ExcessiveOverkill/controller-hardware-dev/KiCad/Main Mezzanine Backplane/Main Mezzanine Backplane.step

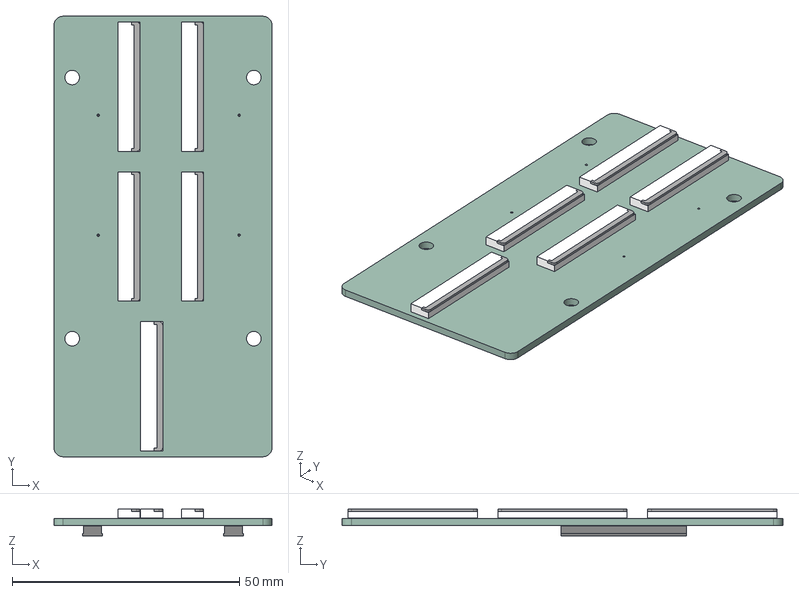
[picture p1: CAD file, 2026-01-15]
KiCad/Main Mezzanine Backplane/Main Mezzanine Backplane.step
48.0 x 97.0 x 5.90 mm
FPC-05FB-50PH20 x 5
BB0500220F-1002C-001 x 2
Main Mezzanine Backplane_PCB
