ExcessiveOverkill/controller-hardware-dev/KiCad/16x Card Module/16x Card Module.step

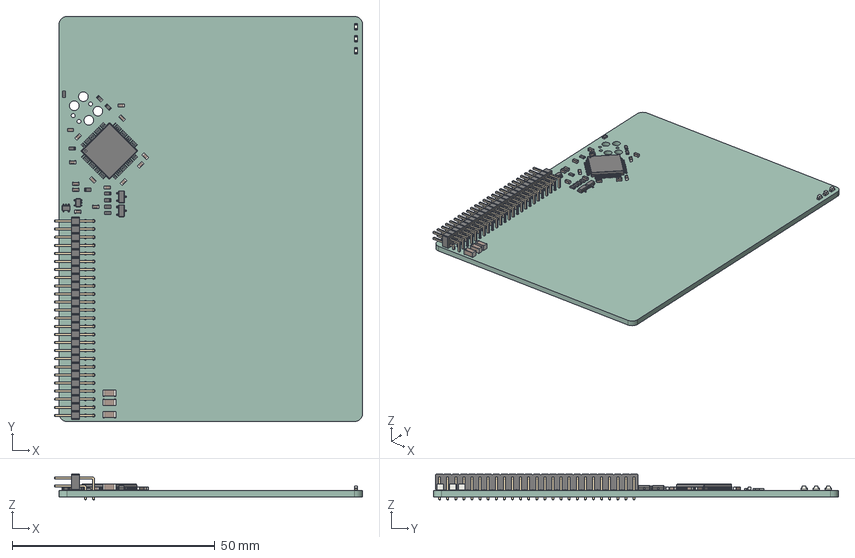
[picture p2: CAD file, 2026-01-15]
KiCad/16x Card Module/16x Card Module.step
76.2 x 100.0 x 6.40 mm
C_0603_1608Metric x 14
C_1206_3216Metric x 3
LED_0603_1608Metric x 3
R_0603_1608Metric x 9
SOT_353_SC_70_5 x 2
SOT_23 x 2
PinHeader_2x25_P200mm_Horizontal
LQFP_64_10x10mm_P05mm
16x Card Module_PCB
