ExcessiveOverkill/controller-hardware-dev/KiCad/Mezzanine Backplane/Mezzanine Backplane.step

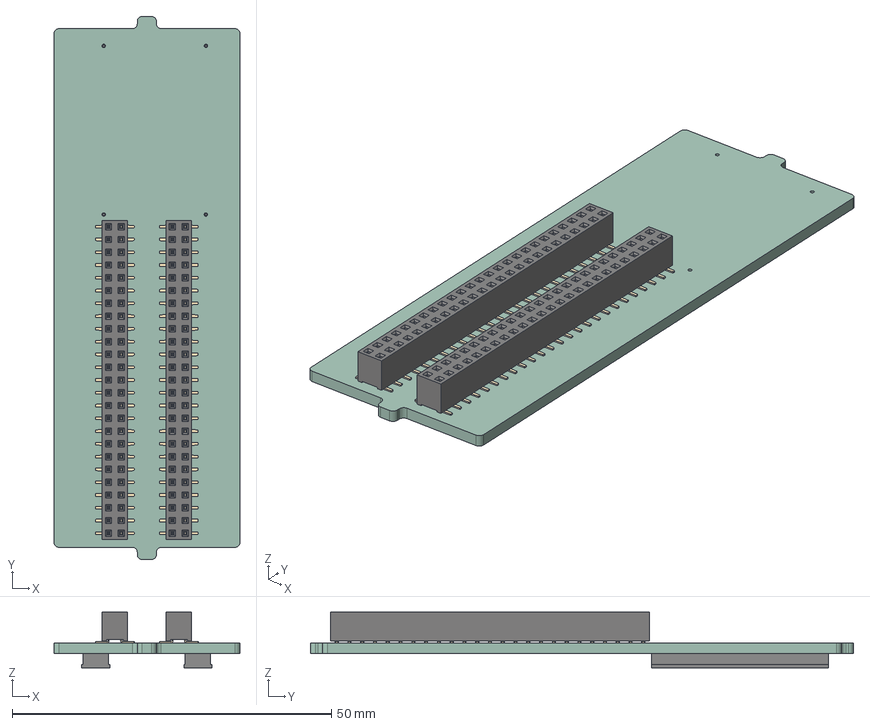
[picture p3: CAD file, 2026-01-15]
KiCad/Mezzanine Backplane/Mezzanine Backplane.step
29.1 x 85.0 x 8.70 mm
PinSocket_2x25_P200mm_Vertical_SMD x 2
BB0500220F-1002C-001 x 2
Mezzanine Backplane_PCB
