ExcessiveOverkill/controller-hardware-dev/KiCad/Mezzanine Jumper up16/Mezzanine Jumper up16.step

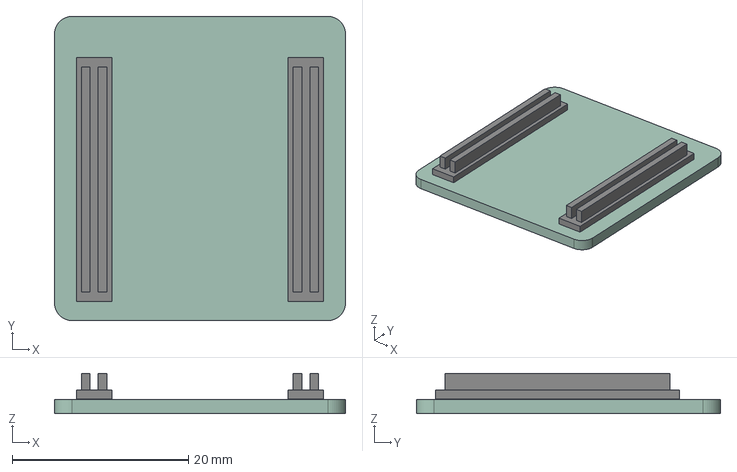
[picture p4: CAD file, 2026-01-15]
KiCad/Mezzanine Jumper up16/Mezzanine Jumper up16.step
33.0 x 34.5 x 4.55 mm
BB0500100M-1002C-001 x 2
Mezzanine jumper_PCB
