ExcessiveOverkill/controller-hardware-dev/KiCad/Modular MiYR interface/Modular MiYR interface.step

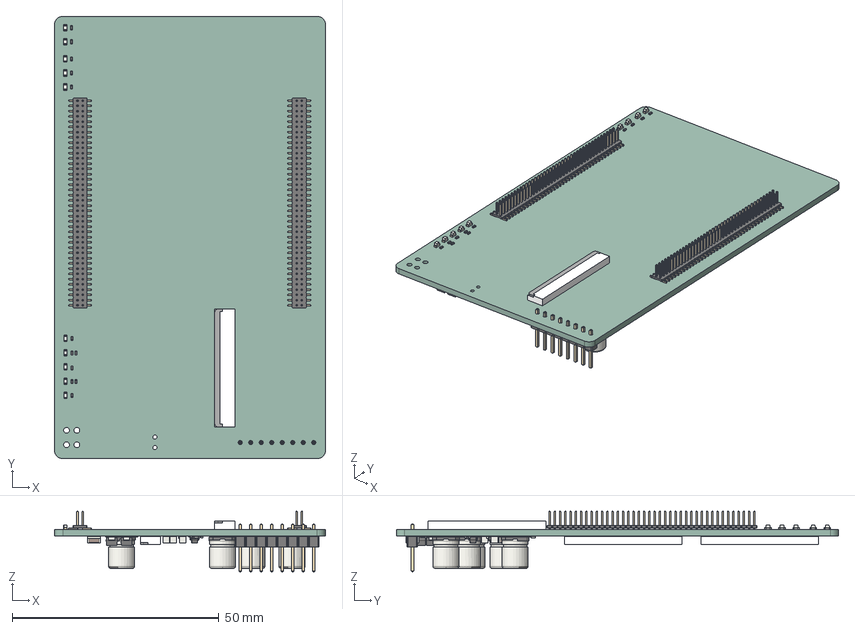
[picture p5: CAD file, 2026-01-15]
KiCad/Modular MiYR interface/Modular MiYR interface.step
65.5 x 107.0 x 14.6 mm
R_0402_1005Metric x 24
LED_0603_1608Metric x 10
PinHeader_2x40_P127mm_Vertical_SMD x 2
FPC-05FB-50PH20 x 5
CP_Elec_63x77 x 7
D_SMA x 3
C_1206_3216Metric x 11
Fuse_1206_3216Metric
PinHeader_1x08_P254mm_Vertical
C_0402_1005Metric x 9
SOT_23_6 x 3
Modular MiYR interface_PCB
