ExcessiveOverkill/controller-hardware-dev/KiCad/Serial Module/Serial Module.kicad_pcb

## KiCad design KiCad/Serial Module/Serial Module.kicad_pcb (2026-10-19)

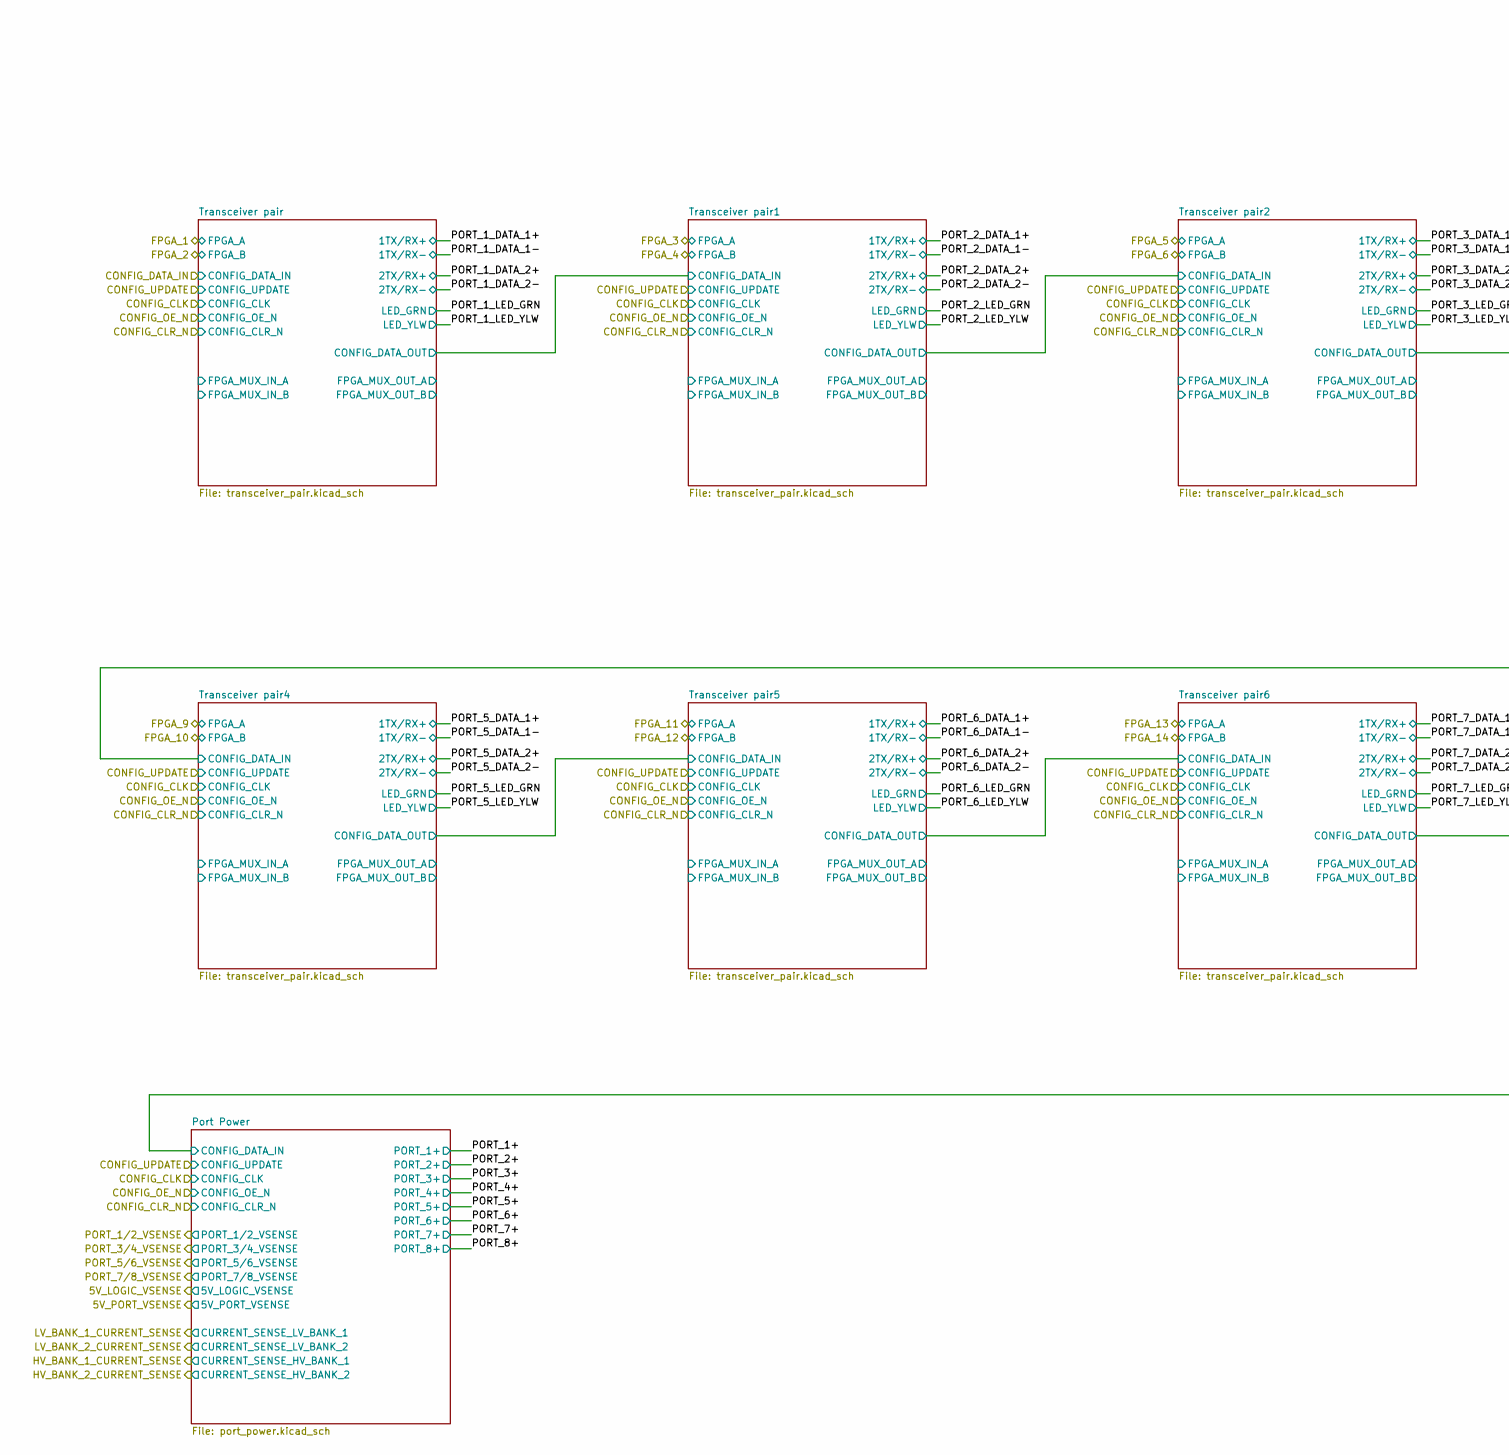
[picture p6: schematic transceivers.kicad_sch, part in row 1, column 1]

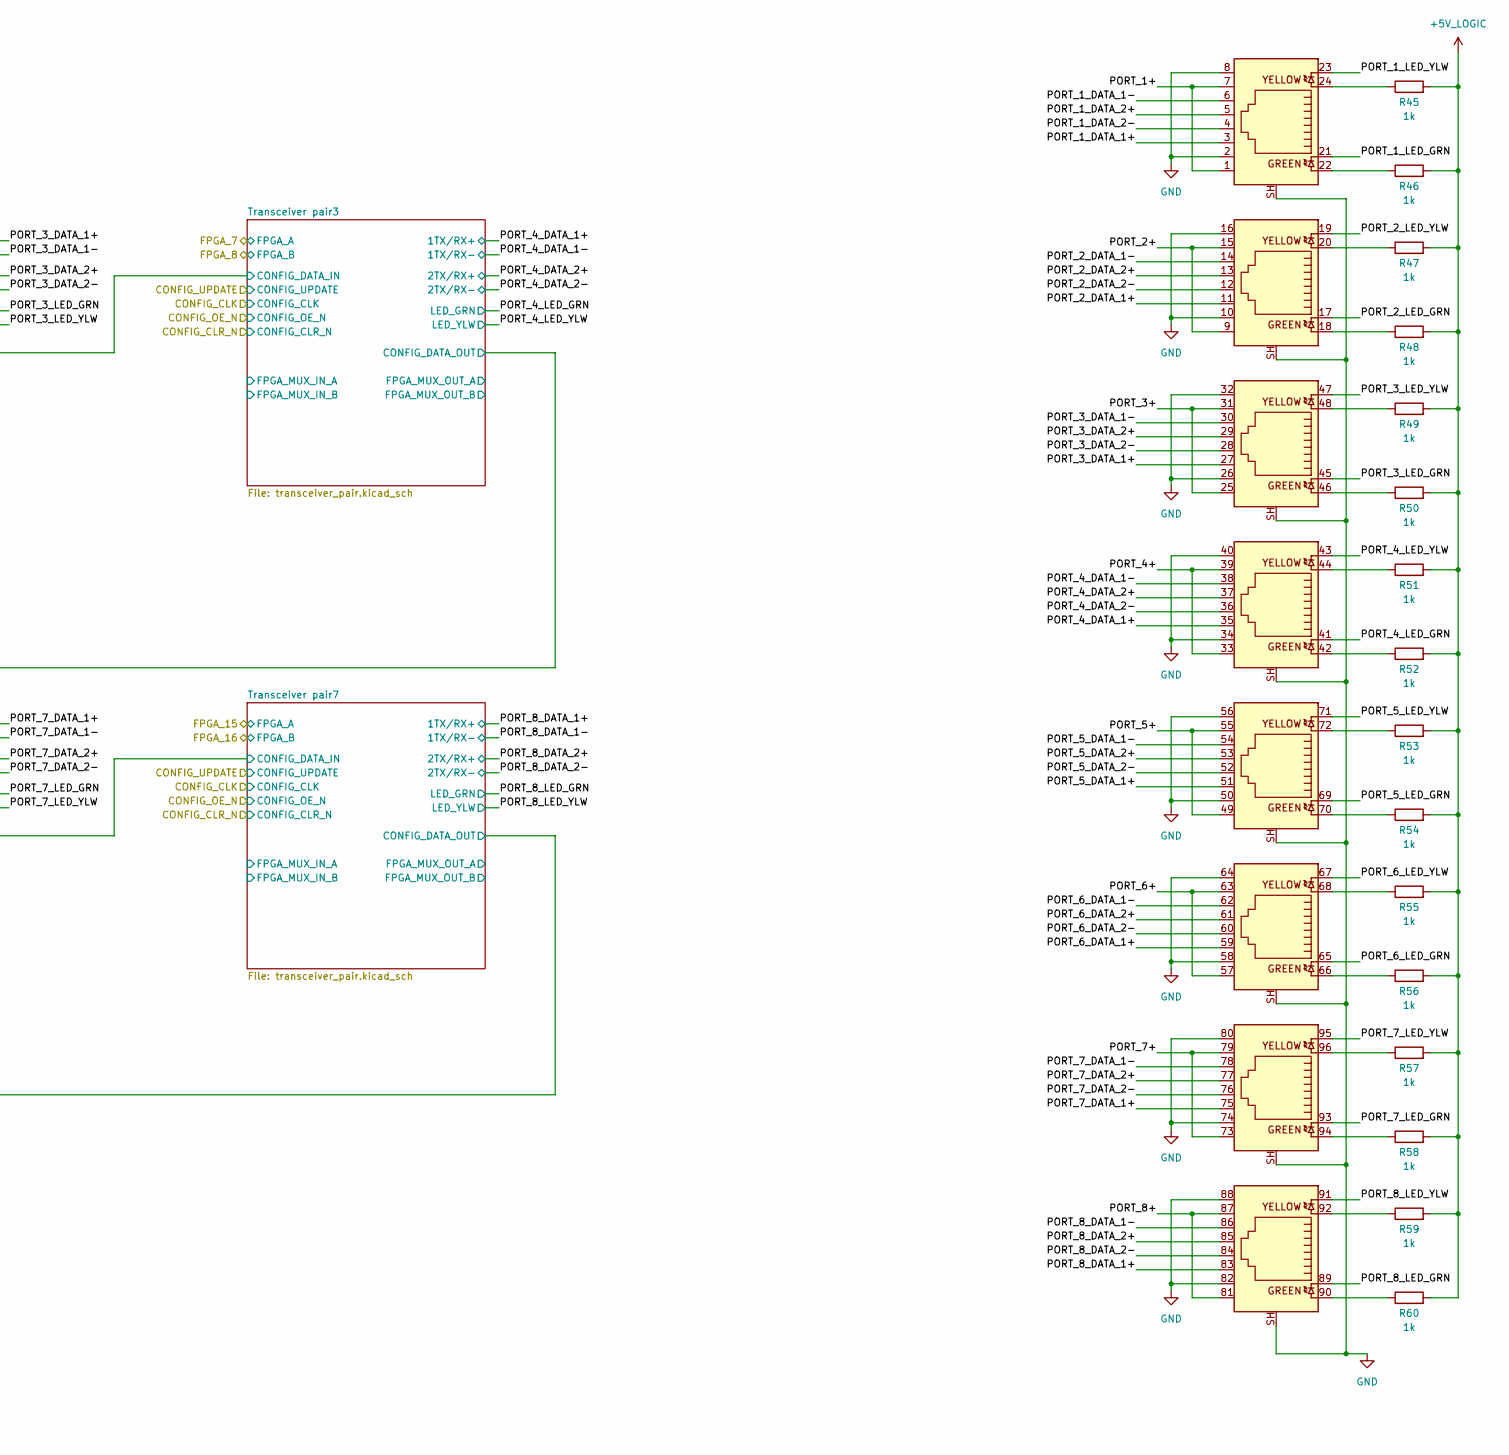
[picture p7: schematic transceivers.kicad_sch, part in row 1, column 2]

Parts:
J3: RJ45-TH_HC-RJ45-059D-2X4-2-04; LCSC# C46261621
R45, R46, R47, R48, R49, R50, R51, R52, R53, R54, R55, R56, R57, R58, R59, R60: 1k; R_0603_1608Metric

Connections:
+5V_LOGIC: R45.2, R46.2, R47.2, R48.2, R49.2, R50.2, R51.2, R52.2, R53.2, R54.2, R55.2, R56.2, R57.2, R58.2, R59.2, R60.2; also elsewhere on the board
/Transceivers/PORT_1+: J3.1, J3.7; also elsewhere on the board
/Transceivers/PORT_1_DATA_1+: J3.3; also elsewhere on the board
/Transceivers/PORT_1_DATA_1-: J3.6; also elsewhere on the board
/Transceivers/PORT_1_DATA_2+: J3.5; also elsewhere on the board
/Transceivers/PORT_1_DATA_2-: J3.4; also elsewhere on the board
/Transceivers/PORT_1_LED_GRN: J3.21; also elsewhere on the board
/Transceivers/PORT_1_LED_YLW: J3.23; also elsewhere on the board
/Transceivers/PORT_2+: J3.9, J3.15; also elsewhere on the board
/Transceivers/PORT_2_DATA_1+: J3.11; also elsewhere on the board
/Transceivers/PORT_2_DATA_1-: J3.14; also elsewhere on the board
/Transceivers/PORT_2_DATA_2+: J3.13; also elsewhere on the board
/Transceivers/PORT_2_DATA_2-: J3.12; also elsewhere on the board
/Transceivers/PORT_2_LED_GRN: J3.17; also elsewhere on the board
/Transceivers/PORT_2_LED_YLW: J3.19; also elsewhere on the board
/Transceivers/PORT_3+: J3.25, J3.31; also elsewhere on the board
/Transceivers/PORT_3_DATA_1+: J3.27; also elsewhere on the board
/Transceivers/PORT_3_DATA_1-: J3.30; also elsewhere on the board
/Transceivers/PORT_3_DATA_2+: J3.29; also elsewhere on the board
/Transceivers/PORT_3_DATA_2-: J3.28; also elsewhere on the board
/Transceivers/PORT_3_LED_GRN: J3.45; also elsewhere on the board
/Transceivers/PORT_3_LED_YLW: J3.47; also elsewhere on the board
/Transceivers/PORT_4+: J3.33, J3.39; also elsewhere on the board
/Transceivers/PORT_4_DATA_1+: J3.35; also elsewhere on the board
/Transceivers/PORT_4_DATA_1-: J3.38; also elsewhere on the board
/Transceivers/PORT_4_DATA_2+: J3.37; also elsewhere on the board
/Transceivers/PORT_4_DATA_2-: J3.36; also elsewhere on the board
/Transceivers/PORT_4_LED_GRN: J3.41; also elsewhere on the board
/Transceivers/PORT_4_LED_YLW: J3.43; also elsewhere on the board
/Transceivers/PORT_5+: J3.49, J3.55; also elsewhere on the board
/Transceivers/PORT_5_DATA_1+: J3.51; also elsewhere on the board
/Transceivers/PORT_5_DATA_1-: J3.54; also elsewhere on the board
/Transceivers/PORT_5_DATA_2+: J3.53; also elsewhere on the board
/Transceivers/PORT_5_DATA_2-: J3.52; also elsewhere on the board
/Transceivers/PORT_5_LED_GRN: J3.69; also elsewhere on the board
/Transceivers/PORT_5_LED_YLW: J3.71; also elsewhere on the board
/Transceivers/PORT_6+: J3.57, J3.63; also elsewhere on the board
/Transceivers/PORT_6_DATA_1+: J3.59; also elsewhere on the board
/Transceivers/PORT_6_DATA_1-: J3.62; also elsewhere on the board
/Transceivers/PORT_6_DATA_2+: J3.61; also elsewhere on the board
/Transceivers/PORT_6_DATA_2-: J3.60; also elsewhere on the board
/Transceivers/PORT_6_LED_GRN: J3.65; also elsewhere on the board
/Transceivers/PORT_6_LED_YLW: J3.67; also elsewhere on the board
/Transceivers/PORT_7+: J3.73, J3.79; also elsewhere on the board
/Transceivers/PORT_7_DATA_1+: J3.75; also elsewhere on the board
/Transceivers/PORT_7_DATA_1-: J3.78; also elsewhere on the board
/Transceivers/PORT_7_DATA_2+: J3.77; also elsewhere on the board
/Transceivers/PORT_7_DATA_2-: J3.76; also elsewhere on the board
/Transceivers/PORT_7_LED_GRN: J3.93; also elsewhere on the board
/Transceivers/PORT_7_LED_YLW: J3.95; also elsewhere on the board
/Transceivers/PORT_8+: J3.81, J3.87; also elsewhere on the board
/Transceivers/PORT_8_DATA_1+: J3.83; also elsewhere on the board
/Transceivers/PORT_8_DATA_1-: J3.86; also elsewhere on the board
/Transceivers/PORT_8_DATA_2+: J3.85; also elsewhere on the board
/Transceivers/PORT_8_DATA_2-: J3.84; also elsewhere on the board
/Transceivers/PORT_8_LED_GRN: J3.89; also elsewhere on the board
/Transceivers/PORT_8_LED_YLW: J3.91; also elsewhere on the board
GND: J3.2, J3.8, J3.10, J3.16, J3.26, J3.32, J3.34, J3.40, J3.50, J3.56, J3.58, J3.64, J3.74, J3.80, J3.82, J3.88, J3.SH; also elsewhere on the board
unnamed: J3.18, R48.1
unnamed: J3.20, R47.1
unnamed: J3.22, R46.1
unnamed: J3.24, R45.1
unnamed: J3.42, R52.1
unnamed: J3.44, R51.1
unnamed: J3.46, R50.1
unnamed: J3.48, R49.1
unnamed: J3.66, R56.1
unnamed: J3.68, R55.1
unnamed: J3.70, R54.1
unnamed: J3.72, R53.1
unnamed: J3.90, R60.1
unnamed: J3.92, R59.1
unnamed: J3.94, R58.1
unnamed: J3.96, R57.1

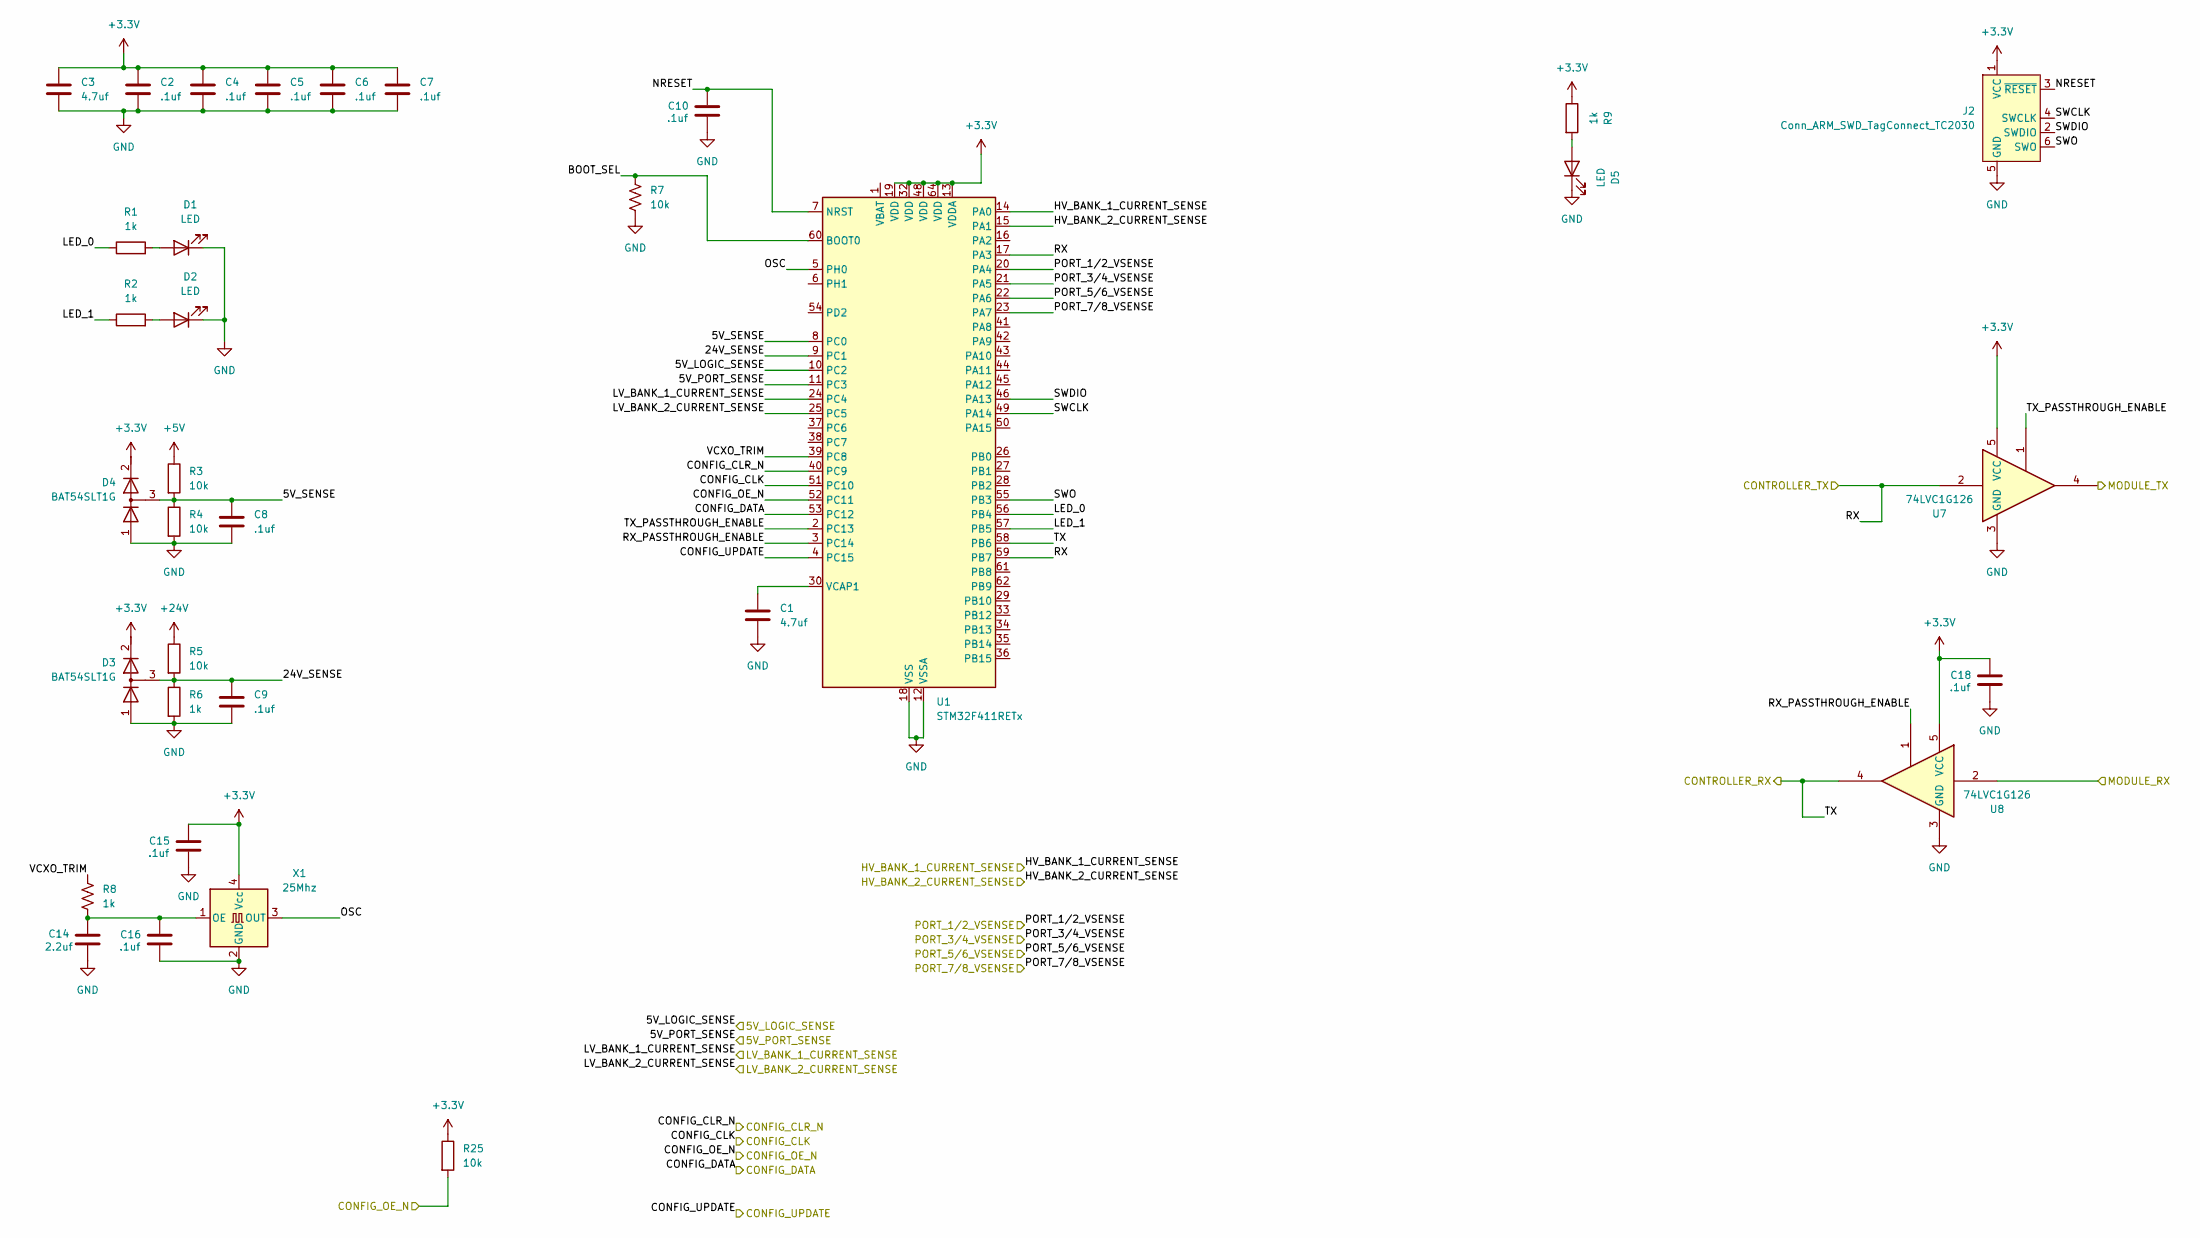
[picture p8: schematic MCU.kicad_sch]

Parts:
C1, C3: 4.7uf; C_0603_1608Metric
C2, C4, C5, C6, C7, C8, C9: .1uf; C_0603_1608Metric
C10, C15, C16, C18: .1uf; C_0603_1608Metric; Part number CC0402KRX5R9BB104; LCSC# C105882
C14: 2.2uf; C_0603_1608Metric; Part number CL31B225KBHNNNE; LCSC# C50254
D1, D2, D5: LED; LED_0603_1608Metric
D3, D4: BAT54SLT1G; SOT-23; Part number LBAT54SLT1G; LCSC# C12765
J2: Conn_ARM_SWD_TagConnect_TC2030; Tag-Connect_TC2030-IDC-FP_2x03_P1.27mm_Vertical
R1, R2, R6, R9: 1k; R_0603_1608Metric
R3, R4, R5, R25: 10k; R_0603_1608Metric
R7: 10k; R_0603_1608Metric; Part number RC0402FR-0710KL; LCSC# C60490
R8: 1k; R_0603_1608Metric; Part number RC0402FR-071KL; LCSC# C106235
U1: STM32F411RETx; LQFP-64_10x10mm_P0.5mm_smaller_pads
U7, U8: 74LVC1G126; SOT-353_SC-70-5; Part number 74LVC1G126CT05ARCQ; LCSC# C48391411
X1: 25Mhz; Oscillator_SMD_SeikoEpson_SG8002CE-4Pin_3.2x2.5mm; Part number SX3V25.000B20100F30TNN; LCSC# C5179998

Connections:
+3.3V: C2.1, C3.1, C4.1, C5.1, C6.1, C7.1, C15.2, C18.2, D3.2 (K), D4.2 (K), J2.1 (VCC), R9.1, R25.1, U1.13 (VDDA), U1.19 (VDD), U1.32 (VDD), U1.48 (VDD), U1.64 (VDD), U7.5 (VCC), U8.5 (VCC), X1.4 (Vcc); also elsewhere on the board
+5V: R3.1; also elsewhere on the board
+24V: R5.1; also elsewhere on the board
/FPGA Connector/MODULE_RX: U8.2; also elsewhere on the board
/FPGA Connector/MODULE_TX: U7.4; also elsewhere on the board
/MCU/5V_LOGIC_SENSE: U1.10 (PC2); also elsewhere on the board
/MCU/5V_PORT_SENSE: U1.11 (PC3); also elsewhere on the board
/MCU/5V_SENSE: C8.1, D4.3 (common), R3.2, R4.1, U1.8 (PC0)
/MCU/24V_SENSE: C9.1, D3.3 (common), R5.2, R6.1, U1.9 (PC1)
/MCU/BOOT_SEL: R7.2, U1.60 (BOOT0)
/MCU/CONFIG_CLK: U1.51 (PC10); also elsewhere on the board
/MCU/CONFIG_CLR_N: U1.40 (PC9); also elsewhere on the board
/MCU/CONFIG_DATA: U1.53 (PC12); also elsewhere on the board
/MCU/CONFIG_OE_N: R25.2, U1.52 (PC11); also elsewhere on the board
/MCU/CONFIG_UPDATE: U1.4 (PC15); also elsewhere on the board
/MCU/HV_BANK_1_CURRENT_SENSE: U1.14 (PA0); also elsewhere on the board
/MCU/HV_BANK_2_CURRENT_SENSE: U1.15 (PA1); also elsewhere on the board
/MCU/LED_0: R1.1, U1.56 (PB4)
/MCU/LED_1: R2.1, U1.57 (PB5)
/MCU/LV_BANK_1_CURRENT_SENSE: U1.24 (PC4); also elsewhere on the board
/MCU/LV_BANK_2_CURRENT_SENSE: U1.25 (PC5); also elsewhere on the board
/MCU/NRESET: C10.2, J2.3 (~RESET), U1.7 (NRST)
/MCU/OSC: U1.5 (PH0), X1.3 (OUT)
/MCU/PORT_1/2_VSENSE: U1.20 (PA4); also elsewhere on the board
/MCU/PORT_3/4_VSENSE: U1.21 (PA5); also elsewhere on the board
/MCU/PORT_5/6_VSENSE: U1.22 (PA6); also elsewhere on the board
/MCU/PORT_7/8_VSENSE: U1.23 (PA7); also elsewhere on the board
/MCU/RX: U1.17 (PA3), U1.59 (PB7), U7.2; also elsewhere on the board
/MCU/RX_PASSTHROUGH_ENABLE: U1.3 (PC14), U8.1
/MCU/SWCLK: J2.4 (SWCLK), U1.49 (PA14)
/MCU/SWDIO: J2.2 (SWDIO), U1.46 (PA13)
/MCU/SWO: J2.6 (SWO), U1.55 (PB3)
/MCU/TX: U1.58 (PB6), U8.4; also elsewhere on the board
/MCU/TX_PASSTHROUGH_ENABLE: U1.2 (PC13), U7.1
/MCU/VCXO_TRIM: R8.1, U1.39 (PC8)
GND: C1.2, C2.2, C3.2, C4.2, C5.2, C6.2, C7.2, C8.2, C9.2, C10.1, C14.1, C15.1, C16.1, C18.1, D1.1 (K), D2.1 (K), D3.1 (A), D4.1 (A), D5.1 (K), J2.5 (GND), R4.2, R6.2, R7.1, U1.12 (VSSA), U1.18 (VSS), U1.31 (VSS), U1.47 (VSS), U1.63 (VSS), U7.3 (GND), U8.3 (GND), X1.2 (GND); also elsewhere on the board
unnamed: D1.2 (A), R1.2
unnamed: D2.2 (A), R2.2
unnamed: D5.2 (A), R9.2
unnamed: C1.1, U1.30 (VCAP1)
unnamed: C14.2, C16.2, R8.2, X1.1 (OE)

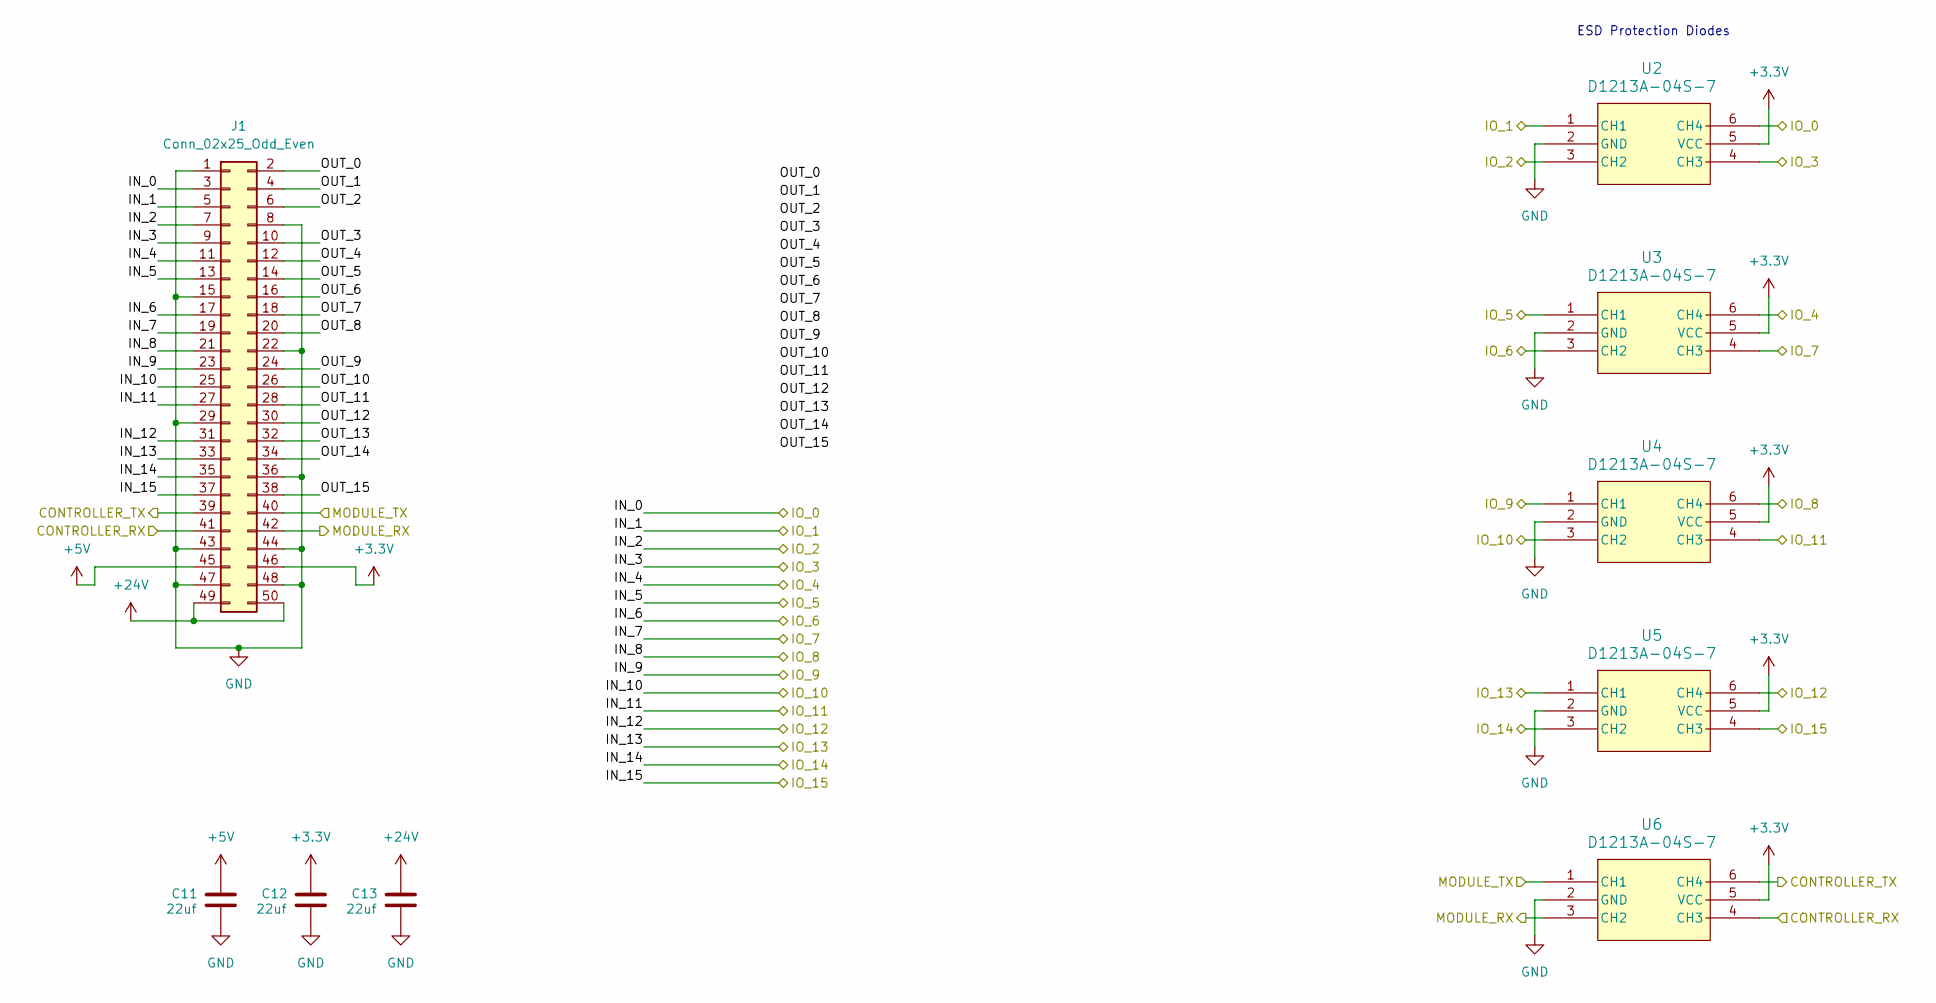
[picture p9: schematic FPGA_Connector.kicad_sch]

Parts:
C11, C12, C13: 22uf; C_1206_3216Metric; Part number CL31A226KAHNNNE; LCSC# C12891
J1: Conn_02x25_Odd_Even; 16x_modular_card; Part Number X4621WR-2x25I-C40D28; LCSC# C2883281
U2, U3, U4, U5, U6: D1213A-04S-7; SOT-363_DIO; Part Number D1213A-04S-7-ES; LCSC# C41409235

Connections:
+3.3V: C12.2, J1.46, U2.5 (VCC), U3.5 (VCC), U4.5 (VCC), U5.5 (VCC), U6.5 (VCC); also elsewhere on the board
+5V: C11.2, J1.45; also elsewhere on the board
+24V: C13.2, J1.49, J1.50; also elsewhere on the board
/FPGA Connector/IN_0: J1.3, U2.6 (CH4); also elsewhere on the board
/FPGA Connector/IN_1: J1.5, U2.1 (CH1); also elsewhere on the board
/FPGA Connector/IN_2: J1.7, U2.3 (CH2); also elsewhere on the board
/FPGA Connector/IN_3: J1.9, U2.4 (CH3); also elsewhere on the board
/FPGA Connector/IN_4: J1.11, U3.6 (CH4); also elsewhere on the board
/FPGA Connector/IN_5: J1.13, U3.1 (CH1); also elsewhere on the board
/FPGA Connector/IN_6: J1.17, U3.3 (CH2); also elsewhere on the board
/FPGA Connector/IN_7: J1.19, U3.4 (CH3); also elsewhere on the board
/FPGA Connector/IN_8: J1.21, U4.6 (CH4); also elsewhere on the board
/FPGA Connector/IN_9: J1.23, U4.1 (CH1); also elsewhere on the board
/FPGA Connector/IN_10: J1.25, U4.3 (CH2); also elsewhere on the board
/FPGA Connector/IN_11: J1.27, U4.4 (CH3); also elsewhere on the board
/FPGA Connector/IN_12: J1.31, U5.6 (CH4); also elsewhere on the board
/FPGA Connector/IN_13: J1.33, U5.1 (CH1); also elsewhere on the board
/FPGA Connector/IN_14: J1.35, U5.3 (CH2); also elsewhere on the board
/FPGA Connector/IN_15: J1.37, U5.4 (CH3); also elsewhere on the board
/FPGA Connector/MODULE_RX: J1.42, U6.3 (CH2); also elsewhere on the board
/FPGA Connector/MODULE_TX: J1.40, U6.1 (CH1); also elsewhere on the board
/FPGA Connector/OUT_0: J1.2
/FPGA Connector/OUT_1: J1.4
/FPGA Connector/OUT_2: J1.6
/FPGA Connector/OUT_3: J1.10
/FPGA Connector/OUT_4: J1.12
/FPGA Connector/OUT_5: J1.14
/FPGA Connector/OUT_6: J1.16
/FPGA Connector/OUT_7: J1.18
/FPGA Connector/OUT_8: J1.20
/FPGA Connector/OUT_9: J1.24
/FPGA Connector/OUT_10: J1.26
/FPGA Connector/OUT_11: J1.28
/FPGA Connector/OUT_12: J1.30
/FPGA Connector/OUT_13: J1.32
/FPGA Connector/OUT_14: J1.34
/FPGA Connector/OUT_15: J1.38
/MCU/RX: J1.39, U6.6 (CH4); also elsewhere on the board
/MCU/TX: J1.41, U6.4 (CH3); also elsewhere on the board
GND: C11.1, C12.1, C13.1, J1.1, J1.8, J1.15, J1.22, J1.29, J1.36, J1.43, J1.44, J1.47, J1.48, U2.2 (GND), U3.2 (GND), U4.2 (GND), U5.2 (GND), U6.2 (GND); also elsewhere on the board

Notes on the sheet:
ESD Protection Diodes
