ExcessiveOverkill/controller-hardware-dev/KiCad/Serial Module/Serial Module.kicad_pcb

## KiCad design KiCad/Serial Module/Serial Module.kicad_pcb (continued)

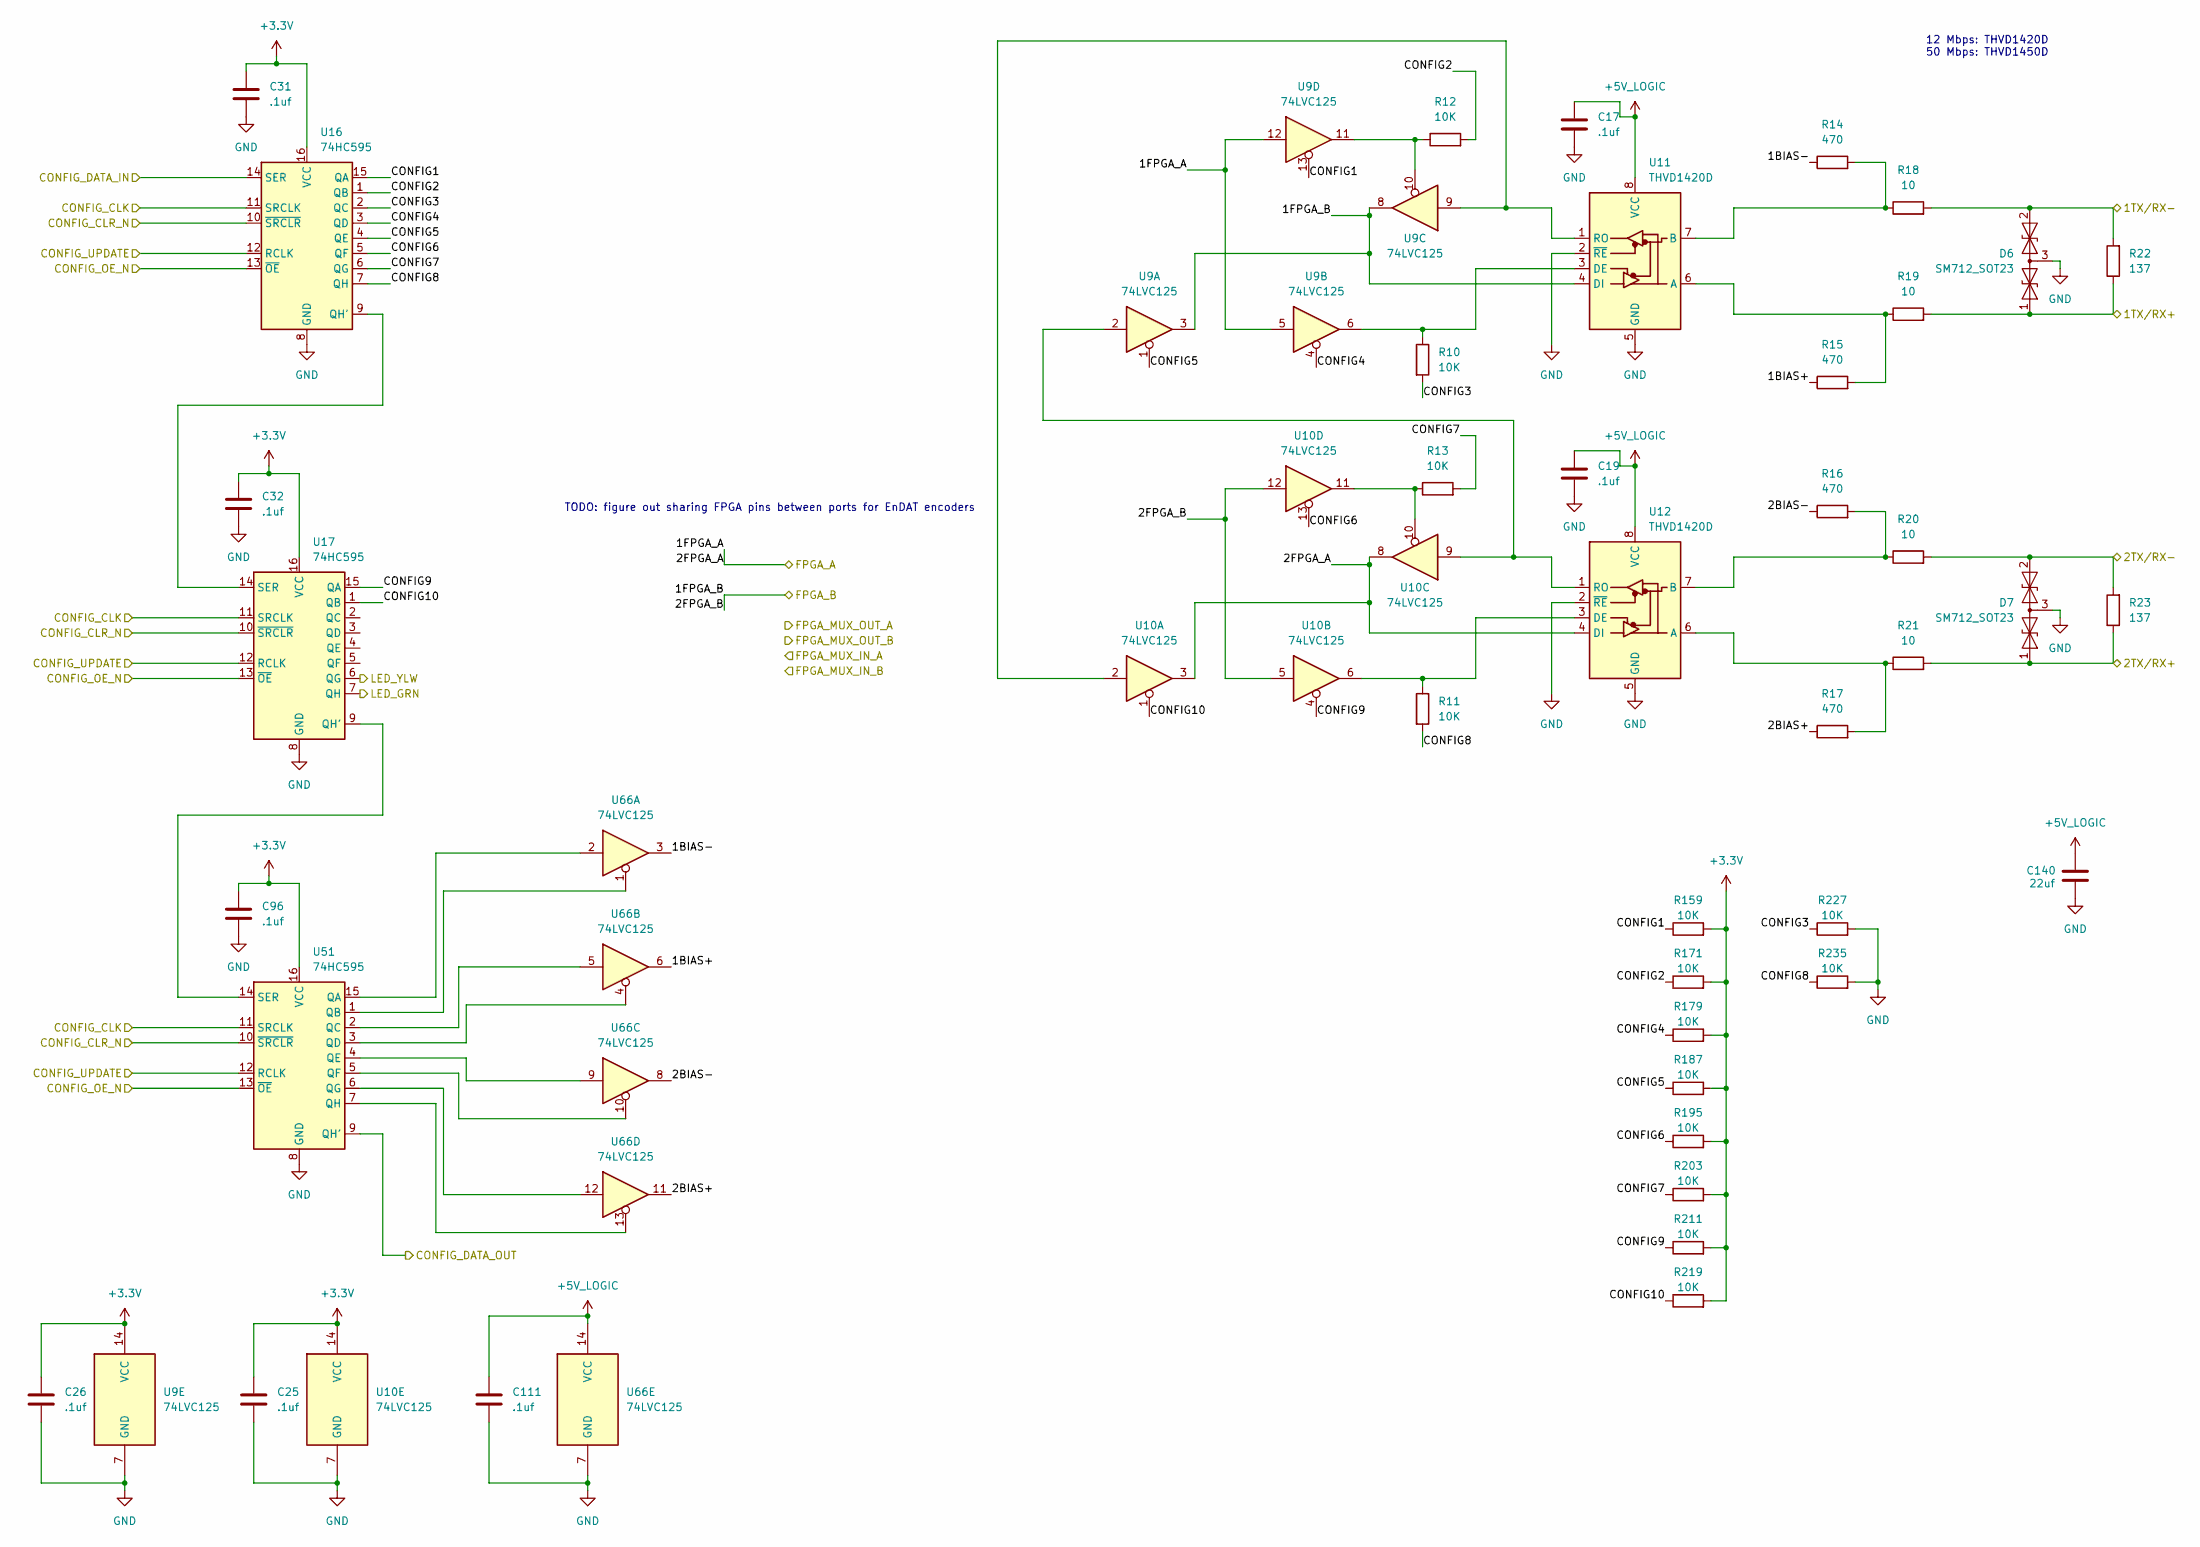
[picture p10: schematic transceiver_pair.kicad_sch]

Parts:
C17, C19, C25, C26, C31, C32, C96, C111: .1uf; C_0603_1608Metric
C140: 22uf; C_1206_3216Metric; Part number CL31A226KAHNNNE; LCSC# C12891
D6, D7: SM712_SOT23; SOT-23
R10, R11, R12, R13, R159, R171, R179, R187, R195, R203, R211, R219, R227, R235: 10K; R_0603_1608Metric
R14, R15, R16, R17: 470; R_0603_1608Metric
R18, R19: 10; R_0603_1608Metric
R20, R21: 10; R_0402_1005Metric
R22, R23: 137; R_0603_1608Metric
U9, U10: 74LVC125; DHVQFN-14-1EP_2.5x3mm_P0.5mm_EP1x1.5mm; LCSC# C54411083
U11, U12: THVD1420D; SOIC-8_4.9x3.91mm_P1.27mm; Part Number THVD1420DR; LCSC# C3235215
U16, U17, U51: 74HC595; TSSOP-16_4.4x5mm_P0.65mm; LCSC# C5948
U66: 74LVC125; DHVQFN-14-1EP_2.5x3mm_P0.5mm_EP1x1.5mm

Connections:
+3.3V: C25.1, C26.1, C31.1, C32.1, C96.1, R159.2, R171.2, R179.2, R187.2, R195.2, R203.2, R211.2, R219.2, U9.14 (VCC), U10.14 (VCC), U16.16 (VCC), U17.16 (VCC), U51.16 (VCC); also elsewhere on the board
+5V_LOGIC: C17.1, C19.1, C111.1, C140.2, U11.8 (VCC), U12.8 (VCC), U66.14 (VCC); also elsewhere on the board
/FPGA Connector/IN_0: U9.5, U9.12, U10.3, U10.8, U12.4 (DI); also elsewhere on the board
/FPGA Connector/IN_1: U9.3, U9.8, U10.5, U10.12, U11.4 (DI); also elsewhere on the board
/MCU/CONFIG_CLK: U16.11 (SRCLK), U17.11 (SRCLK), U51.11 (SRCLK); also elsewhere on the board
/MCU/CONFIG_CLR_N: U16.10 (~SRCLR), U17.10 (~SRCLR), U51.10 (~SRCLR); also elsewhere on the board
/MCU/CONFIG_DATA: U16.14 (SER); also elsewhere on the board
/MCU/CONFIG_OE_N: U16.13 (~OE), U17.13 (~OE), U51.13 (~OE); also elsewhere on the board
/MCU/CONFIG_UPDATE: U16.12 (RCLK), U17.12 (RCLK), U51.12 (RCLK); also elsewhere on the board
/Transceivers/PORT_1_DATA_1+: D6.1 (A1), R19.2, R22.1; also elsewhere on the board
/Transceivers/PORT_1_DATA_1-: D6.2 (A2), R18.2, R22.2; also elsewhere on the board
/Transceivers/PORT_1_DATA_2+: D7.1 (A1), R21.2, R23.1; also elsewhere on the board
/Transceivers/PORT_1_DATA_2-: D7.2 (A2), R20.2, R23.2; also elsewhere on the board
/Transceivers/PORT_1_LED_GRN: U17.7 (QH); also elsewhere on the board
/Transceivers/PORT_1_LED_YLW: U17.6 (QG); also elsewhere on the board
/Transceivers/Transceiver pair/1BIAS+: R15.1, U66.6
/Transceivers/Transceiver pair/1BIAS-: R14.1, U66.3
/Transceivers/Transceiver pair/2BIAS+: R17.1, U66.11
/Transceivers/Transceiver pair/2BIAS-: R16.1, U66.8
/Transceivers/Transceiver pair/CONFIG1: R159.1, U9.13, U16.15 (QA)
/Transceivers/Transceiver pair/CONFIG2: R12.2, R171.1, U16.1 (QB)
/Transceivers/Transceiver pair/CONFIG3: R10.2, R227.1, U16.2 (QC)
/Transceivers/Transceiver pair/CONFIG4: R179.1, U9.4, U16.3 (QD)
/Transceivers/Transceiver pair/CONFIG5: R187.1, U9.1, U16.4 (QE)
/Transceivers/Transceiver pair/CONFIG6: R195.1, U10.13, U16.5 (QF)
/Transceivers/Transceiver pair/CONFIG7: R13.2, R203.1, U16.6 (QG)
/Transceivers/Transceiver pair/CONFIG8: R11.2, R235.1, U16.7 (QH)
/Transceivers/Transceiver pair/CONFIG9: R211.1, U10.4, U17.15 (QA)
/Transceivers/Transceiver pair/CONFIG10: R219.1, U10.1, U17.1 (QB)
/Transceivers/Transceiver pair/CONFIG_DATA_OUT: U51.9 (QH'); also elsewhere on the board
GND: C17.2, C19.2, C25.2, C26.2, C31.2, C32.2, C96.2, C111.2, C140.1, D6.3 (common), D7.3 (common), R227.2, R235.2, U9.7 (GND), U10.7 (GND), U11.2 (~RE), U11.5 (GND), U12.2 (~RE), U12.5 (GND), U16.8 (GND), U17.8 (GND), U51.8 (GND), U66.7 (GND); also elsewhere on the board
unnamed: R12.1, U9.10, U9.11
unnamed: R13.1, U10.10, U10.11
unnamed: R15.2, R19.1, U11.6 (A)
unnamed: R14.2, R18.1, U11.7 (B)
unnamed: R10.1, U9.6, U11.3 (DE)
unnamed: U9.9, U10.2, U11.1 (RO)
unnamed: R17.2, R21.1, U12.6 (A)
unnamed: R16.2, R20.1, U12.7 (B)
unnamed: R11.1, U10.6, U12.3 (DE)
unnamed: U9.2, U10.9, U12.1 (RO)
unnamed: U16.9 (QH'), U17.14 (SER)
unnamed: U17.9 (QH'), U51.14 (SER)
unnamed: U51.15 (QA), U66.2
unnamed: U51.1 (QB), U66.1
unnamed: U51.2 (QC), U66.5
unnamed: U51.3 (QD), U66.4
unnamed: U51.4 (QE), U66.9
unnamed: U51.5 (QF), U66.10
unnamed: U51.6 (QG), U66.12
unnamed: U51.7 (QH), U66.13

Parts of its further copies:
C68, C69, C70, C71, C72, C73, C74, C75, C77, C78, C79, C80, C81, C82, C83, C84, C86, C87, C88, C89, C90, C91, C92, C93, C95, C97, C98, C99, C100, C101, C102, C103, C105, C106, C107, C108, C109, C117, C118, C119, C121, C122, C123, C124, C125, C126, C127, C128, C130, C131, C141, C142, C143, C144, C145, C146: .1uf; C_0603_1608Metric
C76, C85, C94, C104, C120, C129, C147: 22uf; C_1206_3216Metric; Part number CL31A226KAHNNNE; LCSC# C12891
D36, D37, D38, D39, D40, D41, D42, D43, D44, D45, D46, D47, D48, D49: SM712_SOT23; SOT-23
R61, R62, R63, R64, R65, R66, R67, R68, R69, R70, R71, R72, R77, R78, R85, R86, R87, R88, R89, R90, R91, R92, R93, R94, R95, R96, R101, R102, R109, R110, R111, R112, R113, R114, R115, R116, R117, R118, R119, R120, R125, R126, R133, R134, R135, R136, R137, R138, R139, R140, R141, R142, R143, R144, R149, R150, R157, R158, R164, R165, R166, R167, R168, R169, R170, R172, R173, R174, R180, R181, R189, R190, R191, R192, R193, R194, R196, R197, R198, R199, R200, R201, R207, R208, R216, R217, R218, R220, R221, R222, R223, R224, R225, R226, R228, R229, R234, R236: 10K; R_0603_1608Metric
R73, R74, R75, R76, R97, R98, R99, R100, R121, R122, R123, R124, R145, R146, R147, R148, R175, R176, R177, R178, R202, R204, R205, R206, R230, R231, R232, R233: 470; R_0603_1608Metric
R79, R80, R103, R104, R127, R128, R151, R152, R182, R183, R209, R210, R237, R238: 10; R_0603_1608Metric
R81, R82, R105, R106, R129, R130, R153, R154, R184, R185, R212, R213, R239, R240: 10; R_0402_1005Metric
R83, R84, R107, R108, R131, R132, R155, R156, R186, R188, R214, R215, R241, R242: 137; R_0603_1608Metric
U13, U27, U31, U35, U39, U43, U47, U52, U56, U60, U64, U70, U74, U78: 74LVC125; DHVQFN-14-1EP_2.5x3mm_P0.5mm_EP1x1.5mm; LCSC# C54411083
U24, U25, U26, U32, U33, U34, U40, U41, U42, U48, U49, U50, U57, U58, U59, U67, U68, U69, U75, U76, U77: 74HC595; TSSOP-16_4.4x5mm_P0.65mm; LCSC# C5948
U28, U36, U44, U53, U61, U71, U79: 74LVC125; DHVQFN-14-1EP_2.5x3mm_P0.5mm_EP1x1.5mm
U29, U30, U37, U38, U45, U46, U54, U55, U62, U63, U72, U73, U80, U81: THVD1420D; SOIC-8_4.9x3.91mm_P1.27mm; Part Number THVD1420DR; LCSC# C3235215

Connections of its further copies:
+3.3V: C68.1, C69.1, C70.1, C71.1, C72.1, C77.1, C78.1, C79.1, C80.1, C81.1, C86.1, C87.1, C88.1, C89.1, C90.1, C95.1, C97.1, C98.1, C99.1, C100.1, C105.1, C106.1, C107.1, C108.1, C109.1, C121.1, C122.1, C123.1, C124.1, C125.1, C130.1, C131.1, C141.1, C142.1, C143.1, R65.2, R66.2, R67.2, R68.2, R69.2, R70.2, R71.2, R72.2, R89.2, R90.2, R91.2, R92.2, R93.2, R94.2, R95.2, R96.2, R113.2, R114.2, R115.2, R116.2, R117.2, R118.2, R119.2, R120.2, R137.2, R138.2, R139.2, R140.2, R141.2, R142.2, R143.2, R144.2, R166.2, R167.2, R168.2, R169.2, R170.2, R172.2, R173.2, R174.2, R193.2, R194.2, R196.2, R197.2, R198.2, R199.2, R200.2, R201.2, R221.2, R222.2, R223.2, R224.2, R225.2, R226.2, R228.2, R229.2, U13.14 (VCC), U24.16 (VCC), U25.16 (VCC), U26.16 (VCC), U27.14 (VCC), U31.14 (VCC), U32.16 (VCC), U33.16 (VCC), U34.16 (VCC), U35.14 (VCC), U39.14 (VCC), U40.16 (VCC), U41.16 (VCC), U42.16 (VCC), U43.14 (VCC), U47.14 (VCC), U48.16 (VCC), U49.16 (VCC), U50.16 (VCC), U52.14 (VCC), U56.14 (VCC), U57.16 (VCC), U58.16 (VCC), U59.16 (VCC), U60.14 (VCC), U64.14 (VCC), U67.16 (VCC), U68.16 (VCC), U69.16 (VCC), U70.14 (VCC), U74.14 (VCC), U75.16 (VCC), U76.16 (VCC), U77.16 (VCC), U78.14 (VCC); also elsewhere on the board
+5V_LOGIC: C73.1, C74.1, C75.1, C76.2, C82.1, C83.1, C84.1, C85.2, C91.1, C92.1, C93.1, C94.2, C101.1, C102.1, C103.1, C104.2, C117.1, C118.1, C119.1, C120.2, C126.1, C127.1, C128.1, C129.2, C144.1, C145.1, C146.1, C147.2, U28.14 (VCC), U29.8 (VCC), U30.8 (VCC), U36.14 (VCC), U37.8 (VCC), U38.8 (VCC), U44.14 (VCC), U45.8 (VCC), U46.8 (VCC), U53.14 (VCC), U54.8 (VCC), U55.8 (VCC), U61.14 (VCC), U62.8 (VCC), U63.8 (VCC), U71.14 (VCC), U72.8 (VCC), U73.8 (VCC), U79.14 (VCC), U80.8 (VCC), U81.8 (VCC); also elsewhere on the board
/FPGA Connector/IN_2: U13.5, U13.12, U27.3, U27.8, U30.4 (DI); also elsewhere on the board
/FPGA Connector/IN_3: U13.3, U13.8, U27.5, U27.12, U29.4 (DI); also elsewhere on the board
/FPGA Connector/IN_4: U31.5, U31.12, U35.3, U35.8, U38.4 (DI); also elsewhere on the board
/FPGA Connector/IN_5: U31.3, U31.8, U35.5, U35.12, U37.4 (DI); also elsewhere on the board
/FPGA Connector/IN_6: U39.5, U39.12, U43.3, U43.8, U46.4 (DI); also elsewhere on the board
/FPGA Connector/IN_7: U39.3, U39.8, U43.5, U43.12, U45.4 (DI); also elsewhere on the board
/FPGA Connector/IN_8: U47.5, U47.12, U52.3, U52.8, U55.4 (DI); also elsewhere on the board
/FPGA Connector/IN_9: U47.3, U47.8, U52.5, U52.12, U54.4 (DI); also elsewhere on the board
/FPGA Connector/IN_10: U56.5, U56.12, U60.3, U60.8, U63.4 (DI); also elsewhere on the board
/FPGA Connector/IN_11: U56.3, U56.8, U60.5, U60.12, U62.4 (DI); also elsewhere on the board
/FPGA Connector/IN_12: U64.5, U64.12, U70.3, U70.8, U73.4 (DI); also elsewhere on the board
/FPGA Connector/IN_13: U64.3, U64.8, U70.5, U70.12, U72.4 (DI); also elsewhere on the board
/FPGA Connector/IN_14: U74.5, U74.12, U78.3, U78.8, U81.4 (DI); also elsewhere on the board
/FPGA Connector/IN_15: U74.3, U74.8, U78.5, U78.12, U80.4 (DI); also elsewhere on the board
/MCU/CONFIG_CLK: U24.11 (SRCLK), U25.11 (SRCLK), U26.11 (SRCLK), U32.11 (SRCLK), U33.11 (SRCLK), U34.11 (SRCLK), U40.11 (SRCLK), U41.11 (SRCLK), U42.11 (SRCLK), U48.11 (SRCLK), U49.11 (SRCLK), U50.11 (SRCLK), U57.11 (SRCLK), U58.11 (SRCLK), U59.11 (SRCLK), U67.11 (SRCLK), U68.11 (SRCLK), U69.11 (SRCLK), U75.11 (SRCLK), U76.11 (SRCLK), U77.11 (SRCLK); also elsewhere on the board
/MCU/CONFIG_CLR_N: U24.10 (~SRCLR), U25.10 (~SRCLR), U26.10 (~SRCLR), U32.10 (~SRCLR), U33.10 (~SRCLR), U34.10 (~SRCLR), U40.10 (~SRCLR), U41.10 (~SRCLR), U42.10 (~SRCLR), U48.10 (~SRCLR), U49.10 (~SRCLR), U50.10 (~SRCLR), U57.10 (~SRCLR), U58.10 (~SRCLR), U59.10 (~SRCLR), U67.10 (~SRCLR), U68.10 (~SRCLR), U69.10 (~SRCLR), U75.10 (~SRCLR), U76.10 (~SRCLR), U77.10 (~SRCLR); also elsewhere on the board
/MCU/CONFIG_OE_N: U24.13 (~OE), U25.13 (~OE), U26.13 (~OE), U32.13 (~OE), U33.13 (~OE), U34.13 (~OE), U40.13 (~OE), U41.13 (~OE), U42.13 (~OE), U48.13 (~OE), U49.13 (~OE), U50.13 (~OE), U57.13 (~OE), U58.13 (~OE), U59.13 (~OE), U67.13 (~OE), U68.13 (~OE), U69.13 (~OE), U75.13 (~OE), U76.13 (~OE), U77.13 (~OE); also elsewhere on the board
/MCU/CONFIG_UPDATE: U24.12 (RCLK), U25.12 (RCLK), U26.12 (RCLK), U32.12 (RCLK), U33.12 (RCLK), U34.12 (RCLK), U40.12 (RCLK), U41.12 (RCLK), U42.12 (RCLK), U48.12 (RCLK), U49.12 (RCLK), U50.12 (RCLK), U57.12 (RCLK), U58.12 (RCLK), U59.12 (RCLK), U67.12 (RCLK), U68.12 (RCLK), U69.12 (RCLK), U75.12 (RCLK), U76.12 (RCLK), U77.12 (RCLK); also elsewhere on the board
/Transceivers/PORT_2_DATA_1+: D36.1 (A1), R80.2, R83.1; also elsewhere on the board
/Transceivers/PORT_2_DATA_1-: D36.2 (A2), R79.2, R83.2; also elsewhere on the board
/Transceivers/PORT_2_DATA_2+: D37.1 (A1), R82.2, R84.1; also elsewhere on the board
/Transceivers/PORT_2_DATA_2-: D37.2 (A2), R81.2, R84.2; also elsewhere on the board
/Transceivers/PORT_2_LED_GRN: U24.7 (QH); also elsewhere on the board
/Transceivers/PORT_2_LED_YLW: U24.6 (QG); also elsewhere on the board
/Transceivers/PORT_3_DATA_1+: D38.1 (A1), R104.2, R107.1; also elsewhere on the board
/Transceivers/PORT_3_DATA_1-: D38.2 (A2), R103.2, R107.2; also elsewhere on the board
/Transceivers/PORT_3_DATA_2+: D39.1 (A1), R106.2, R108.1; also elsewhere on the board
/Transceivers/PORT_3_DATA_2-: D39.2 (A2), R105.2, R108.2; also elsewhere on the board
/Transceivers/PORT_3_LED_GRN: U32.7 (QH); also elsewhere on the board
/Transceivers/PORT_3_LED_YLW: U32.6 (QG); also elsewhere on the board
/Transceivers/PORT_4_DATA_1+: D40.1 (A1), R128.2, R131.1; also elsewhere on the board
/Transceivers/PORT_4_DATA_1-: D40.2 (A2), R127.2, R131.2; also elsewhere on the board
/Transceivers/PORT_4_DATA_2+: D41.1 (A1), R130.2, R132.1; also elsewhere on the board
/Transceivers/PORT_4_DATA_2-: D41.2 (A2), R129.2, R132.2; also elsewhere on the board
/Transceivers/PORT_4_LED_GRN: U40.7 (QH); also elsewhere on the board
/Transceivers/PORT_4_LED_YLW: U40.6 (QG); also elsewhere on the board
/Transceivers/PORT_5_DATA_1+: D42.1 (A1), R152.2, R155.1; also elsewhere on the board
/Transceivers/PORT_5_DATA_1-: D42.2 (A2), R151.2, R155.2; also elsewhere on the board
/Transceivers/PORT_5_DATA_2+: D43.1 (A1), R154.2, R156.1; also elsewhere on the board
/Transceivers/PORT_5_DATA_2-: D43.2 (A2), R153.2, R156.2; also elsewhere on the board
/Transceivers/PORT_5_LED_GRN: U48.7 (QH); also elsewhere on the board
/Transceivers/PORT_5_LED_YLW: U48.6 (QG); also elsewhere on the board
/Transceivers/PORT_6_DATA_1+: D44.1 (A1), R183.2, R186.1; also elsewhere on the board
/Transceivers/PORT_6_DATA_1-: D44.2 (A2), R182.2, R186.2; also elsewhere on the board
/Transceivers/PORT_6_DATA_2+: D45.1 (A1), R185.2, R188.1; also elsewhere on the board
/Transceivers/PORT_6_DATA_2-: D45.2 (A2), R184.2, R188.2; also elsewhere on the board
/Transceivers/PORT_6_LED_GRN: U57.7 (QH); also elsewhere on the board
/Transceivers/PORT_6_LED_YLW: U57.6 (QG); also elsewhere on the board
/Transceivers/PORT_7_DATA_1+: D46.1 (A1), R210.2, R214.1; also elsewhere on the board
/Transceivers/PORT_7_DATA_1-: D46.2 (A2), R209.2, R214.2; also elsewhere on the board
/Transceivers/PORT_7_DATA_2+: D47.1 (A1), R213.2, R215.1; also elsewhere on the board
/Transceivers/PORT_7_DATA_2-: D47.2 (A2), R212.2, R215.2; also elsewhere on the board
/Transceivers/PORT_7_LED_GRN: U67.7 (QH); also elsewhere on the board
/Transceivers/PORT_7_LED_YLW: U67.6 (QG); also elsewhere on the board
/Transceivers/PORT_8_DATA_1+: D48.1 (A1), R238.2, R241.1; also elsewhere on the board
/Transceivers/PORT_8_DATA_1-: D48.2 (A2), R237.2, R241.2; also elsewhere on the board
/Transceivers/PORT_8_DATA_2+: D49.1 (A1), R240.2, R242.1; also elsewhere on the board
/Transceivers/PORT_8_DATA_2-: D49.2 (A2), R239.2, R242.2; also elsewhere on the board
/Transceivers/PORT_8_LED_GRN: U75.7 (QH); also elsewhere on the board
/Transceivers/PORT_8_LED_YLW: U75.6 (QG); also elsewhere on the board
/Transceivers/Port Power/CONFIG_DATA_IN: U76.9 (QH'); also elsewhere on the board
/Transceivers/Transceiver pair1/1BIAS+: R74.1, U28.6
/Transceivers/Transceiver pair1/1BIAS-: R73.1, U28.3
/Transceivers/Transceiver pair1/2BIAS+: R76.1, U28.11
/Transceivers/Transceiver pair1/2BIAS-: R75.1, U28.8
/Transceivers/Transceiver pair1/CONFIG1: R65.1, U13.13, U26.15 (QA)
/Transceivers/Transceiver pair1/CONFIG2: R64.2, R66.1, U26.1 (QB)
/Transceivers/Transceiver pair1/CONFIG3: R61.2, R77.1, U26.2 (QC)
/Transceivers/Transceiver pair1/CONFIG4: R67.1, U13.4, U26.3 (QD)
/Transceivers/Transceiver pair1/CONFIG5: R68.1, U13.1, U26.4 (QE)
/Transceivers/Transceiver pair1/CONFIG6: R69.1, U26.5 (QF), U27.13
/Transceivers/Transceiver pair1/CONFIG7: R63.2, R70.1, U26.6 (QG)
/Transceivers/Transceiver pair1/CONFIG8: R62.2, R78.1, U26.7 (QH)
/Transceivers/Transceiver pair1/CONFIG9: R71.1, U24.15 (QA), U27.4
/Transceivers/Transceiver pair1/CONFIG10: R72.1, U24.1 (QB), U27.1
/Transceivers/Transceiver pair1/CONFIG_DATA_OUT: U25.9 (QH'), U34.14 (SER)
/Transceivers/Transceiver pair2/1BIAS+: R98.1, U36.6
/Transceivers/Transceiver pair2/1BIAS-: R97.1, U36.3
/Transceivers/Transceiver pair2/2BIAS+: R100.1, U36.11
/Transceivers/Transceiver pair2/2BIAS-: R99.1, U36.8
/Transceivers/Transceiver pair2/CONFIG1: R89.1, U31.13, U34.15 (QA)
/Transceivers/Transceiver pair2/CONFIG2: R88.2, R90.1, U34.1 (QB)
/Transceivers/Transceiver pair2/CONFIG3: R85.2, R101.1, U34.2 (QC)
/Transceivers/Transceiver pair2/CONFIG4: R91.1, U31.4, U34.3 (QD)
/Transceivers/Transceiver pair2/CONFIG5: R92.1, U31.1, U34.4 (QE)
/Transceivers/Transceiver pair2/CONFIG6: R93.1, U34.5 (QF), U35.13
/Transceivers/Transceiver pair2/CONFIG7: R87.2, R94.1, U34.6 (QG)
/Transceivers/Transceiver pair2/CONFIG8: R86.2, R102.1, U34.7 (QH)
/Transceivers/Transceiver pair2/CONFIG9: R95.1, U32.15 (QA), U35.4
/Transceivers/Transceiver pair2/CONFIG10: R96.1, U32.1 (QB), U35.1
/Transceivers/Transceiver pair2/CONFIG_DATA_OUT: U33.9 (QH'), U42.14 (SER)
/Transceivers/Transceiver pair3/1BIAS+: R122.1, U44.6
/Transceivers/Transceiver pair3/1BIAS-: R121.1, U44.3
/Transceivers/Transceiver pair3/2BIAS+: R124.1, U44.11
/Transceivers/Transceiver pair3/2BIAS-: R123.1, U44.8
/Transceivers/Transceiver pair3/CONFIG1: R113.1, U39.13, U42.15 (QA)
/Transceivers/Transceiver pair3/CONFIG2: R112.2, R114.1, U42.1 (QB)
/Transceivers/Transceiver pair3/CONFIG3: R109.2, R125.1, U42.2 (QC)
/Transceivers/Transceiver pair3/CONFIG4: R115.1, U39.4, U42.3 (QD)
/Transceivers/Transceiver pair3/CONFIG5: R116.1, U39.1, U42.4 (QE)
/Transceivers/Transceiver pair3/CONFIG6: R117.1, U42.5 (QF), U43.13
/Transceivers/Transceiver pair3/CONFIG7: R111.2, R118.1, U42.6 (QG)
/Transceivers/Transceiver pair3/CONFIG8: R110.2, R126.1, U42.7 (QH)
/Transceivers/Transceiver pair3/CONFIG9: R119.1, U40.15 (QA), U43.4
/Transceivers/Transceiver pair3/CONFIG10: R120.1, U40.1 (QB), U43.1
/Transceivers/Transceiver pair3/CONFIG_DATA_OUT: U41.9 (QH'), U50.14 (SER)
/Transceivers/Transceiver pair4/1BIAS+: R146.1, U53.6
/Transceivers/Transceiver pair4/1BIAS-: R145.1, U53.3
/Transceivers/Transceiver pair4/2BIAS+: R148.1, U53.11
/Transceivers/Transceiver pair4/2BIAS-: R147.1, U53.8
/Transceivers/Transceiver pair4/CONFIG1: R137.1, U47.13, U50.15 (QA)
/Transceivers/Transceiver pair4/CONFIG2: R136.2, R138.1, U50.1 (QB)
/Transceivers/Transceiver pair4/CONFIG3: R133.2, R149.1, U50.2 (QC)
/Transceivers/Transceiver pair4/CONFIG4: R139.1, U47.4, U50.3 (QD)
/Transceivers/Transceiver pair4/CONFIG5: R140.1, U47.1, U50.4 (QE)
/Transceivers/Transceiver pair4/CONFIG6: R141.1, U50.5 (QF), U52.13
/Transceivers/Transceiver pair4/CONFIG7: R135.2, R142.1, U50.6 (QG)
/Transceivers/Transceiver pair4/CONFIG8: R134.2, R150.1, U50.7 (QH)
/Transceivers/Transceiver pair4/CONFIG9: R143.1, U48.15 (QA), U52.4
/Transceivers/Transceiver pair4/CONFIG10: R144.1, U48.1 (QB), U52.1
/Transceivers/Transceiver pair4/CONFIG_DATA_OUT: U49.9 (QH'), U59.14 (SER)
/Transceivers/Transceiver pair5/1BIAS+: R176.1, U61.6
/Transceivers/Transceiver pair5/1BIAS-: R175.1, U61.3
/Transceivers/Transceiver pair5/2BIAS+: R178.1, U61.11
/Transceivers/Transceiver pair5/2BIAS-: R177.1, U61.8
/Transceivers/Transceiver pair5/CONFIG1: R166.1, U56.13, U59.15 (QA)
/Transceivers/Transceiver pair5/CONFIG2: R165.2, R167.1, U59.1 (QB)
/Transceivers/Transceiver pair5/CONFIG3: R157.2, R180.1, U59.2 (QC)
/Transceivers/Transceiver pair5/CONFIG4: R168.1, U56.4, U59.3 (QD)
/Transceivers/Transceiver pair5/CONFIG5: R169.1, U56.1, U59.4 (QE)
/Transceivers/Transceiver pair5/CONFIG6: R170.1, U59.5 (QF), U60.13
/Transceivers/Transceiver pair5/CONFIG7: R164.2, R172.1, U59.6 (QG)
/Transceivers/Transceiver pair5/CONFIG8: R158.2, R181.1, U59.7 (QH)
/Transceivers/Transceiver pair5/CONFIG9: R173.1, U57.15 (QA), U60.4
/Transceivers/Transceiver pair5/CONFIG10: R174.1, U57.1 (QB), U60.1
/Transceivers/Transceiver pair5/CONFIG_DATA_OUT: U58.9 (QH'), U69.14 (SER)
/Transceivers/Transceiver pair6/1BIAS+: R204.1, U71.6
/Transceivers/Transceiver pair6/1BIAS-: R202.1, U71.3
/Transceivers/Transceiver pair6/2BIAS+: R206.1, U71.11
/Transceivers/Transceiver pair6/2BIAS-: R205.1, U71.8
/Transceivers/Transceiver pair6/CONFIG1: R193.1, U64.13, U69.15 (QA)
/Transceivers/Transceiver pair6/CONFIG2: R192.2, R194.1, U69.1 (QB)
/Transceivers/Transceiver pair6/CONFIG3: R189.2, R207.1, U69.2 (QC)
/Transceivers/Transceiver pair6/CONFIG4: R196.1, U64.4, U69.3 (QD)
/Transceivers/Transceiver pair6/CONFIG5: R197.1, U64.1, U69.4 (QE)
/Transceivers/Transceiver pair6/CONFIG6: R198.1, U69.5 (QF), U70.13
/Transceivers/Transceiver pair6/CONFIG7: R191.2, R199.1, U69.6 (QG)
/Transceivers/Transceiver pair6/CONFIG8: R190.2, R208.1, U69.7 (QH)
/Transceivers/Transceiver pair6/CONFIG9: R200.1, U67.15 (QA), U70.4
/Transceivers/Transceiver pair6/CONFIG10: R201.1, U67.1 (QB), U70.1
/Transceivers/Transceiver pair6/CONFIG_DATA_OUT: U68.9 (QH'), U77.14 (SER)
/Transceivers/Transceiver pair7/1BIAS+: R231.1, U79.6
/Transceivers/Transceiver pair7/1BIAS-: R230.1, U79.3
/Transceivers/Transceiver pair7/2BIAS+: R233.1, U79.11
/Transceivers/Transceiver pair7/2BIAS-: R232.1, U79.8
/Transceivers/Transceiver pair7/CONFIG1: R221.1, U74.13, U77.15 (QA)
/Transceivers/Transceiver pair7/CONFIG2: R220.2, R222.1, U77.1 (QB)
/Transceivers/Transceiver pair7/CONFIG3: R216.2, R234.1, U77.2 (QC)
/Transceivers/Transceiver pair7/CONFIG4: R223.1, U74.4, U77.3 (QD)
/Transceivers/Transceiver pair7/CONFIG5: R224.1, U74.1, U77.4 (QE)
/Transceivers/Transceiver pair7/CONFIG6: R225.1, U77.5 (QF), U78.13
/Transceivers/Transceiver pair7/CONFIG7: R218.2, R226.1, U77.6 (QG)
/Transceivers/Transceiver pair7/CONFIG8: R217.2, R236.1, U77.7 (QH)
/Transceivers/Transceiver pair7/CONFIG9: R228.1, U75.15 (QA), U78.4
/Transceivers/Transceiver pair7/CONFIG10: R229.1, U75.1 (QB), U78.1
/Transceivers/Transceiver pair/CONFIG_DATA_OUT: U26.14 (SER); also elsewhere on the board
GND: C68.2, C69.2, C70.2, C71.2, C72.2, C73.2, C74.2, C75.2, C76.1, C77.2, C78.2, C79.2, C80.2, C81.2, C82.2, C83.2, C84.2, C85.1, C86.2, C87.2, C88.2, C89.2, C90.2, C91.2, C92.2, C93.2, C94.1, C95.2, C97.2, C98.2, C99.2, C100.2, C101.2, C102.2, C103.2, C104.1, C105.2, C106.2, C107.2, C108.2, C109.2, C117.2, C118.2, C119.2, C120.1, C121.2, C122.2, C123.2, C124.2, C125.2, C126.2, C127.2, C128.2, C129.1, C130.2, C131.2, C141.2, C142.2, C143.2, C144.2, C145.2, C146.2, C147.1, D36.3 (common), D37.3 (common), D38.3 (common), D39.3 (common), D40.3 (common), D41.3 (common), D42.3 (common), D43.3 (common), D44.3 (common), D45.3 (common), D46.3 (common), D47.3 (common), D48.3 (common), D49.3 (common), R77.2, R78.2, R101.2, R102.2, R125.2, R126.2, R149.2, R150.2, R180.2, R181.2, R207.2, R208.2, R234.2, R236.2, U13.7 (GND), U24.8 (GND), U25.8 (GND), U26.8 (GND), U27.7 (GND), U28.7 (GND), U29.2 (~RE), U29.5 (GND), U30.2 (~RE), U30.5 (GND), U31.7 (GND), U32.8 (GND), U33.8 (GND), U34.8 (GND), U35.7 (GND), U36.7 (GND), U37.2 (~RE), U37.5 (GND), U38.2 (~RE), U38.5 (GND), U39.7 (GND), U40.8 (GND), U41.8 (GND), U42.8 (GND), U43.7 (GND), U44.7 (GND), U45.2 (~RE), U45.5 (GND), U46.2 (~RE), U46.5 (GND), U47.7 (GND), U48.8 (GND), U49.8 (GND), U50.8 (GND), U52.7 (GND), U53.7 (GND), U54.2 (~RE), U54.5 (GND), U55.2 (~RE), U55.5 (GND), U56.7 (GND), U57.8 (GND), U58.8 (GND), U59.8 (GND), U60.7 (GND), U61.7 (GND), U62.2 (~RE), U62.5 (GND), U63.2 (~RE), U63.5 (GND), U64.7 (GND), U67.8 (GND), U68.8 (GND), U69.8 (GND), U70.7 (GND), U71.7 (GND), U72.2 (~RE), U72.5 (GND), U73.2 (~RE), U73.5 (GND), U74.7 (GND), U75.8 (GND), U76.8 (GND), U77.8 (GND), U78.7 (GND), U79.7 (GND), U80.2 (~RE), U80.5 (GND), U81.2 (~RE), U81.5 (GND); also elsewhere on the board
unnamed: R63.1, U27.10, U27.11
unnamed: R64.1, U13.10, U13.11
unnamed: R87.1, U35.10, U35.11
unnamed: R88.1, U31.10, U31.11
unnamed: R111.1, U43.10, U43.11
unnamed: R112.1, U39.10, U39.11
unnamed: R135.1, U52.10, U52.11
unnamed: R136.1, U47.10, U47.11
unnamed: R164.1, U60.10, U60.11
unnamed: R165.1, U56.10, U56.11
unnamed: R191.1, U70.10, U70.11
unnamed: R192.1, U64.10, U64.11
unnamed: R218.1, U78.10, U78.11
unnamed: R220.1, U74.10, U74.11
unnamed: U24.9 (QH'), U25.14 (SER)
unnamed: U24.14 (SER), U26.9 (QH')
unnamed: U25.15 (QA), U28.2
unnamed: U25.1 (QB), U28.1
unnamed: U25.2 (QC), U28.5
unnamed: U25.3 (QD), U28.4
unnamed: U25.4 (QE), U28.9
unnamed: U25.5 (QF), U28.10
unnamed: U25.6 (QG), U28.12
unnamed: U25.7 (QH), U28.13
unnamed: R74.2, R80.1, U29.6 (A)
unnamed: R73.2, R79.1, U29.7 (B)
unnamed: R61.1, U13.6, U29.3 (DE)
unnamed: U13.9, U27.2, U29.1 (RO)
unnamed: R76.2, R82.1, U30.6 (A)
unnamed: R75.2, R81.1, U30.7 (B)
unnamed: R62.1, U27.6, U30.3 (DE)
unnamed: U13.2, U27.9, U30.1 (RO)
unnamed: U32.9 (QH'), U33.14 (SER)
unnamed: U32.14 (SER), U34.9 (QH')
unnamed: U33.15 (QA), U36.2
unnamed: U33.1 (QB), U36.1
unnamed: U33.2 (QC), U36.5
unnamed: U33.3 (QD), U36.4
unnamed: U33.4 (QE), U36.9
unnamed: U33.5 (QF), U36.10
unnamed: U33.6 (QG), U36.12
unnamed: U33.7 (QH), U36.13
unnamed: R98.2, R104.1, U37.6 (A)
unnamed: R97.2, R103.1, U37.7 (B)
unnamed: R85.1, U31.6, U37.3 (DE)
unnamed: U31.9, U35.2, U37.1 (RO)
unnamed: R100.2, R106.1, U38.6 (A)
unnamed: R99.2, R105.1, U38.7 (B)
unnamed: R86.1, U35.6, U38.3 (DE)
unnamed: U31.2, U35.9, U38.1 (RO)
unnamed: U40.9 (QH'), U41.14 (SER)
unnamed: U40.14 (SER), U42.9 (QH')
unnamed: U41.15 (QA), U44.2
unnamed: U41.1 (QB), U44.1
unnamed: U41.2 (QC), U44.5
unnamed: U41.3 (QD), U44.4
unnamed: U41.4 (QE), U44.9
unnamed: U41.5 (QF), U44.10
unnamed: U41.6 (QG), U44.12
unnamed: U41.7 (QH), U44.13
unnamed: R122.2, R128.1, U45.6 (A)
unnamed: R121.2, R127.1, U45.7 (B)
unnamed: R109.1, U39.6, U45.3 (DE)
unnamed: U39.9, U43.2, U45.1 (RO)
unnamed: R124.2, R130.1, U46.6 (A)
unnamed: R123.2, R129.1, U46.7 (B)
unnamed: R110.1, U43.6, U46.3 (DE)
unnamed: U39.2, U43.9, U46.1 (RO)
unnamed: U48.9 (QH'), U49.14 (SER)
unnamed: U48.14 (SER), U50.9 (QH')
unnamed: U49.15 (QA), U53.2
unnamed: U49.1 (QB), U53.1
unnamed: U49.2 (QC), U53.5
unnamed: U49.3 (QD), U53.4
unnamed: U49.4 (QE), U53.9
unnamed: U49.5 (QF), U53.10
unnamed: U49.6 (QG), U53.12
unnamed: U49.7 (QH), U53.13
unnamed: R146.2, R152.1, U54.6 (A)
unnamed: R145.2, R151.1, U54.7 (B)
unnamed: R133.1, U47.6, U54.3 (DE)
unnamed: U47.9, U52.2, U54.1 (RO)
unnamed: R148.2, R154.1, U55.6 (A)
unnamed: R147.2, R153.1, U55.7 (B)
unnamed: R134.1, U52.6, U55.3 (DE)
unnamed: U47.2, U52.9, U55.1 (RO)
unnamed: U57.9 (QH'), U58.14 (SER)
unnamed: U57.14 (SER), U59.9 (QH')
unnamed: U58.15 (QA), U61.2
unnamed: U58.1 (QB), U61.1
unnamed: U58.2 (QC), U61.5
unnamed: U58.3 (QD), U61.4
unnamed: U58.4 (QE), U61.9
unnamed: U58.5 (QF), U61.10
unnamed: U58.6 (QG), U61.12
unnamed: U58.7 (QH), U61.13
unnamed: R176.2, R183.1, U62.6 (A)
unnamed: R175.2, R182.1, U62.7 (B)
unnamed: R157.1, U56.6, U62.3 (DE)
unnamed: U56.9, U60.2, U62.1 (RO)
unnamed: R178.2, R185.1, U63.6 (A)
unnamed: R177.2, R184.1, U63.7 (B)
unnamed: R158.1, U60.6, U63.3 (DE)
unnamed: U56.2, U60.9, U63.1 (RO)
unnamed: U67.9 (QH'), U68.14 (SER)
unnamed: U67.14 (SER), U69.9 (QH')
unnamed: U68.15 (QA), U71.2
unnamed: U68.1 (QB), U71.1
unnamed: U68.2 (QC), U71.5
unnamed: U68.3 (QD), U71.4
unnamed: U68.4 (QE), U71.9
unnamed: U68.5 (QF), U71.10
unnamed: U68.6 (QG), U71.12
unnamed: U68.7 (QH), U71.13
unnamed: R204.2, R210.1, U72.6 (A)
unnamed: R202.2, R209.1, U72.7 (B)
unnamed: R189.1, U64.6, U72.3 (DE)
unnamed: U64.9, U70.2, U72.1 (RO)
unnamed: R206.2, R213.1, U73.6 (A)
unnamed: R205.2, R212.1, U73.7 (B)
unnamed: R190.1, U70.6, U73.3 (DE)
unnamed: U64.2, U70.9, U73.1 (RO)
unnamed: U75.9 (QH'), U76.14 (SER)
unnamed: U75.14 (SER), U77.9 (QH')
unnamed: U76.15 (QA), U79.2
unnamed: U76.1 (QB), U79.1
unnamed: U76.2 (QC), U79.5
unnamed: U76.3 (QD), U79.4
unnamed: U76.4 (QE), U79.9
unnamed: U76.5 (QF), U79.10
unnamed: U76.6 (QG), U79.12
unnamed: U76.7 (QH), U79.13
unnamed: R231.2, R238.1, U80.6 (A)
unnamed: R230.2, R237.1, U80.7 (B)
unnamed: R216.1, U74.6, U80.3 (DE)
unnamed: U74.9, U78.2, U80.1 (RO)
unnamed: R233.2, R240.1, U81.6 (A)
unnamed: R232.2, R239.1, U81.7 (B)
unnamed: R217.1, U78.6, U81.3 (DE)
unnamed: U74.2, U78.9, U81.1 (RO)

Notes on the sheet:
12 Mbps: THVD1420D 50 Mbps: THVD1450D
TODO: figure out sharing FPGA pins between ports for EnDAT encoders
