ExcessiveOverkill/controller-hardware-dev/KiCad/Serial Module/Serial Module.kicad_pcb

## KiCad design KiCad/Serial Module/Serial Module.kicad_pcb (continued)

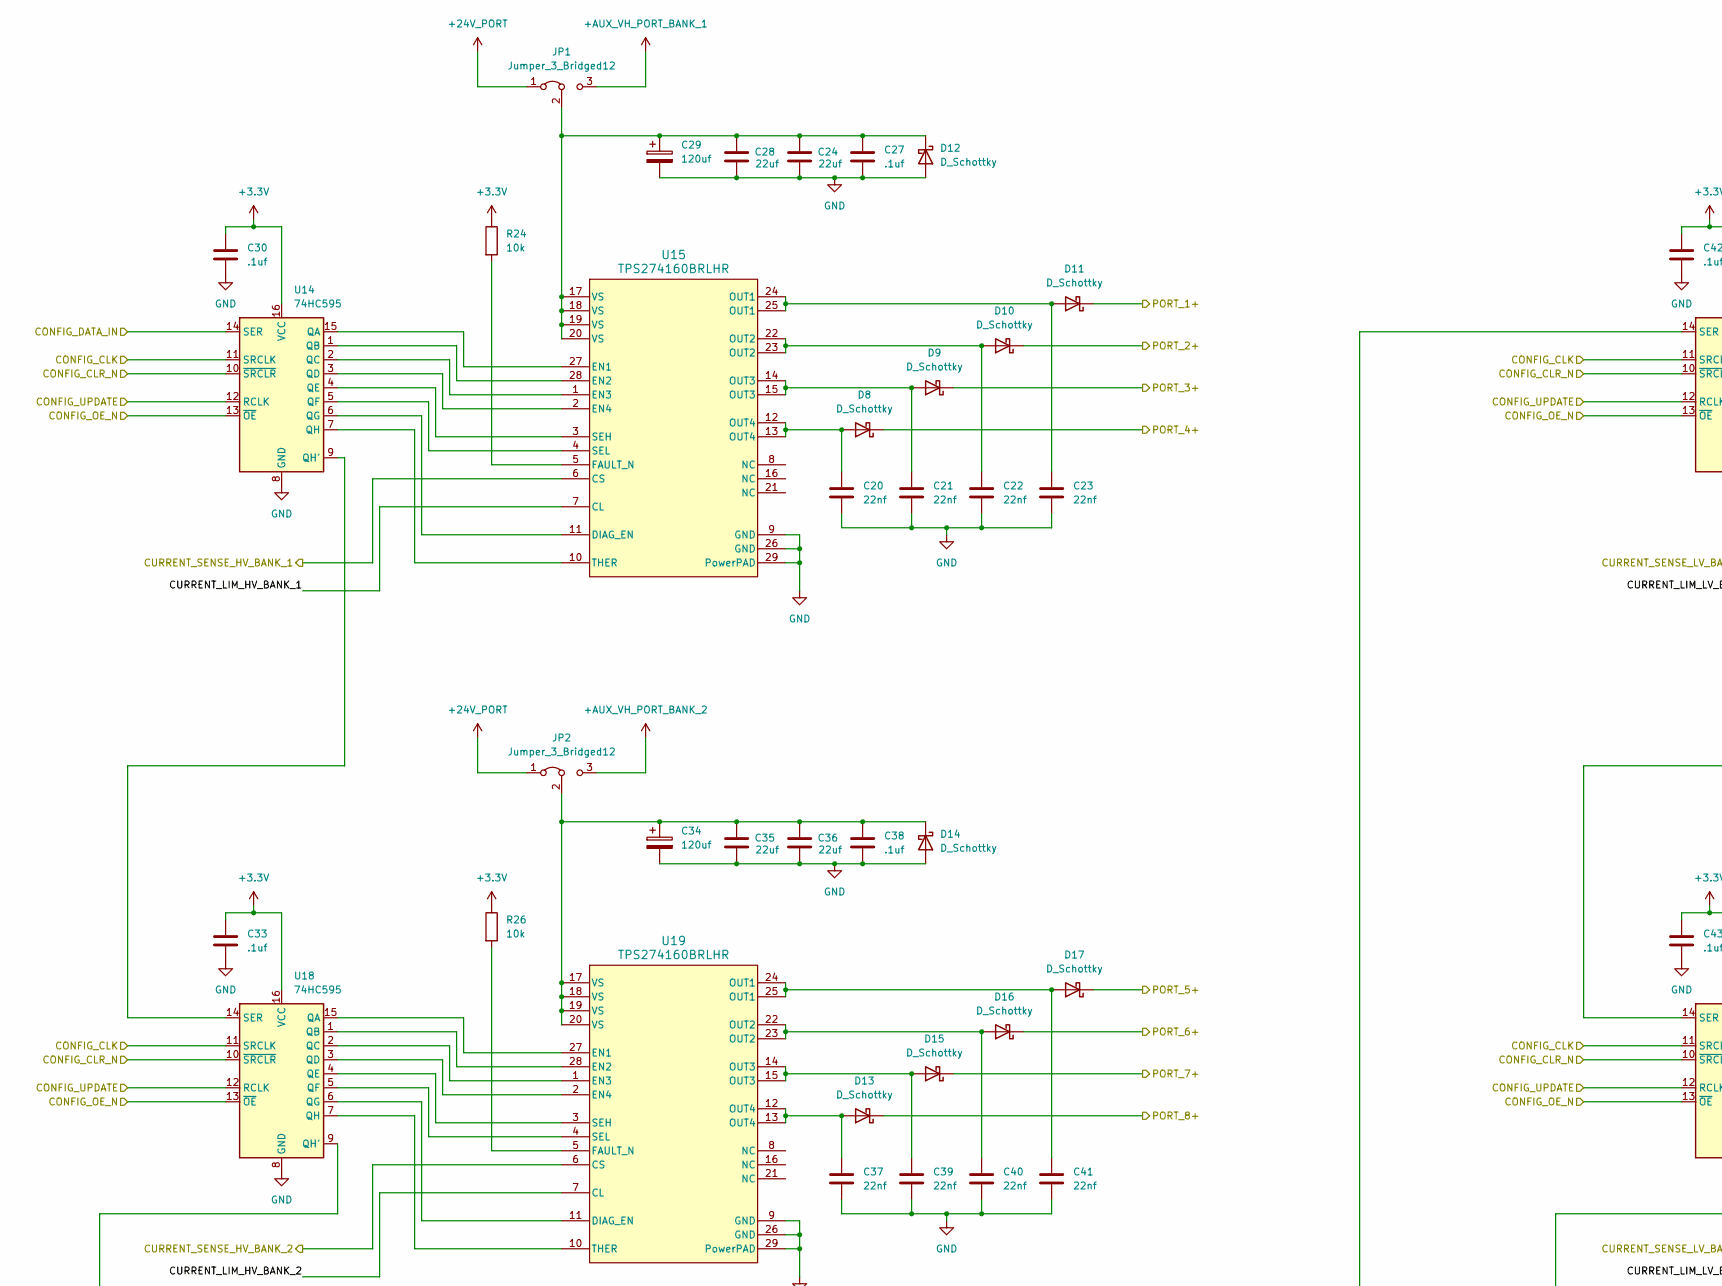
[picture p11: schematic port_power.kicad_sch, part in row 1, column 1]

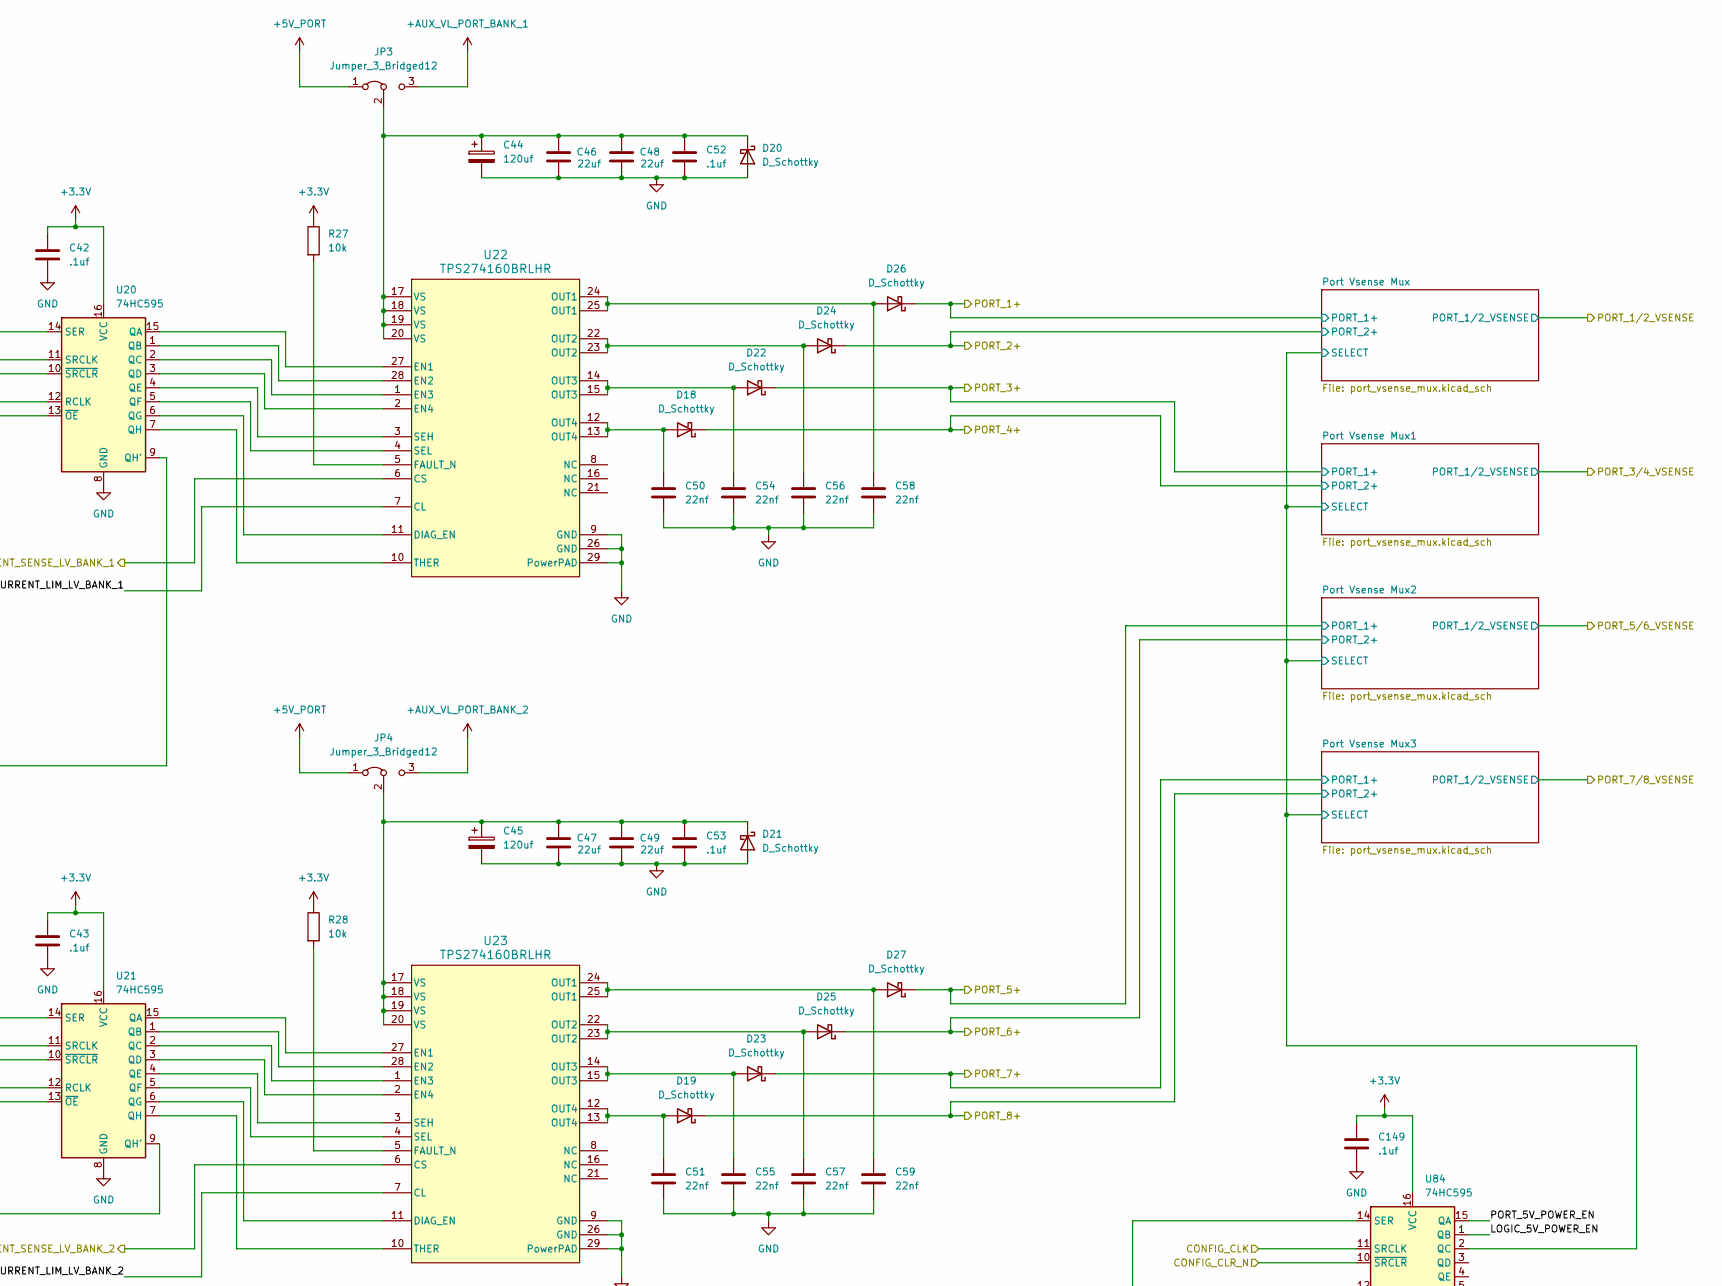
[picture p12: schematic port_power.kicad_sch, part in row 1, column 2]

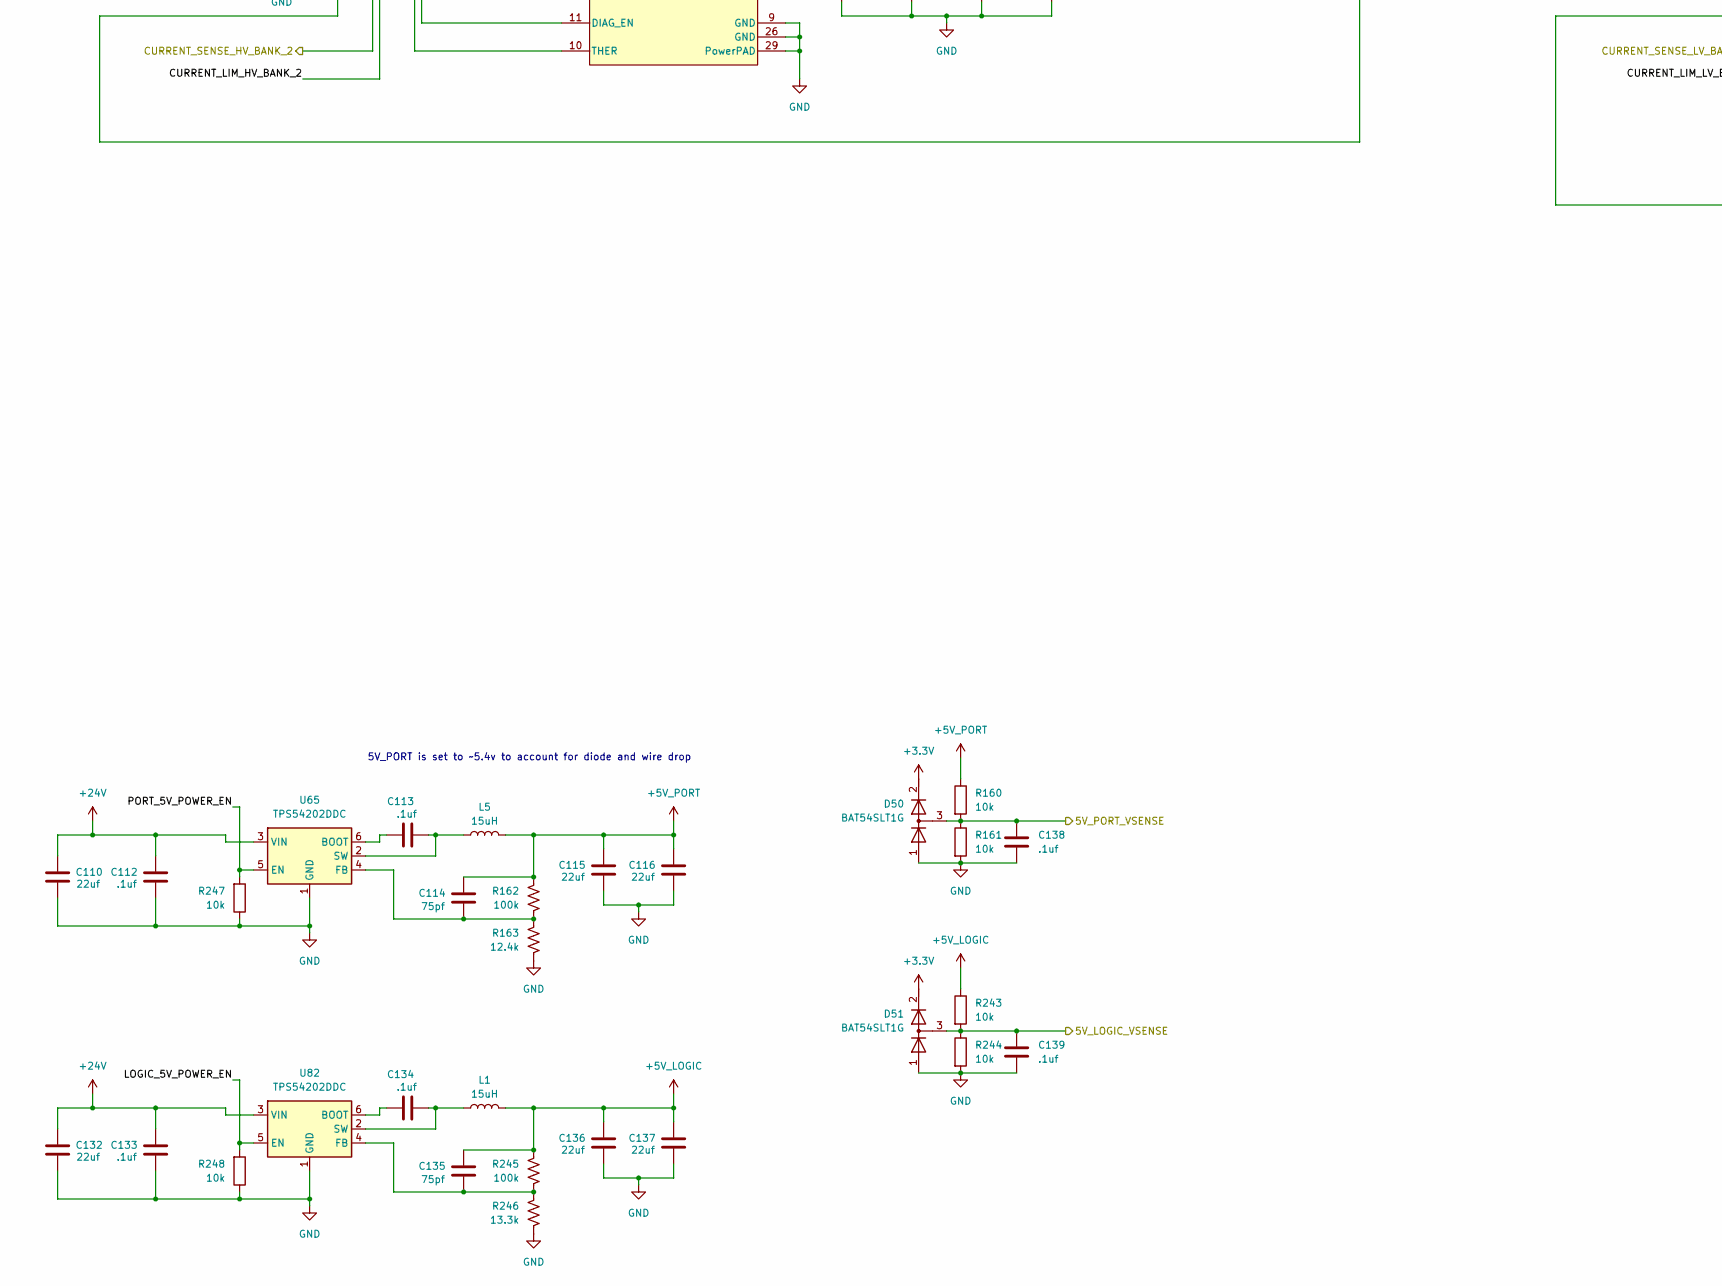
[picture p13: schematic port_power.kicad_sch, part in row 2, column 1]

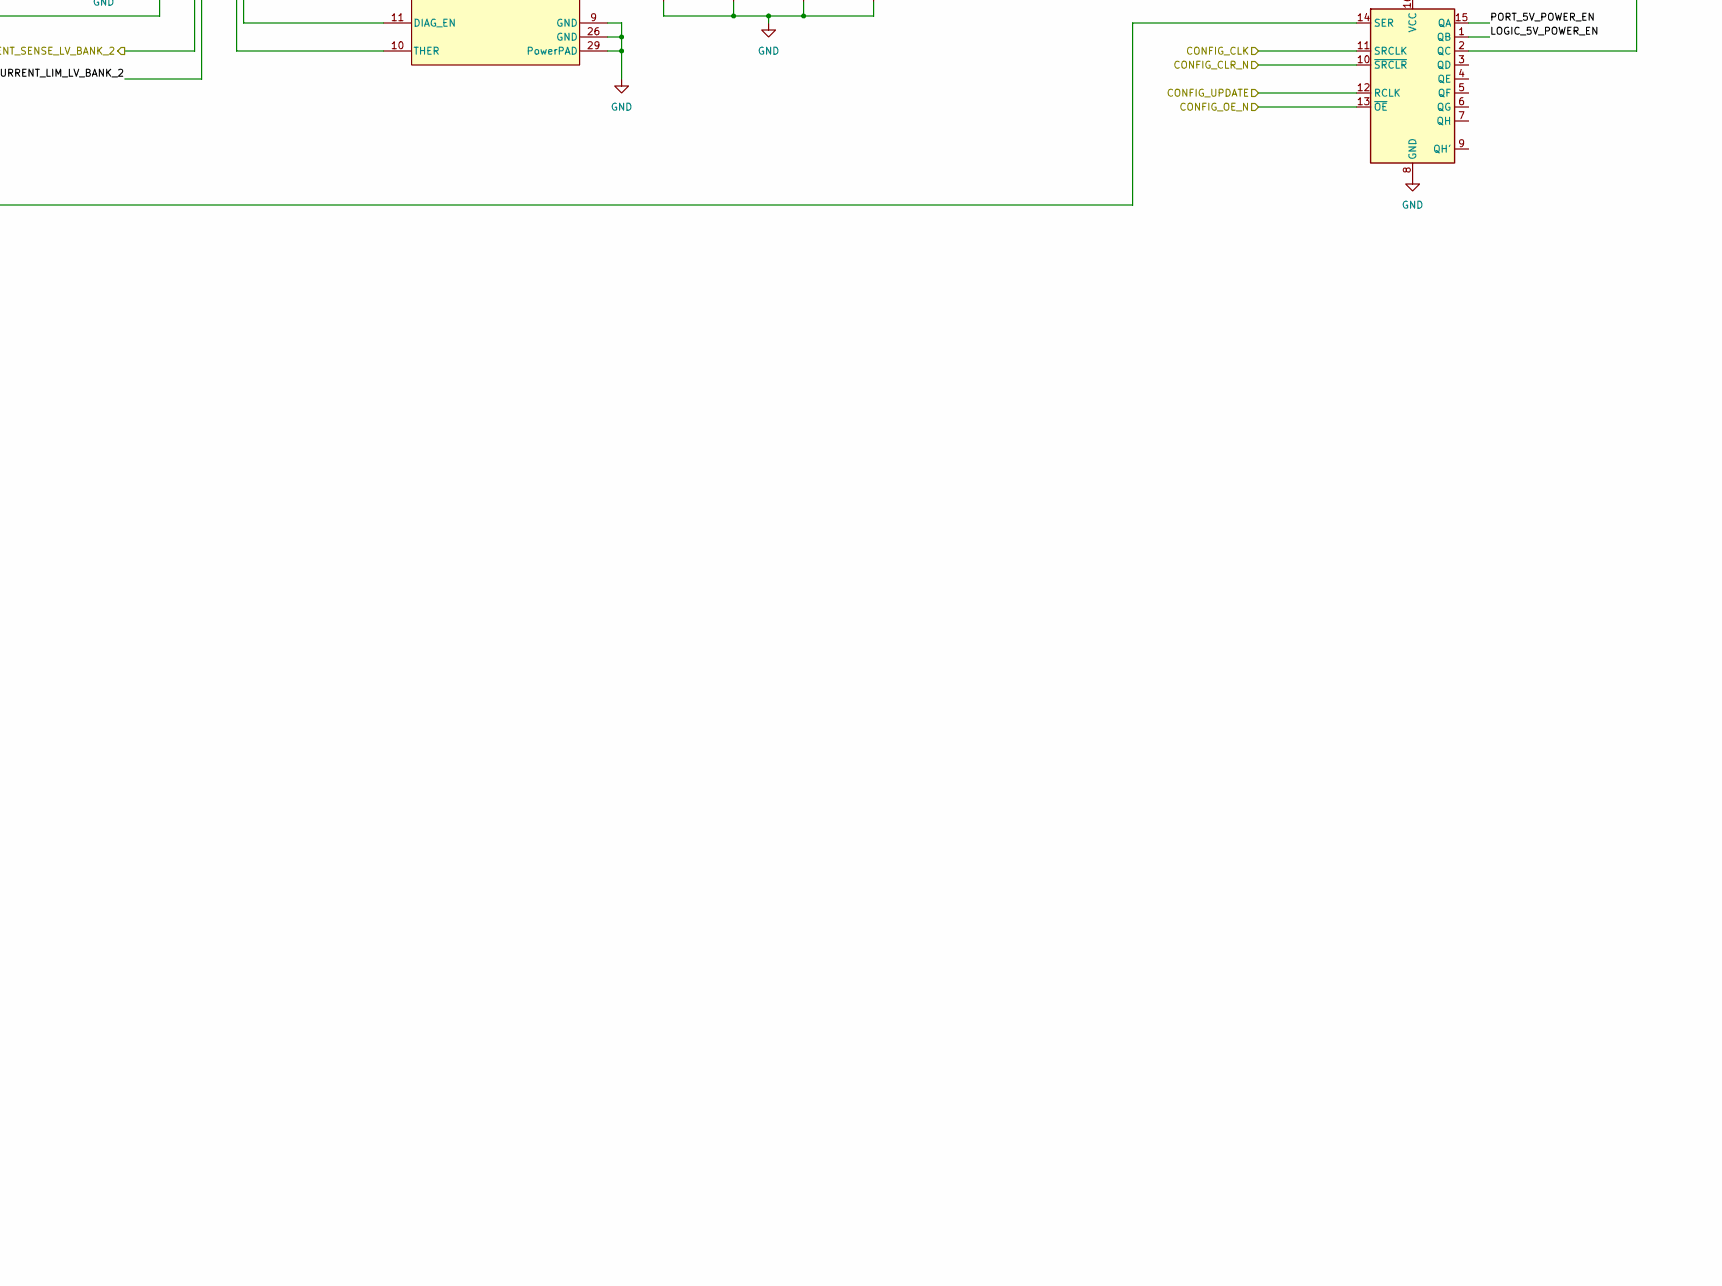
[picture p14: schematic port_power.kicad_sch, part in row 2, column 2]

Parts:
C20, C21, C22, C23, C37, C39, C40, C41, C50, C51, C54, C55, C56, C57, C58, C59: 22nf; C_0603_1608Metric
C24, C28, C35, C36, C46, C47, C48, C49, C110, C115, C116, C132, C136, C137: 22uf; C_1206_3216Metric; Part number CL31A226KAHNNNE; LCSC# C12891
C27, C30, C33, C38, C42, C43, C52, C53, C138, C139, C149: .1uf; C_0603_1608Metric
C29, C34, C44, C45: 120uf; CP_Elec_8x10.5
C112, C113, C133, C134: .1uf; C_0402_1005Metric; Part number CC0402KRX5R9BB104; LCSC# C105882
C114, C135: 75pf; C_0402_1005Metric; Part number CC0402JRNPO9BN750; LCSC# C107010
D8, D9, D10, D11, D12, D13, D14, D15, D16, D17, D18, D19, D20, D21, D22, D23, D24, D25, D26, D27: D_Schottky; D_SOD-123F; Part Number K24; LCSC# C908664
D50, D51: BAT54SLT1G; SOT-23; Part number LBAT54SLT1G; LCSC# C12765
JP1, JP2, JP3, JP4: Jumper_3_Bridged12; PinHeader_1x03_P2.54mm_Vertical
L1, L5: 15uH; FCH0650; Part number CY54-15UH; LCSC# C20415538
R24, R26, R27, R28, R160, R161, R243, R244, R247, R248: 10k; R_0603_1608Metric
R162, R245: 100k; R_0402_1005Metric; Part number RC0402FR-07100KL; LCSC# C60491
R163: 12.4k; R_0402_1005Metric; Part number RC0402FR-0713K3L; LCSC# C274352
R246: 13.3k; R_0402_1005Metric; Part number RC0402FR-0713K3L; LCSC# C274352
U14, U18, U20, U21, U84: 74HC595; TSSOP-16_4.4x5mm_P0.65mm; LCSC# C5948
U15, U19, U22, U23: TPS274160BRLHR; WQFN-28-1EP_4x4mm_P0.4mm_EP2.7x2.7mm_ThermalVias; LCSC# C2797257
U65, U82: TPS54202DDC; SOT-23-6; Part number TPS54202DDCR; LCSC# C191884

Connections:
+3.3V: C30.1, C33.1, C42.1, C43.1, C149.1, D50.2 (K), D51.2 (K), R24.1, R26.1, R27.1, R28.1, U14.16 (VCC), U18.16 (VCC), U20.16 (VCC), U21.16 (VCC), U84.16 (VCC); also elsewhere on the board
+5V_LOGIC: C135.2, C136.2, C137.2, L1.2, R243.1, R245.2; also elsewhere on the board
+5V_PORT: C114.2, C115.2, C116.2, JP3.1 (A), JP4.1 (A), L5.2, R160.1, R162.2
+24V: C110.2, C112.2, C132.2, C133.2, U65.3 (VIN), U82.3 (VIN); also elsewhere on the board
+24V_PORT: JP1.1 (A), JP2.1 (A)
+AUX_VH_PORT_BANK_1: JP1.3 (B)
+AUX_VH_PORT_BANK_2: JP2.3 (B)
+AUX_VL_PORT_BANK_1: JP3.3 (B)
+AUX_VL_PORT_BANK_2: JP4.3 (B)
/MCU/5V_LOGIC_SENSE: C139.1, D51.3 (common), R243.2, R244.1; also elsewhere on the board
/MCU/5V_PORT_SENSE: C138.1, D50.3 (common), R160.2, R161.1; also elsewhere on the board
/MCU/CONFIG_CLK: U14.11 (SRCLK), U18.11 (SRCLK), U20.11 (SRCLK), U21.11 (SRCLK), U84.11 (SRCLK); also elsewhere on the board
/MCU/CONFIG_CLR_N: U14.10 (~SRCLR), U18.10 (~SRCLR), U20.10 (~SRCLR), U21.10 (~SRCLR), U84.10 (~SRCLR); also elsewhere on the board
/MCU/CONFIG_OE_N: U14.13 (~OE), U18.13 (~OE), U20.13 (~OE), U21.13 (~OE), U84.13 (~OE); also elsewhere on the board
/MCU/CONFIG_UPDATE: U14.12 (RCLK), U18.12 (RCLK), U20.12 (RCLK), U21.12 (RCLK), U84.12 (RCLK); also elsewhere on the board
/MCU/HV_BANK_1_CURRENT_SENSE: U15.6 (CS); also elsewhere on the board
/MCU/HV_BANK_2_CURRENT_SENSE: U19.6 (CS); also elsewhere on the board
/MCU/LV_BANK_1_CURRENT_SENSE: U22.6 (CS); also elsewhere on the board
/MCU/LV_BANK_2_CURRENT_SENSE: U23.6 (CS); also elsewhere on the board
/Transceivers/PORT_1+: D11.1 (K), D26.1 (K); also elsewhere on the board
/Transceivers/PORT_2+: D10.1 (K), D24.1 (K); also elsewhere on the board
/Transceivers/PORT_3+: D9.1 (K), D22.1 (K); also elsewhere on the board
/Transceivers/PORT_4+: D8.1 (K), D18.1 (K); also elsewhere on the board
/Transceivers/PORT_5+: D17.1 (K), D27.1 (K); also elsewhere on the board
/Transceivers/PORT_6+: D16.1 (K), D25.1 (K); also elsewhere on the board
/Transceivers/PORT_7+: D15.1 (K), D23.1 (K); also elsewhere on the board
/Transceivers/PORT_8+: D13.1 (K), D19.1 (K); also elsewhere on the board
/Transceivers/Port Power/CONFIG_DATA_IN: U14.14 (SER); also elsewhere on the board
/Transceivers/Port Power/CURRENT_LIM_HV_BANK_1: U15.7 (CL)
/Transceivers/Port Power/CURRENT_LIM_HV_BANK_2: U19.7 (CL)
/Transceivers/Port Power/CURRENT_LIM_LV_BANK_1: U22.7 (CL)
/Transceivers/Port Power/CURRENT_LIM_LV_BANK_2: U23.7 (CL)
/Transceivers/Port Power/LOGIC_5V_POWER_EN: R248.2, U82.5 (EN), U84.1 (QB)
/Transceivers/Port Power/PORT_5V_POWER_EN: R247.2, U65.5 (EN), U84.15 (QA)
/Transceivers/Port Power/Port Vsense Mux/SELECT: U84.2 (QC); also elsewhere on the board
GND: C20.2, C21.2, C22.2, C23.2, C24.1, C27.2, C28.1, C29.2, C30.2, C33.2, C34.2, C35.1, C36.1, C37.2, C38.2, C39.2, C40.2, C41.2, C42.2, C43.2, C44.2, C45.2, C46.1, C47.1, C48.1, C49.1, C50.2, C51.2, C52.2, C53.2, C54.2, C55.2, C56.2, C57.2, C58.2, C59.2, C110.1, C112.1, C115.1, C116.1, C132.1, C133.1, C136.1, C137.1, C138.2, C139.2, C149.2, D12.2 (A), D14.2 (A), D20.2 (A), D21.2 (A), D50.1 (A), D51.1 (A), R161.2, R163.1, R244.2, R246.1, R247.1, R248.1, U14.8 (GND), U15.9 (GND), U15.26 (GND), U15.29 (PowerPAD), U18.8 (GND), U19.9 (GND), U19.26 (GND), U19.29 (PowerPAD), U20.8 (GND), U21.8 (GND), U22.9 (GND), U22.26 (GND), U22.29 (PowerPAD), U23.9 (GND), U23.26 (GND), U23.29 (PowerPAD), U65.1 (GND), U82.1 (GND), U84.8 (GND); also elsewhere on the board
unnamed: C20.1, D8.2 (A), U15.12 (OUT4), U15.13 (OUT4)
unnamed: C21.1, D9.2 (A), U15.14 (OUT3), U15.15 (OUT3)
unnamed: C22.1, D10.2 (A), U15.22 (OUT2), U15.23 (OUT2)
unnamed: C23.1, D11.2 (A), U15.24 (OUT1), U15.25 (OUT1)
unnamed: C24.2, C27.1, C28.2, C29.1, D12.1 (K), JP1.2 (C), U15.17 (VS), U15.18 (VS), U15.19 (VS), U15.20 (VS)
unnamed: C37.1, D13.2 (A), U19.12 (OUT4), U19.13 (OUT4)
unnamed: C34.1, C35.2, C36.2, C38.1, D14.1 (K), JP2.2 (C), U19.17 (VS), U19.18 (VS), U19.19 (VS), U19.20 (VS)
unnamed: C39.1, D15.2 (A), U19.14 (OUT3), U19.15 (OUT3)
unnamed: C40.1, D16.2 (A), U19.22 (OUT2), U19.23 (OUT2)
unnamed: C41.1, D17.2 (A), U19.24 (OUT1), U19.25 (OUT1)
unnamed: C50.1, D18.2 (A), U22.12 (OUT4), U22.13 (OUT4)
unnamed: C51.1, D19.2 (A), U23.12 (OUT4), U23.13 (OUT4)
unnamed: C44.1, C46.2, C48.2, C52.1, D20.1 (K), JP3.2 (C), U22.17 (VS), U22.18 (VS), U22.19 (VS), U22.20 (VS)
unnamed: C45.1, C47.2, C49.2, C53.1, D21.1 (K), JP4.2 (C), U23.17 (VS), U23.18 (VS), U23.19 (VS), U23.20 (VS)
unnamed: C54.1, D22.2 (A), U22.14 (OUT3), U22.15 (OUT3)
unnamed: C55.1, D23.2 (A), U23.14 (OUT3), U23.15 (OUT3)
unnamed: C56.1, D24.2 (A), U22.22 (OUT2), U22.23 (OUT2)
unnamed: C57.1, D25.2 (A), U23.22 (OUT2), U23.23 (OUT2)
unnamed: C58.1, D26.2 (A), U22.24 (OUT1), U22.25 (OUT1)
unnamed: C59.1, D27.2 (A), U23.24 (OUT1), U23.25 (OUT1)
unnamed: U14.15 (QA), U15.27 (EN1)
unnamed: U14.1 (QB), U15.28 (EN2)
unnamed: U14.2 (QC), U15.1 (EN3)
unnamed: U14.3 (QD), U15.2 (EN4)
unnamed: U14.4 (QE), U15.3 (SEH)
unnamed: U14.5 (QF), U15.4 (SEL)
unnamed: U14.6 (QG), U15.11 (DIAG_EN)
unnamed: U14.9 (QH'), U18.14 (SER)
unnamed: U14.7 (QH), U15.10 (THER)
unnamed: R24.2, U15.5 (FAULT_N)
unnamed: U18.15 (QA), U19.27 (EN1)
unnamed: U18.1 (QB), U19.28 (EN2)
unnamed: U18.2 (QC), U19.1 (EN3)
unnamed: U18.3 (QD), U19.2 (EN4)
unnamed: U18.4 (QE), U19.3 (SEH)
unnamed: U18.5 (QF), U19.4 (SEL)
unnamed: U18.6 (QG), U19.11 (DIAG_EN)
unnamed: U18.9 (QH'), U20.14 (SER)
unnamed: U18.7 (QH), U19.10 (THER)
unnamed: R26.2, U19.5 (FAULT_N)
unnamed: U20.15 (QA), U22.27 (EN1)
unnamed: U20.1 (QB), U22.28 (EN2)
unnamed: U20.2 (QC), U22.1 (EN3)
unnamed: U20.3 (QD), U22.2 (EN4)
unnamed: U20.4 (QE), U22.3 (SEH)
unnamed: U20.5 (QF), U22.4 (SEL)
unnamed: U20.6 (QG), U22.11 (DIAG_EN)
unnamed: U20.9 (QH'), U21.14 (SER)
unnamed: U20.7 (QH), U22.10 (THER)
unnamed: U21.15 (QA), U23.27 (EN1)
unnamed: U21.1 (QB), U23.28 (EN2)
unnamed: U21.2 (QC), U23.1 (EN3)
unnamed: U21.3 (QD), U23.2 (EN4)
unnamed: U21.4 (QE), U23.3 (SEH)
unnamed: U21.5 (QF), U23.4 (SEL)
unnamed: U21.6 (QG), U23.11 (DIAG_EN)
unnamed: U21.9 (QH'), U84.14 (SER)
unnamed: U21.7 (QH), U23.10 (THER)
unnamed: R27.2, U22.5 (FAULT_N)
unnamed: R28.2, U23.5 (FAULT_N)
unnamed: C113.1, U65.6 (BOOT)
unnamed: C114.1, R162.1, R163.2, U65.4 (FB)
unnamed: C113.2, L5.1, U65.2 (SW)
unnamed: C134.1, U82.6 (BOOT)
unnamed: C135.1, R245.1, R246.2, U82.4 (FB)
unnamed: C134.2, L1.1, U82.2 (SW)

Notes on the sheet:
5V_PORT is set to ~5.4v to account for diode and wire drop

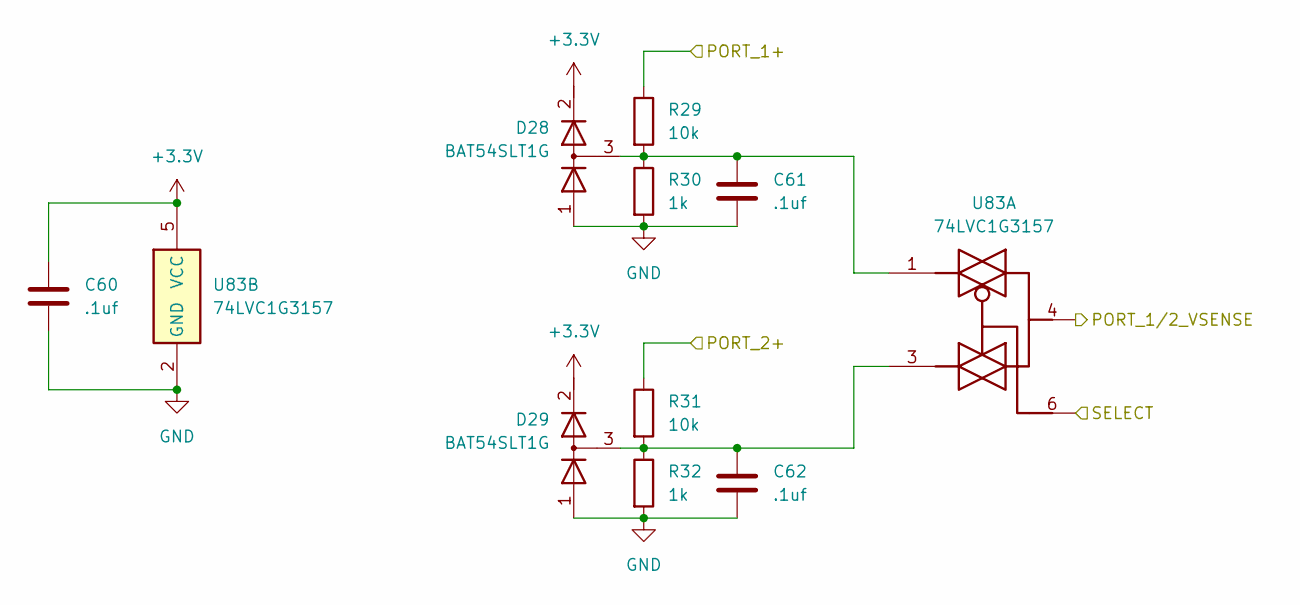
[picture p15: schematic port_vsense_mux.kicad_sch]

Parts:
C60, C61, C62: .1uf; C_0603_1608Metric
D28, D29: BAT54SLT1G; SOT-23; Part number LBAT54SLT1G; LCSC# C12765
R29, R31: 10k; R_0603_1608Metric
R30, R32: 1k; R_0603_1608Metric
U83: 74LVC1G3157; SOT-23-6

Connections:
+3.3V: C60.1, D28.2 (K), D29.2 (K), U83.5 (VCC); also elsewhere on the board
/MCU/PORT_1/2_VSENSE: U83.4; also elsewhere on the board
/Transceivers/PORT_1+: R29.1; also elsewhere on the board
/Transceivers/PORT_2+: R31.1; also elsewhere on the board
/Transceivers/Port Power/Port Vsense Mux/SELECT: U83.6; also elsewhere on the board
GND: C60.2, C61.2, C62.2, D28.1 (A), D29.1 (A), R30.2, R32.2, U83.2 (GND); also elsewhere on the board
unnamed: C61.1, D28.3 (common), R29.2, R30.1, U83.1
unnamed: C62.1, D29.3 (common), R31.2, R32.1, U83.3

Parts of its further copies:
C63, C64, C65, C66, C67, C148, C150, C151, C152: .1uf; C_0603_1608Metric
D30, D31, D32, D33, D34, D35: BAT54SLT1G; SOT-23; Part number LBAT54SLT1G; LCSC# C12765
R33, R35, R37, R39, R41, R43: 10k; R_0603_1608Metric
R34, R36, R38, R40, R42, R44: 1k; R_0603_1608Metric
U85, U86, U87: 74LVC1G3157; SOT-23-6

Connections of its further copies:
+3.3V: C63.1, C66.1, C150.1, D30.2 (K), D31.2 (K), D32.2 (K), D33.2 (K), D34.2 (K), D35.2 (K), U85.5 (VCC), U86.5 (VCC), U87.5 (VCC); also elsewhere on the board
/MCU/PORT_3/4_VSENSE: U85.4; also elsewhere on the board
/MCU/PORT_5/6_VSENSE: U86.4; also elsewhere on the board
/MCU/PORT_7/8_VSENSE: U87.4; also elsewhere on the board
/Transceivers/PORT_3+: R33.1; also elsewhere on the board
/Transceivers/PORT_4+: R35.1; also elsewhere on the board
/Transceivers/PORT_5+: R37.1; also elsewhere on the board
/Transceivers/PORT_6+: R39.1; also elsewhere on the board
/Transceivers/PORT_7+: R41.1; also elsewhere on the board
/Transceivers/PORT_8+: R43.1; also elsewhere on the board
/Transceivers/Port Power/Port Vsense Mux/SELECT: U85.6, U86.6, U87.6; also elsewhere on the board
GND: C63.2, C64.2, C65.2, C66.2, C67.2, C148.2, C150.2, C151.2, C152.2, D30.1 (A), D31.1 (A), D32.1 (A), D33.1 (A), D34.1 (A), D35.1 (A), R34.2, R36.2, R38.2, R40.2, R42.2, R44.2, U85.2 (GND), U86.2 (GND), U87.2 (GND); also elsewhere on the board
unnamed: C64.1, D30.3 (common), R33.2, R34.1, U85.1
unnamed: C65.1, D31.3 (common), R35.2, R36.1, U85.3
unnamed: C67.1, D32.3 (common), R37.2, R38.1, U86.1
unnamed: C148.1, D33.3 (common), R39.2, R40.1, U86.3
unnamed: C151.1, D34.3 (common), R41.2, R42.1, U87.1
unnamed: C152.1, D35.3 (common), R43.2, R44.1, U87.3

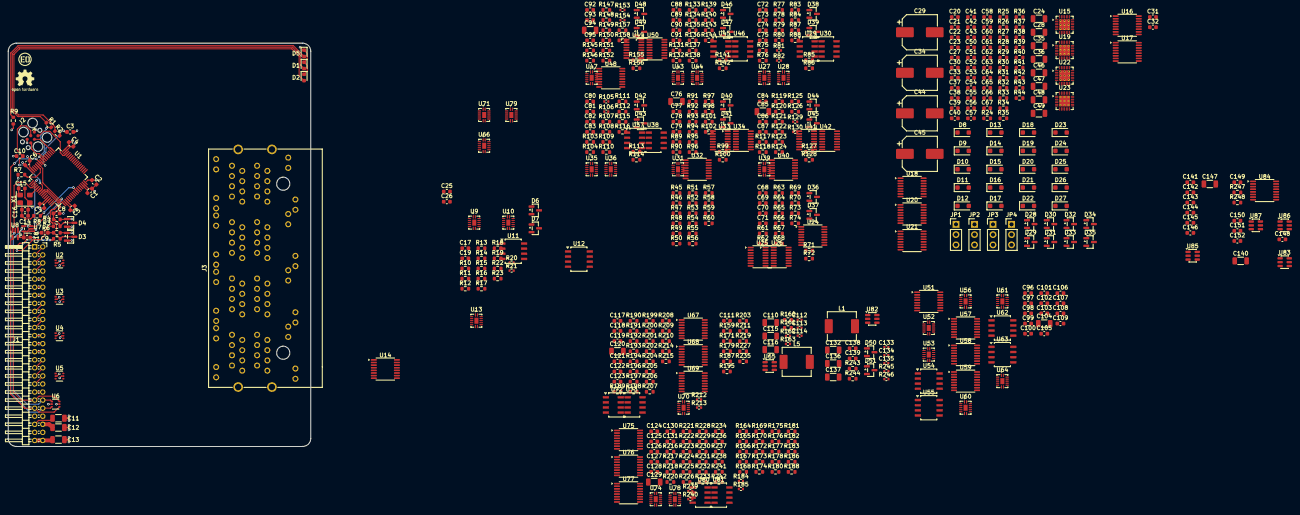
[picture p16: board Serial Module.kicad_pcb from above]

Board: 4 copper layers, 75.0 x 100.0 mm, 548 parts (0 on the bottom side), 489 nets.
