ExcessiveOverkill/controller-hardware-dev/KiCad/Main Mezzanine Backplane/Main Mezzanine Backplane.kicad_pcb

## KiCad design KiCad/Main Mezzanine Backplane/Main Mezzanine Backplane.kicad_pcb (2026-10-19)

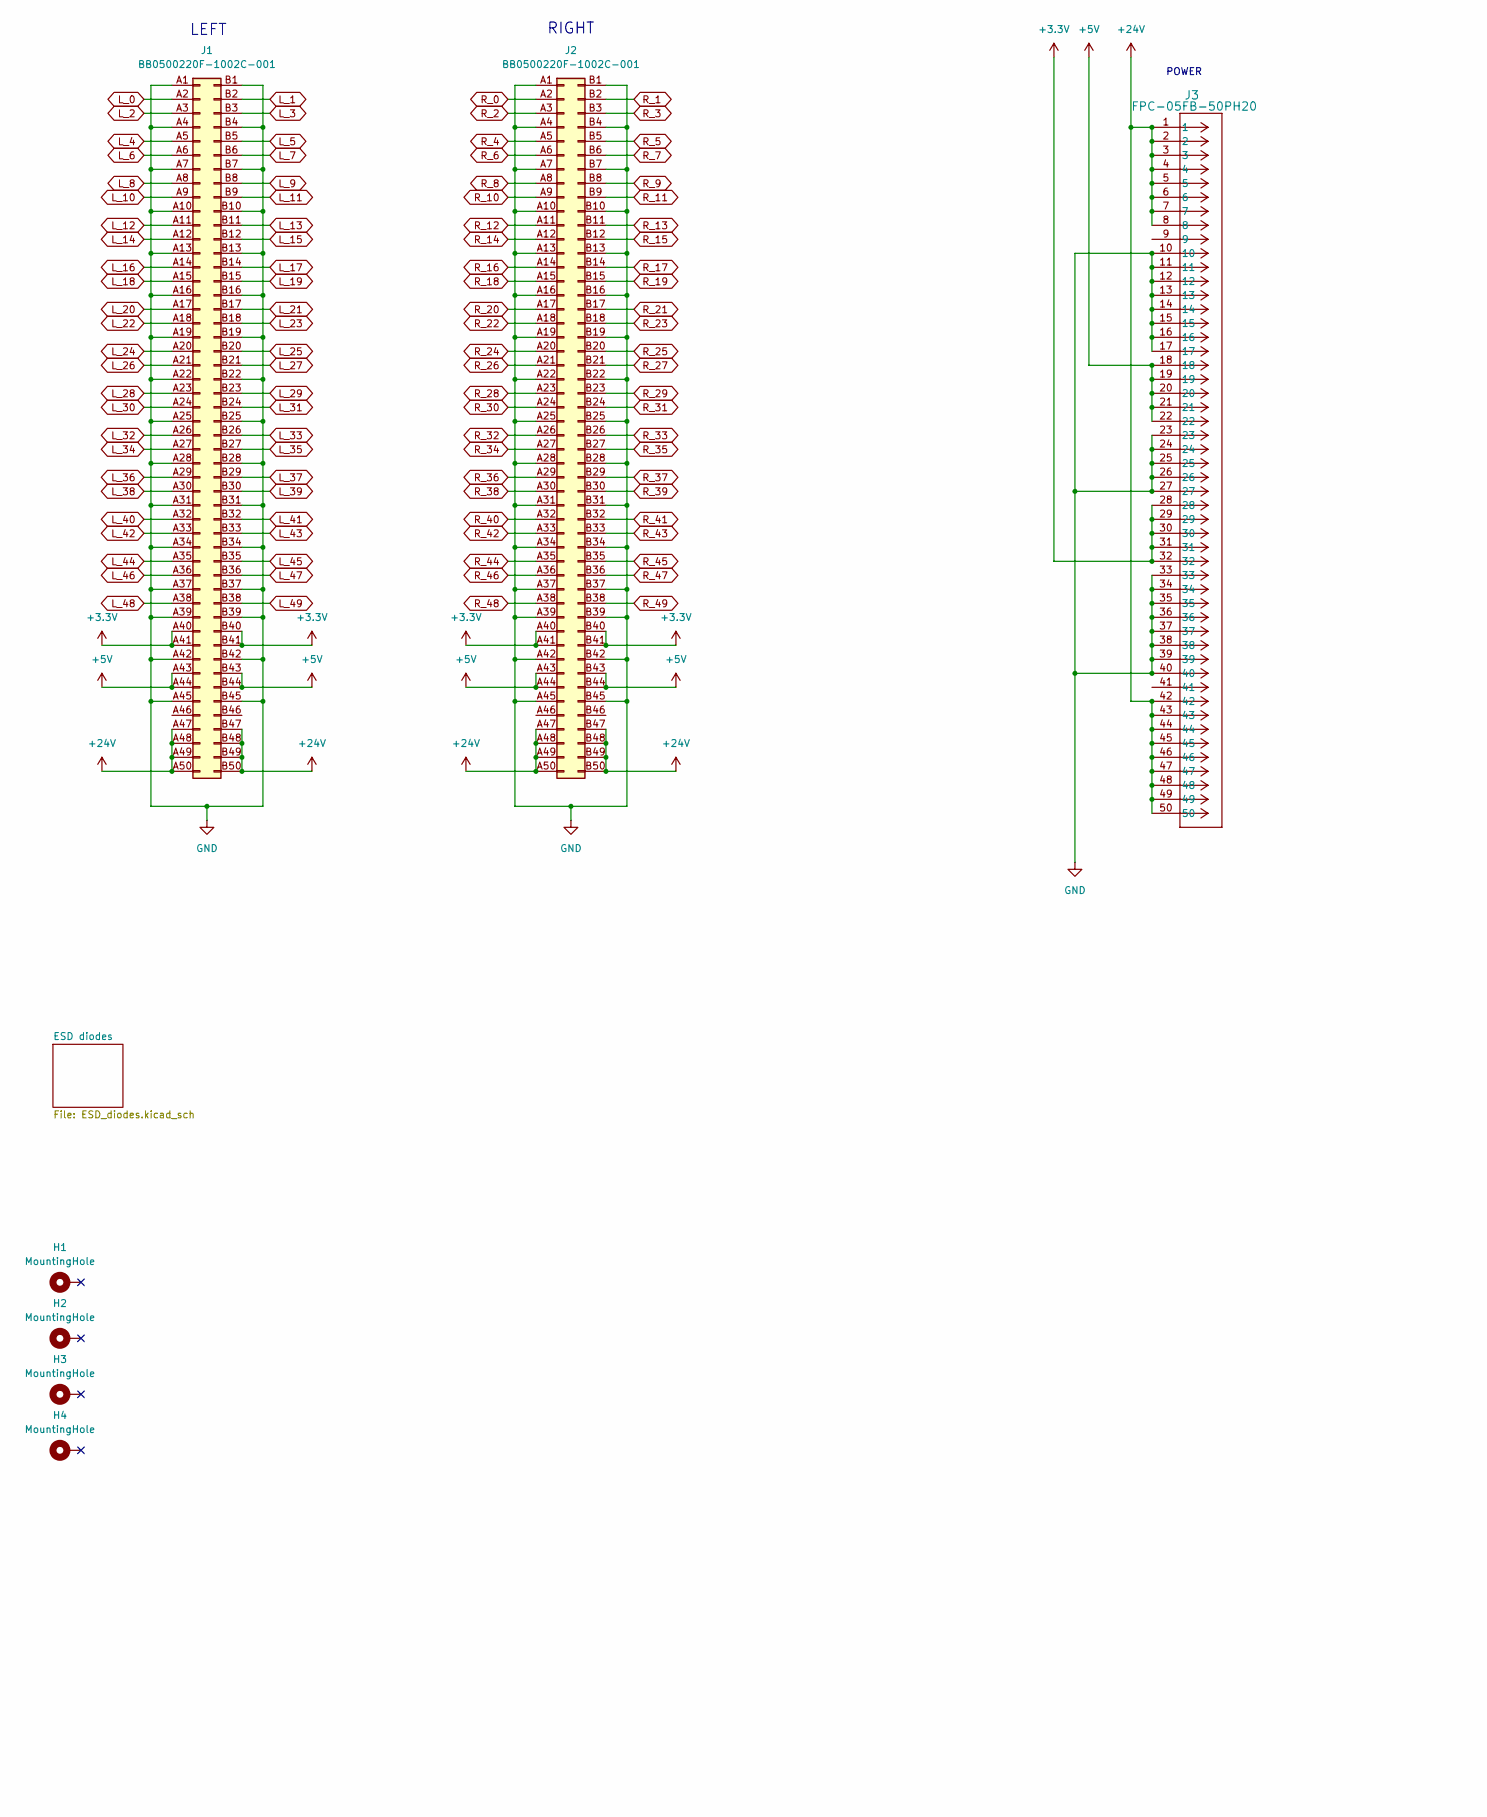
[picture p17: schematic Main Mezzanine Backplane.kicad_sch, part in row 1, column 1]

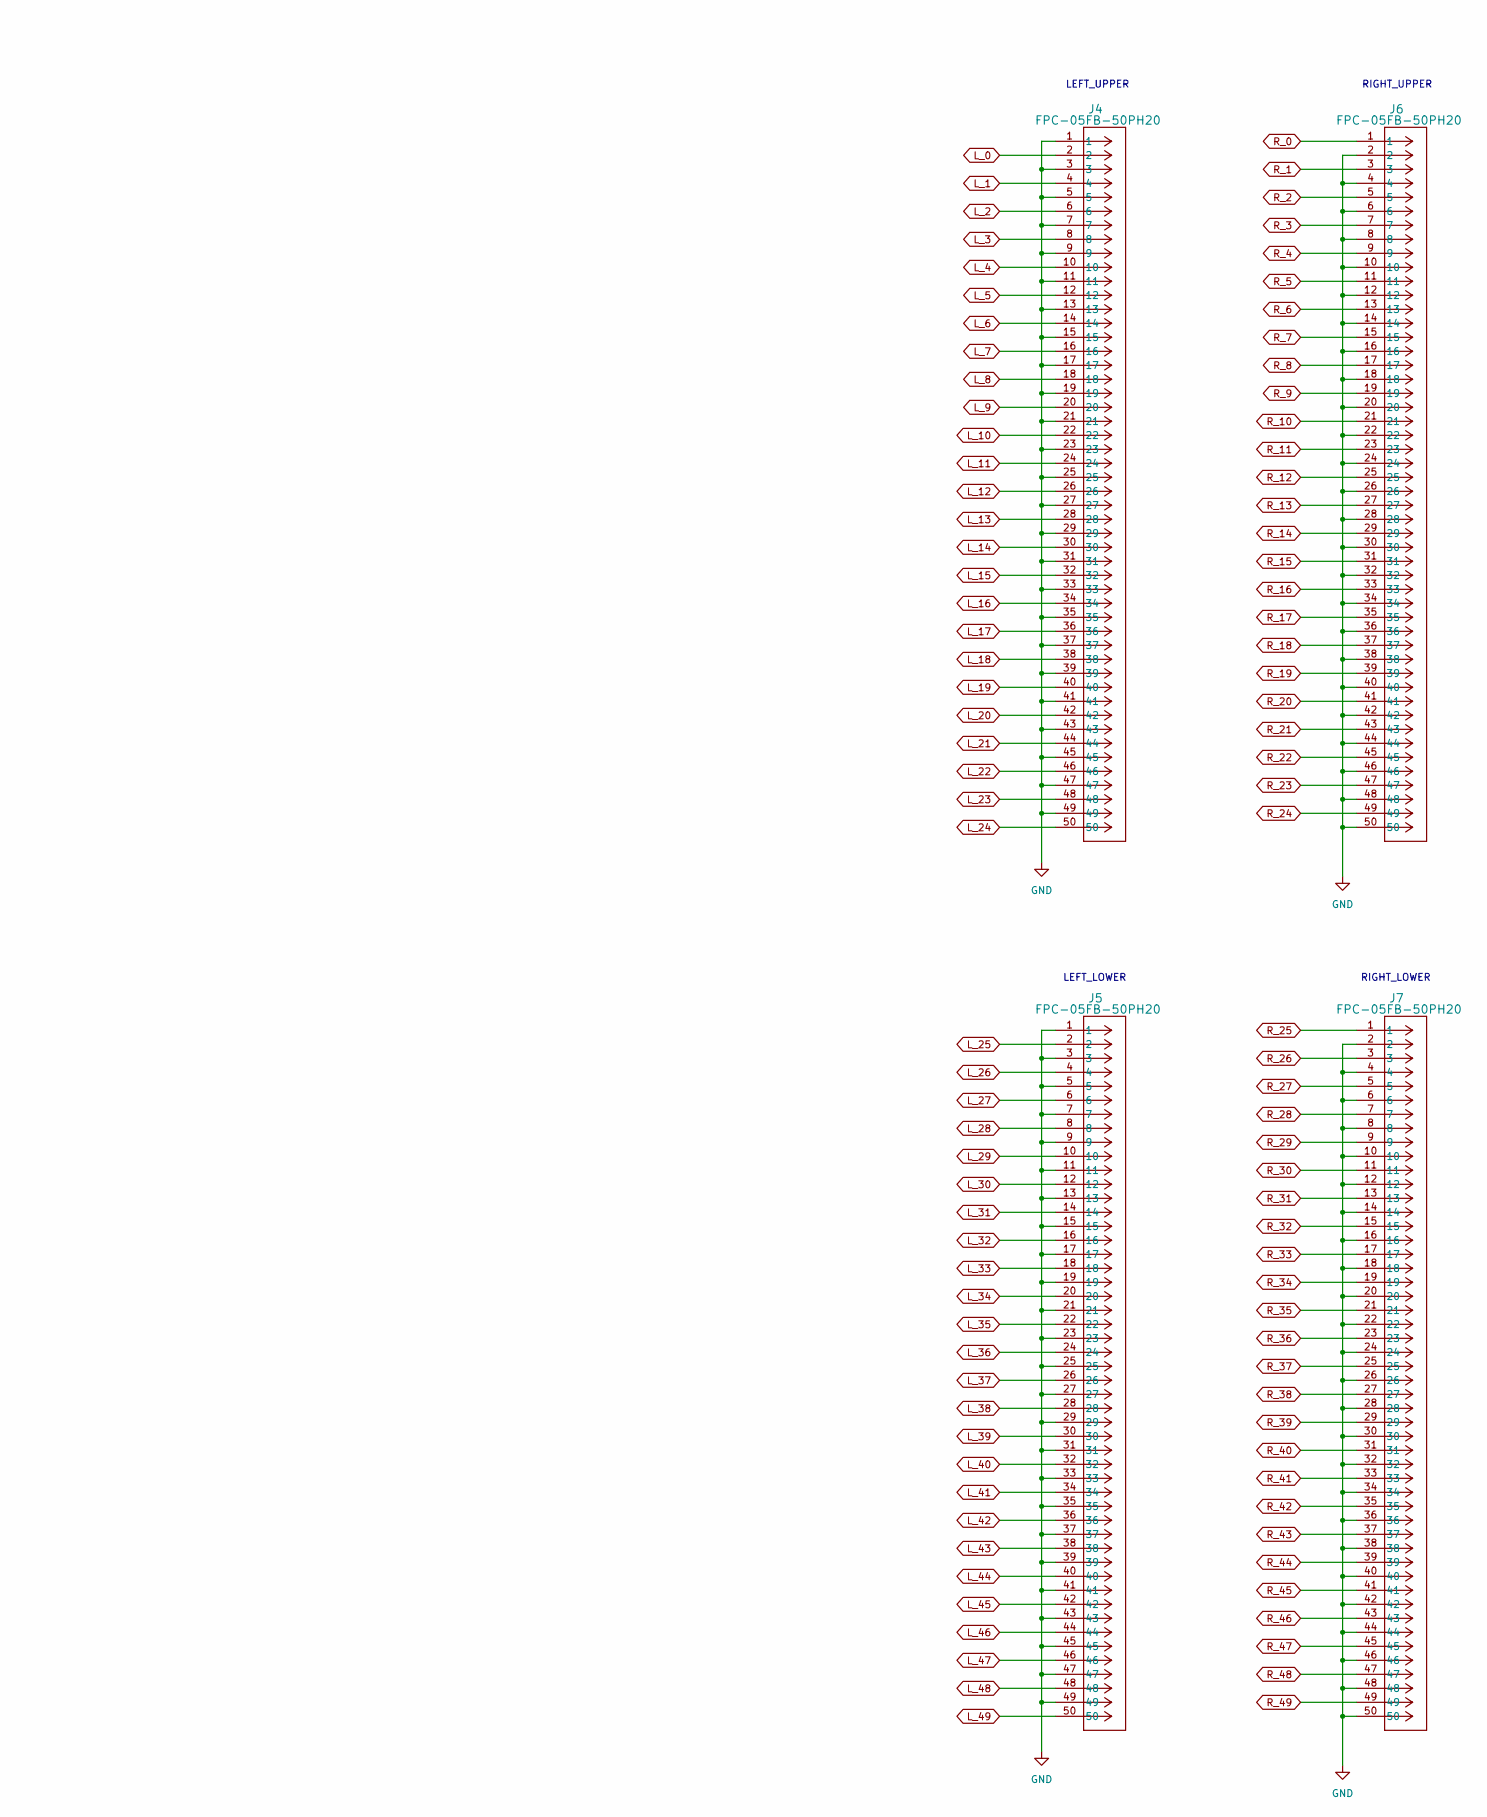
[picture p18: schematic Main Mezzanine Backplane.kicad_sch, part in row 1, column 2]

Parts:
H1, H2, H3, H4: MountingHole; MountingHole_3.2mm_M3_Pad_TopBottom
J1, J2: BB0500220F-1002C-001; Part Number BB0500220F-1002C-001; LCSC# C42421167
J3, J4, J5, J6, J7: FPC-05FB-50PH20; CONN50_FPC-05FB-50PH20_XNP

Connections:
+24V: J1.A47, J1.A48, J1.A49, J1.A50, J1.B47, J1.B48, J1.B49, J1.B50, J2.A47, J2.A48, J2.A49, J2.A50, J2.B47, J2.B48, J2.B49, J2.B50, J3.1, J3.2, J3.3, J3.4, J3.5, J3.6, J3.7, J3.8, J3.9, J3.42, J3.43, J3.44, J3.45, J3.46, J3.47, J3.48, J3.49, J3.50
L_0: J1.A2, J4.2; also elsewhere on the board
L_1: J1.B2, J4.4; also elsewhere on the board
L_2: J1.A3, J4.6; also elsewhere on the board
L_3: J1.B3, J4.8; also elsewhere on the board
L_4: J1.A5, J4.10; also elsewhere on the board
L_5: J1.B5, J4.12; also elsewhere on the board
L_6: J1.A6, J4.14; also elsewhere on the board
L_7: J1.B6, J4.16; also elsewhere on the board
L_8: J1.A8, J4.18; also elsewhere on the board
L_9: J1.B8, J4.20; also elsewhere on the board
L_10: J1.A9, J4.22; also elsewhere on the board
L_11: J1.B9, J4.24; also elsewhere on the board
L_12: J1.A11, J4.26; also elsewhere on the board
L_13: J1.B11, J4.28; also elsewhere on the board
L_14: J1.A12, J4.30; also elsewhere on the board
L_15: J1.B12, J4.32; also elsewhere on the board
L_16: J1.A14, J4.34; also elsewhere on the board
L_17: J1.B14, J4.36; also elsewhere on the board
L_18: J1.A15, J4.38; also elsewhere on the board
L_19: J1.B15, J4.40; also elsewhere on the board
L_20: J1.A17, J4.42; also elsewhere on the board
L_21: J1.B17, J4.44; also elsewhere on the board
L_22: J1.A18, J4.46; also elsewhere on the board
L_23: J1.B18, J4.48; also elsewhere on the board
L_24: J1.A20, J4.50; also elsewhere on the board
L_25: J1.B20, J5.2; also elsewhere on the board
L_26: J1.A21, J5.4; also elsewhere on the board
L_27: J1.B21, J5.6; also elsewhere on the board
L_28: J1.A23, J5.8; also elsewhere on the board
L_29: J1.B23, J5.10; also elsewhere on the board
L_30: J1.A24, J5.12; also elsewhere on the board
L_31: J1.B24, J5.14; also elsewhere on the board
L_32: J1.A26, J5.16; also elsewhere on the board
L_33: J1.B26, J5.18; also elsewhere on the board
L_34: J1.A27, J5.20; also elsewhere on the board
L_35: J1.B27, J5.22; also elsewhere on the board
L_36: J1.A29, J5.24; also elsewhere on the board
L_37: J1.B29, J5.26; also elsewhere on the board
L_38: J1.A30, J5.28; also elsewhere on the board
L_39: J1.B30, J5.30; also elsewhere on the board
L_40: J1.A32, J5.32; also elsewhere on the board
L_41: J1.B32, J5.34; also elsewhere on the board
L_42: J1.A33, J5.36; also elsewhere on the board
L_43: J1.B33, J5.38; also elsewhere on the board
L_44: J1.A35, J5.40; also elsewhere on the board
L_45: J1.B35, J5.42; also elsewhere on the board
L_46: J1.A36, J5.44; also elsewhere on the board
L_47: J1.B36, J5.46; also elsewhere on the board
L_48: J1.A38, J5.48; also elsewhere on the board
L_49: J1.B38, J5.50; also elsewhere on the board
R_0: J2.A2, J6.1; also elsewhere on the board
R_1: J2.B2, J6.3; also elsewhere on the board
R_2: J2.A3, J6.5; also elsewhere on the board
R_3: J2.B3, J6.7; also elsewhere on the board
R_4: J2.A5, J6.9; also elsewhere on the board
R_5: J2.B5, J6.11; also elsewhere on the board
R_6: J2.A6, J6.13; also elsewhere on the board
R_7: J2.B6, J6.15; also elsewhere on the board
R_8: J2.A8, J6.17; also elsewhere on the board
R_9: J2.B8, J6.19; also elsewhere on the board
R_10: J2.A9, J6.21; also elsewhere on the board
R_11: J2.B9, J6.23; also elsewhere on the board
R_12: J2.A11, J6.25; also elsewhere on the board
R_13: J2.B11, J6.27; also elsewhere on the board
R_14: J2.A12, J6.29; also elsewhere on the board
R_15: J2.B12, J6.31; also elsewhere on the board
R_16: J2.A14, J6.33; also elsewhere on the board
R_17: J2.B14, J6.35; also elsewhere on the board
R_18: J2.A15, J6.37; also elsewhere on the board
R_19: J2.B15, J6.39; also elsewhere on the board
R_20: J2.A17, J6.41; also elsewhere on the board
R_21: J2.B17, J6.43; also elsewhere on the board
R_22: J2.A18, J6.45; also elsewhere on the board
R_23: J2.B18, J6.47; also elsewhere on the board
R_24: J2.A20, J6.49; also elsewhere on the board
R_25: J2.B20, J7.1; also elsewhere on the board
R_26: J2.A21, J7.3; also elsewhere on the board
R_27: J2.B21, J7.5; also elsewhere on the board
R_28: J2.A23, J7.7; also elsewhere on the board
R_29: J2.B23, J7.9; also elsewhere on the board
R_30: J2.A24, J7.11; also elsewhere on the board
R_31: J2.B24, J7.13; also elsewhere on the board
R_32: J2.A26, J7.15; also elsewhere on the board
R_33: J2.B26, J7.17; also elsewhere on the board
R_34: J2.A27, J7.19; also elsewhere on the board
R_35: J2.B27, J7.21; also elsewhere on the board
R_36: J2.A29, J7.23; also elsewhere on the board
R_37: J2.B29, J7.25; also elsewhere on the board
R_38: J2.A30, J7.27; also elsewhere on the board
R_39: J2.B30, J7.29; also elsewhere on the board
R_40: J2.A32, J7.31; also elsewhere on the board
R_41: J2.B32, J7.33; also elsewhere on the board
R_42: J2.A33, J7.35; also elsewhere on the board
R_43: J2.B33, J7.37; also elsewhere on the board
R_44: J2.A35, J7.39; also elsewhere on the board
R_45: J2.B35, J7.41; also elsewhere on the board
R_46: J2.A36, J7.43; also elsewhere on the board
R_47: J2.B36, J7.45; also elsewhere on the board
R_48: J2.A38, J7.47; also elsewhere on the board
R_49: J2.B38, J7.49; also elsewhere on the board

Notes on the sheet:
LEFT_UPPER
POWER
LEFT_LOWER
LEFT
RIGHT_UPPER
RIGHT
RIGHT_LOWER

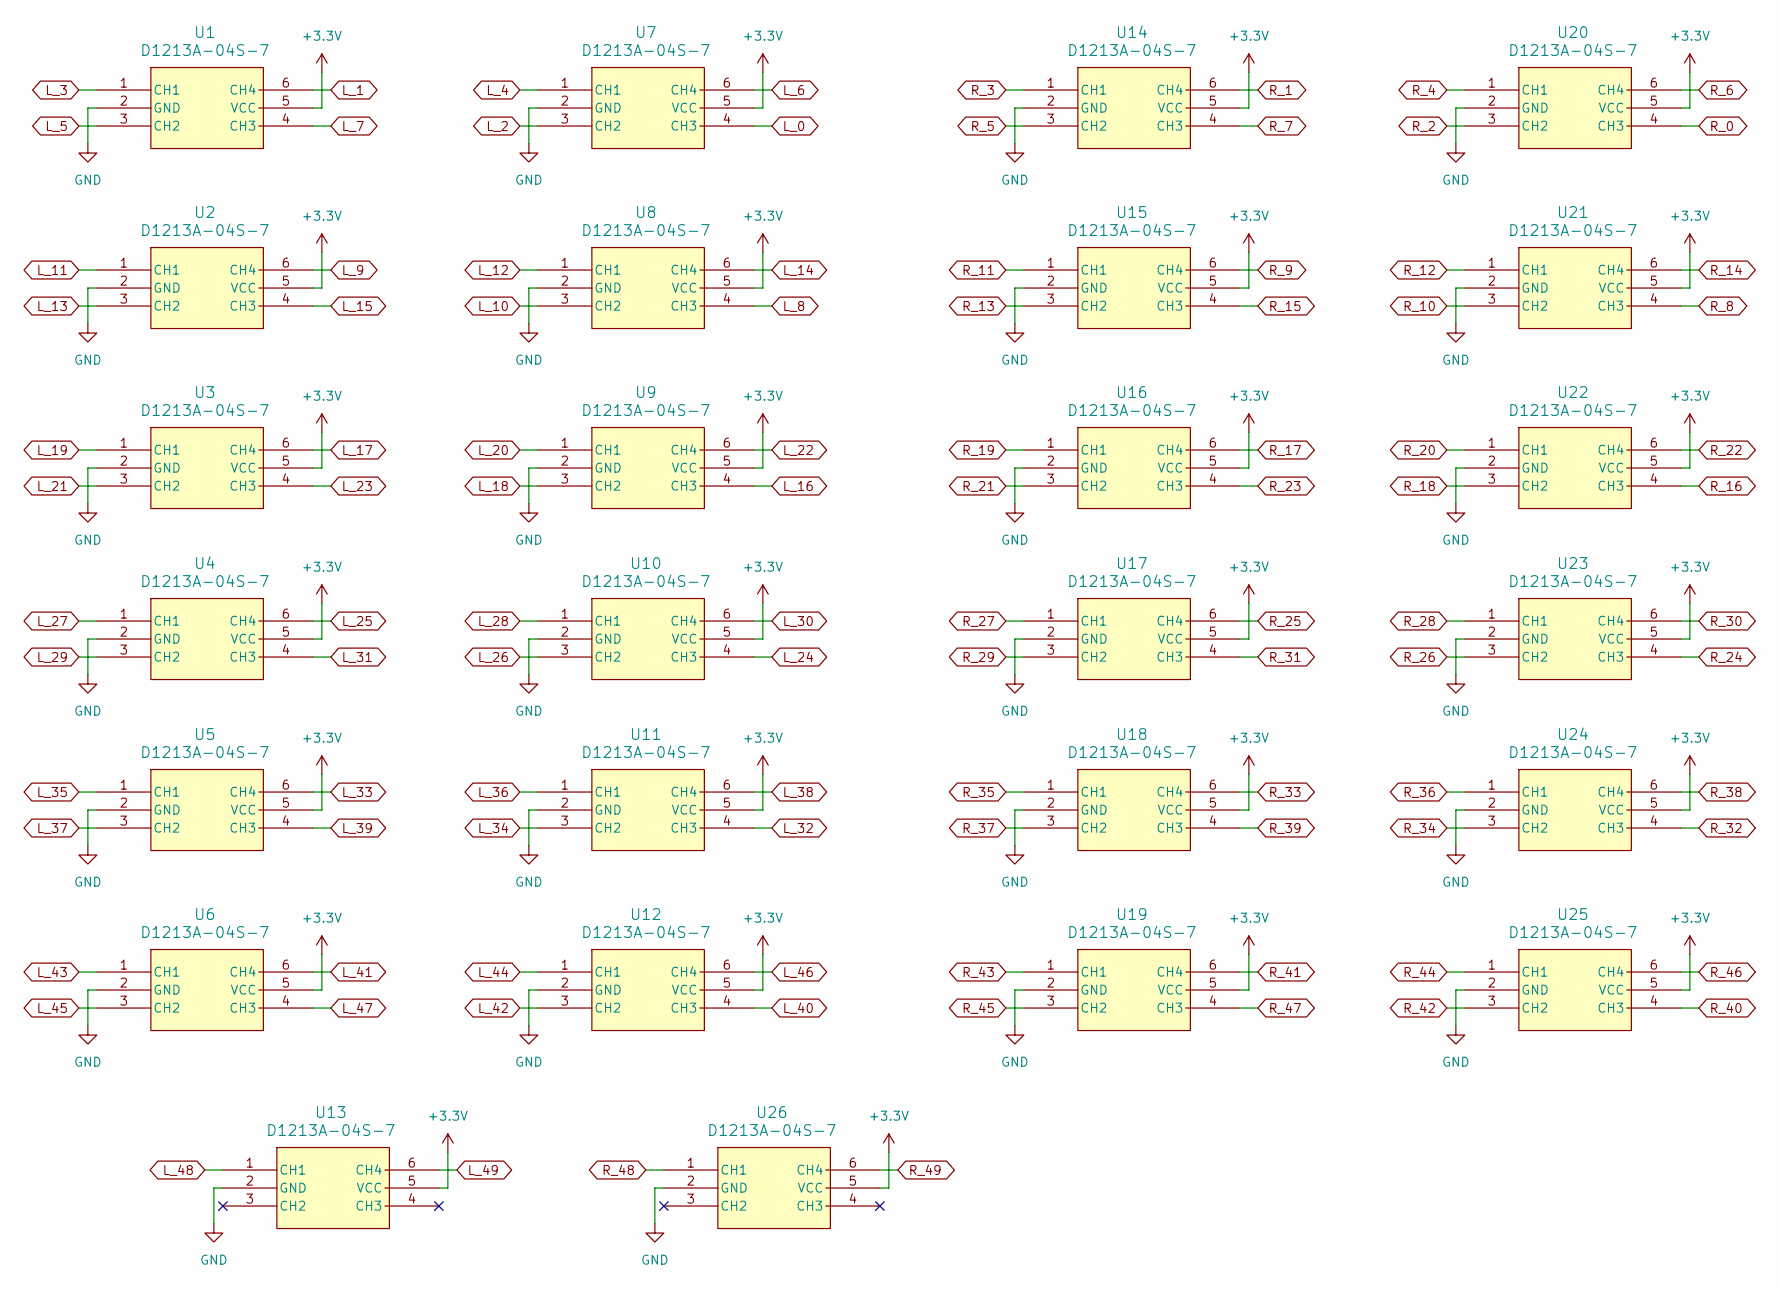
[picture p19: schematic ESD_diodes.kicad_sch]

Parts:
U1, U2, U3, U4, U5, U6, U7, U8, U9, U10, U11, U12, U13, U14, U15, U16, U17, U18, U19, U20, U21, U22, U23, U24, U25, U26: D1213A-04S-7; SOT-363_DIO; Part Number D1213A-04S-7-ES; LCSC# C41409235

Connections:
L_0: U7.4 (CH3); also elsewhere on the board
L_1: U1.6 (CH4); also elsewhere on the board
L_2: U7.3 (CH2); also elsewhere on the board
L_3: U1.1 (CH1); also elsewhere on the board
L_4: U7.1 (CH1); also elsewhere on the board
L_5: U1.3 (CH2); also elsewhere on the board
L_6: U7.6 (CH4); also elsewhere on the board
L_7: U1.4 (CH3); also elsewhere on the board
L_8: U8.4 (CH3); also elsewhere on the board
L_9: U2.6 (CH4); also elsewhere on the board
L_10: U8.3 (CH2); also elsewhere on the board
L_11: U2.1 (CH1); also elsewhere on the board
L_12: U8.1 (CH1); also elsewhere on the board
L_13: U2.3 (CH2); also elsewhere on the board
L_14: U8.6 (CH4); also elsewhere on the board
L_15: U2.4 (CH3); also elsewhere on the board
L_16: U9.4 (CH3); also elsewhere on the board
L_17: U3.6 (CH4); also elsewhere on the board
L_18: U9.3 (CH2); also elsewhere on the board
L_19: U3.1 (CH1); also elsewhere on the board
L_20: U9.1 (CH1); also elsewhere on the board
L_21: U3.3 (CH2); also elsewhere on the board
L_22: U9.6 (CH4); also elsewhere on the board
L_23: U3.4 (CH3); also elsewhere on the board
L_24: U10.4 (CH3); also elsewhere on the board
L_25: U4.6 (CH4); also elsewhere on the board
L_26: U10.3 (CH2); also elsewhere on the board
L_27: U4.1 (CH1); also elsewhere on the board
L_28: U10.1 (CH1); also elsewhere on the board
L_29: U4.3 (CH2); also elsewhere on the board
L_30: U10.6 (CH4); also elsewhere on the board
L_31: U4.4 (CH3); also elsewhere on the board
L_32: U11.4 (CH3); also elsewhere on the board
L_33: U5.6 (CH4); also elsewhere on the board
L_34: U11.3 (CH2); also elsewhere on the board
L_35: U5.1 (CH1); also elsewhere on the board
L_36: U11.1 (CH1); also elsewhere on the board
L_37: U5.3 (CH2); also elsewhere on the board
L_38: U11.6 (CH4); also elsewhere on the board
L_39: U5.4 (CH3); also elsewhere on the board
L_40: U12.4 (CH3); also elsewhere on the board
L_41: U6.6 (CH4); also elsewhere on the board
L_42: U12.3 (CH2); also elsewhere on the board
L_43: U6.1 (CH1); also elsewhere on the board
L_44: U12.1 (CH1); also elsewhere on the board
L_45: U6.3 (CH2); also elsewhere on the board
L_46: U12.6 (CH4); also elsewhere on the board
L_47: U6.4 (CH3); also elsewhere on the board
L_48: U13.1 (CH1); also elsewhere on the board
L_49: U13.6 (CH4); also elsewhere on the board
R_0: U20.4 (CH3); also elsewhere on the board
R_1: U14.6 (CH4); also elsewhere on the board
R_2: U20.3 (CH2); also elsewhere on the board
R_3: U14.1 (CH1); also elsewhere on the board
R_4: U20.1 (CH1); also elsewhere on the board
R_5: U14.3 (CH2); also elsewhere on the board
R_6: U20.6 (CH4); also elsewhere on the board
R_7: U14.4 (CH3); also elsewhere on the board
R_8: U21.4 (CH3); also elsewhere on the board
R_9: U15.6 (CH4); also elsewhere on the board
R_10: U21.3 (CH2); also elsewhere on the board
R_11: U15.1 (CH1); also elsewhere on the board
R_12: U21.1 (CH1); also elsewhere on the board
R_13: U15.3 (CH2); also elsewhere on the board
R_14: U21.6 (CH4); also elsewhere on the board
R_15: U15.4 (CH3); also elsewhere on the board
R_16: U22.4 (CH3); also elsewhere on the board
R_17: U16.6 (CH4); also elsewhere on the board
R_18: U22.3 (CH2); also elsewhere on the board
R_19: U16.1 (CH1); also elsewhere on the board
R_20: U22.1 (CH1); also elsewhere on the board
R_21: U16.3 (CH2); also elsewhere on the board
R_22: U22.6 (CH4); also elsewhere on the board
R_23: U16.4 (CH3); also elsewhere on the board
R_24: U23.4 (CH3); also elsewhere on the board
R_25: U17.6 (CH4); also elsewhere on the board
R_26: U23.3 (CH2); also elsewhere on the board
R_27: U17.1 (CH1); also elsewhere on the board
R_28: U23.1 (CH1); also elsewhere on the board
R_29: U17.3 (CH2); also elsewhere on the board
R_30: U23.6 (CH4); also elsewhere on the board
R_31: U17.4 (CH3); also elsewhere on the board
R_32: U24.4 (CH3); also elsewhere on the board
R_33: U18.6 (CH4); also elsewhere on the board
R_34: U24.3 (CH2); also elsewhere on the board
R_35: U18.1 (CH1); also elsewhere on the board
R_36: U24.1 (CH1); also elsewhere on the board
R_37: U18.3 (CH2); also elsewhere on the board
R_38: U24.6 (CH4); also elsewhere on the board
R_39: U18.4 (CH3); also elsewhere on the board
R_40: U25.4 (CH3); also elsewhere on the board
R_41: U19.6 (CH4); also elsewhere on the board
R_42: U25.3 (CH2); also elsewhere on the board
R_43: U19.1 (CH1); also elsewhere on the board
R_44: U25.1 (CH1); also elsewhere on the board
R_45: U19.3 (CH2); also elsewhere on the board
R_46: U25.6 (CH4); also elsewhere on the board
R_47: U19.4 (CH3); also elsewhere on the board
R_48: U26.1 (CH1); also elsewhere on the board
R_49: U26.6 (CH4); also elsewhere on the board

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
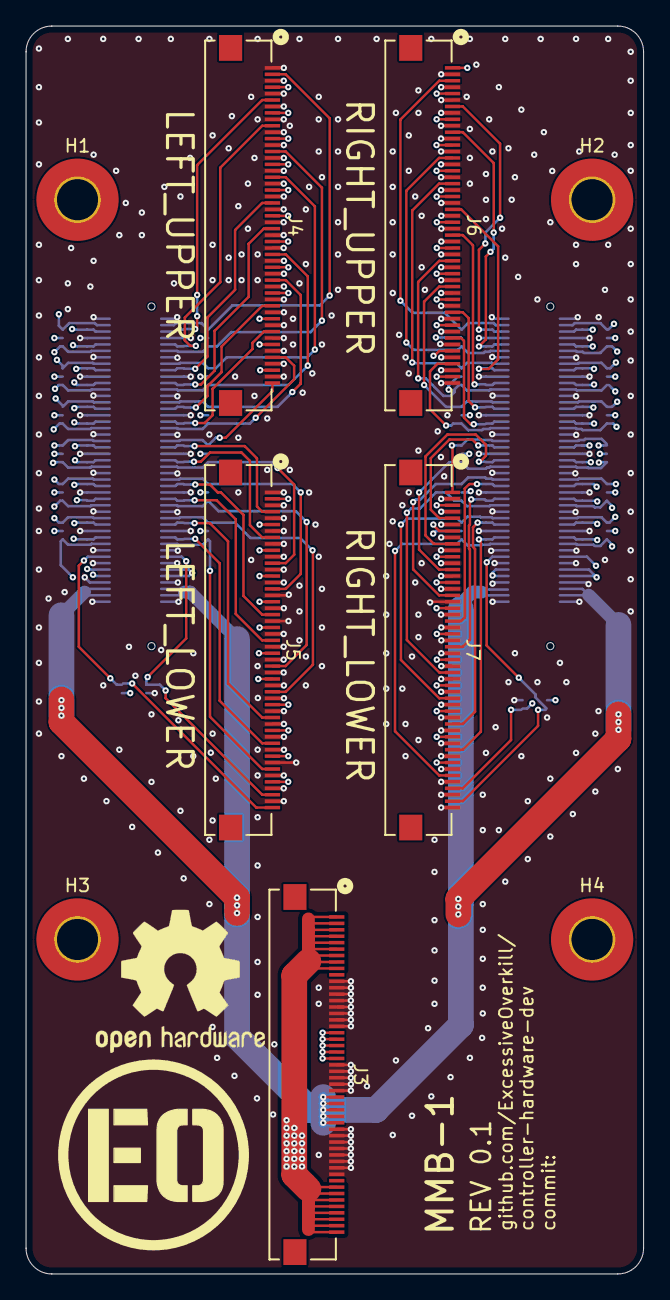
[picture p20: board Main Mezzanine Backplane.kicad_pcb from above]

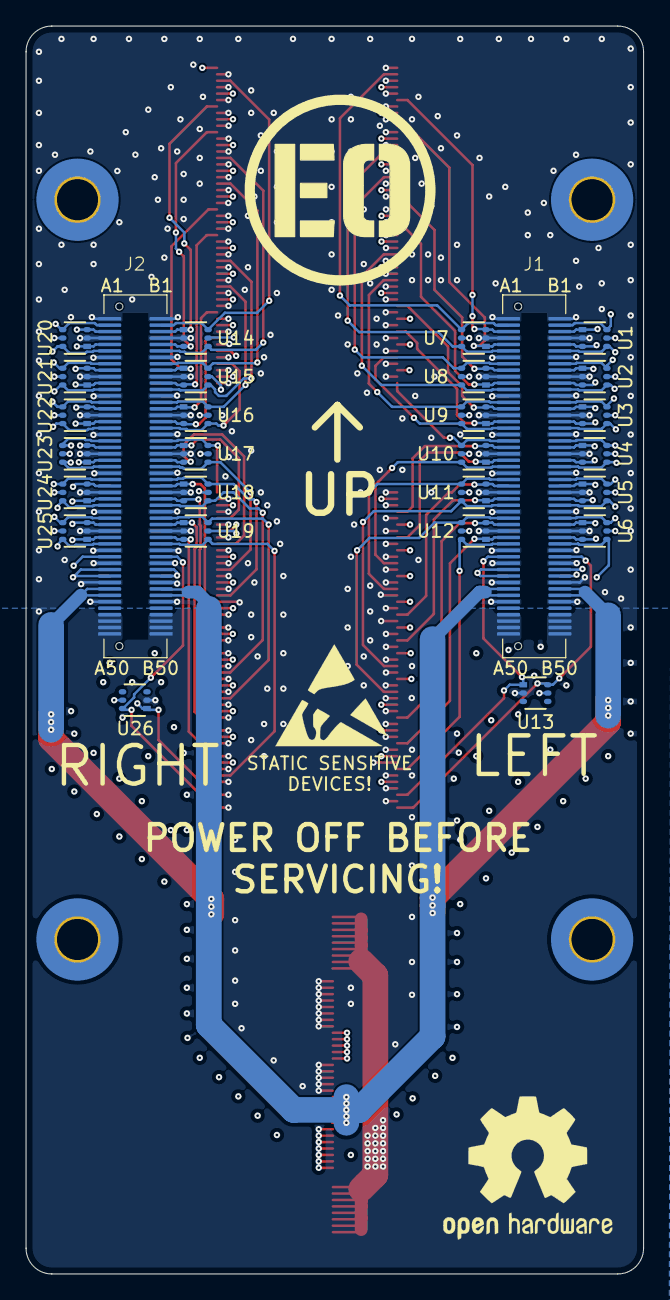
[picture p21: board Main Mezzanine Backplane.kicad_pcb from below]

Board: 4 copper layers, 48.0 x 97.0 mm, 37 parts (28 on the bottom side), 104 nets.
