ExcessiveOverkill/controller-hardware-dev/KiCad/Modular MiYR interface/Modular MiYR interface.kicad_pcb

## KiCad design KiCad/Modular MiYR interface/Modular MiYR interface.kicad_pcb (2026-10-19)

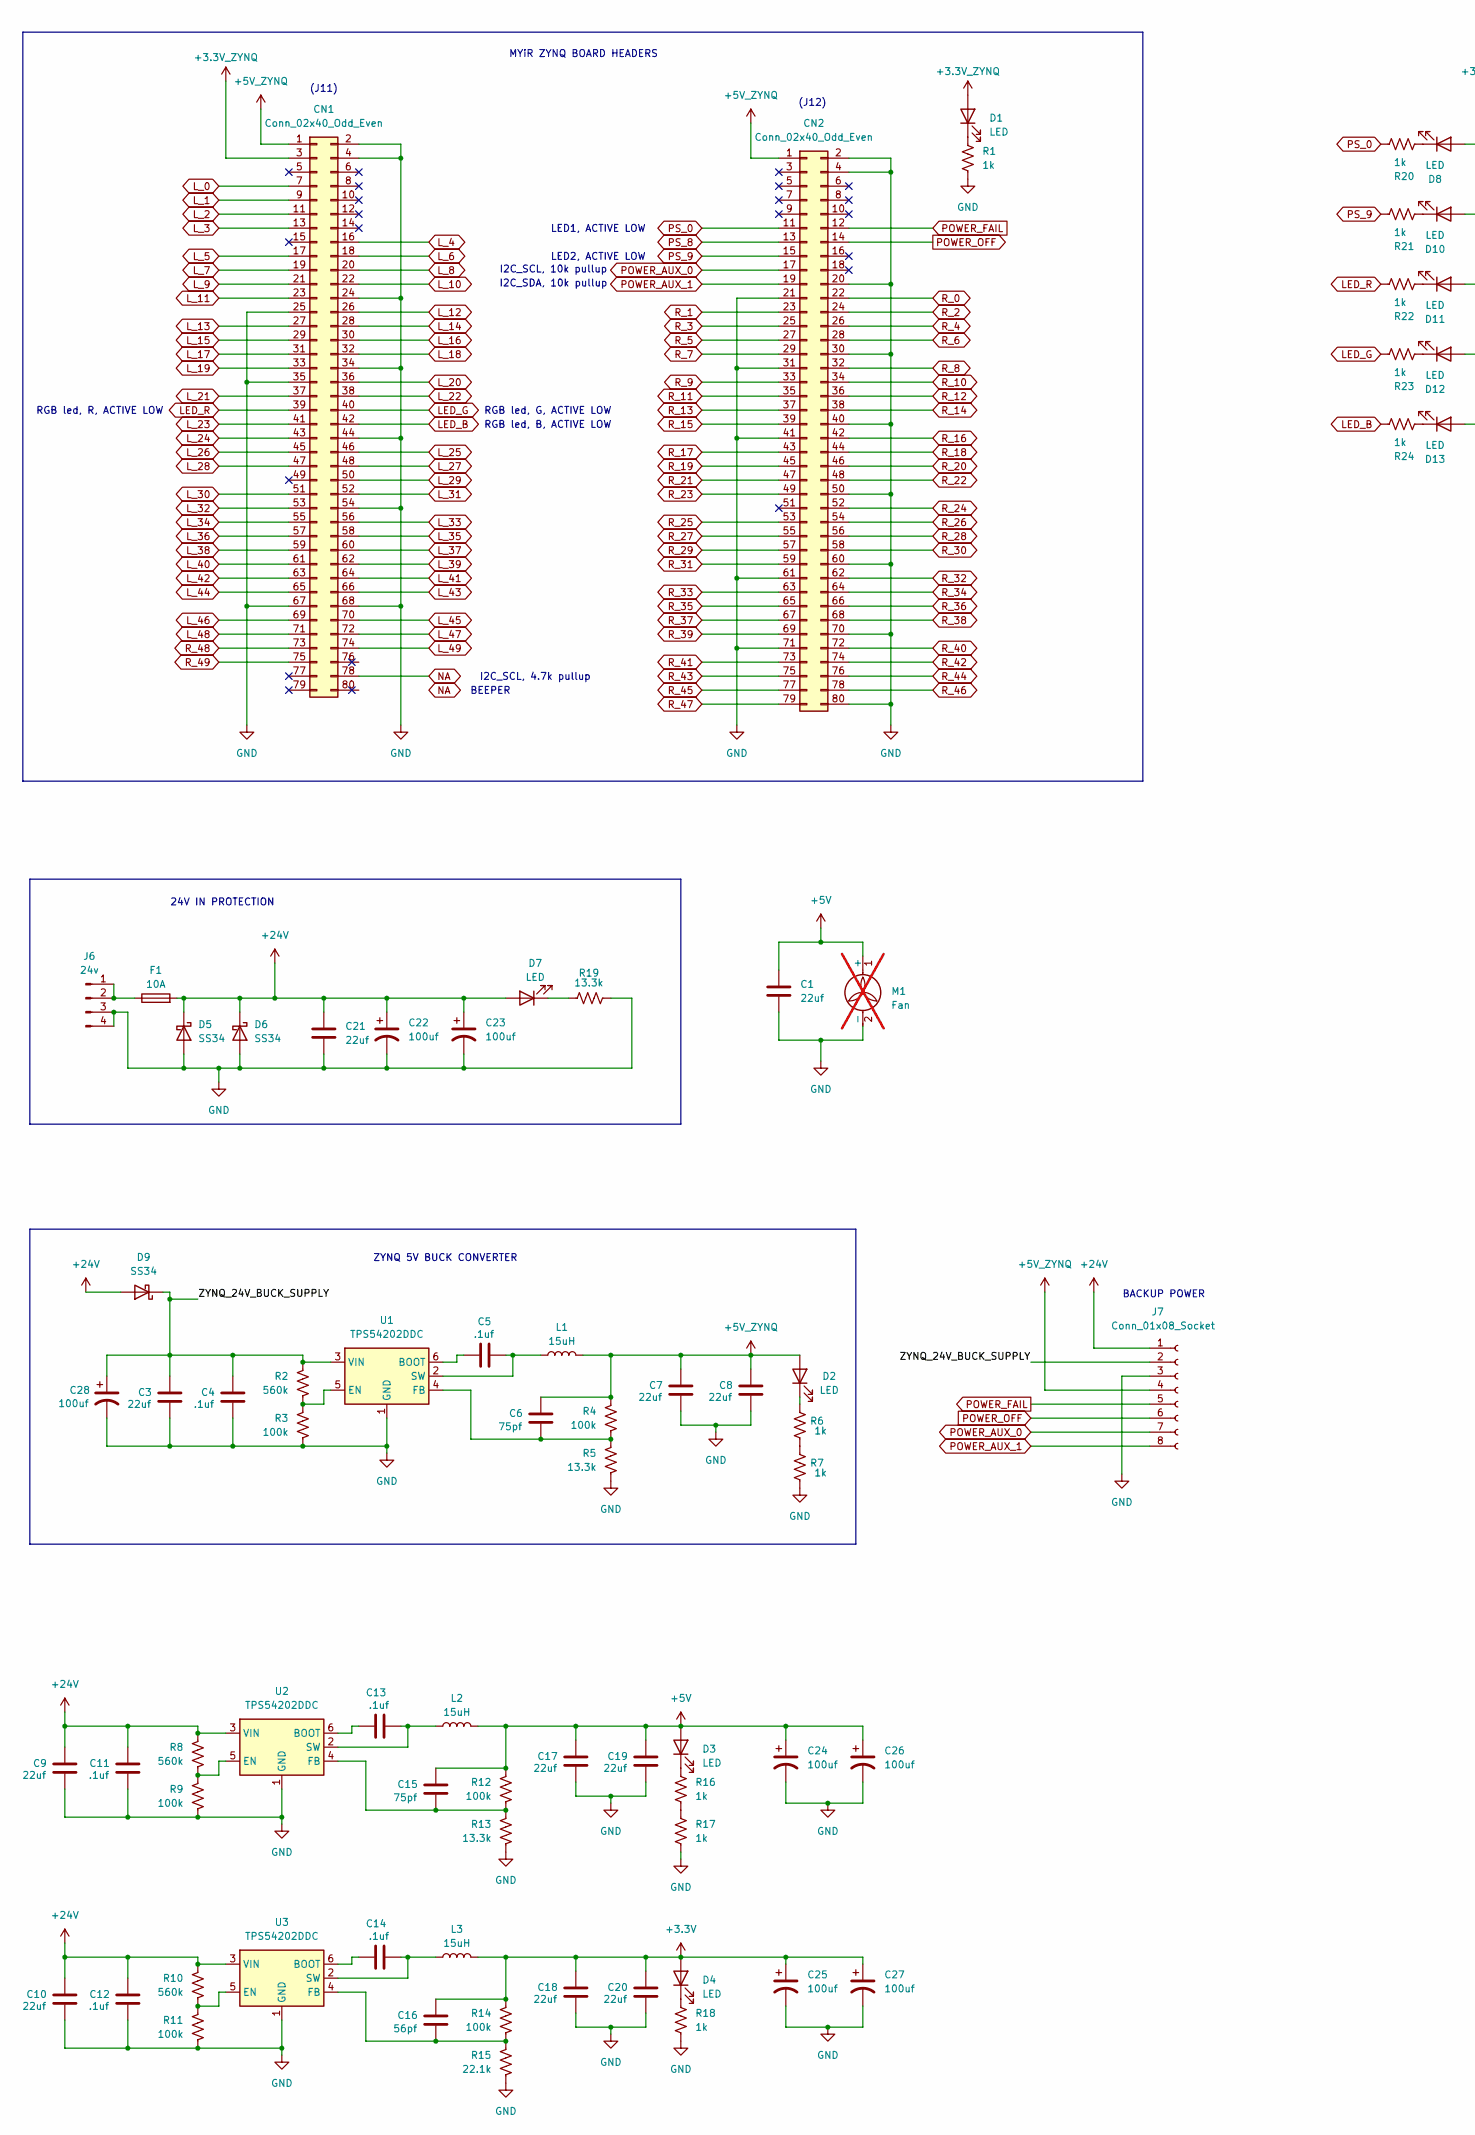
[picture p22: schematic Modular MiYR interface.kicad_sch, part in row 1, column 1]

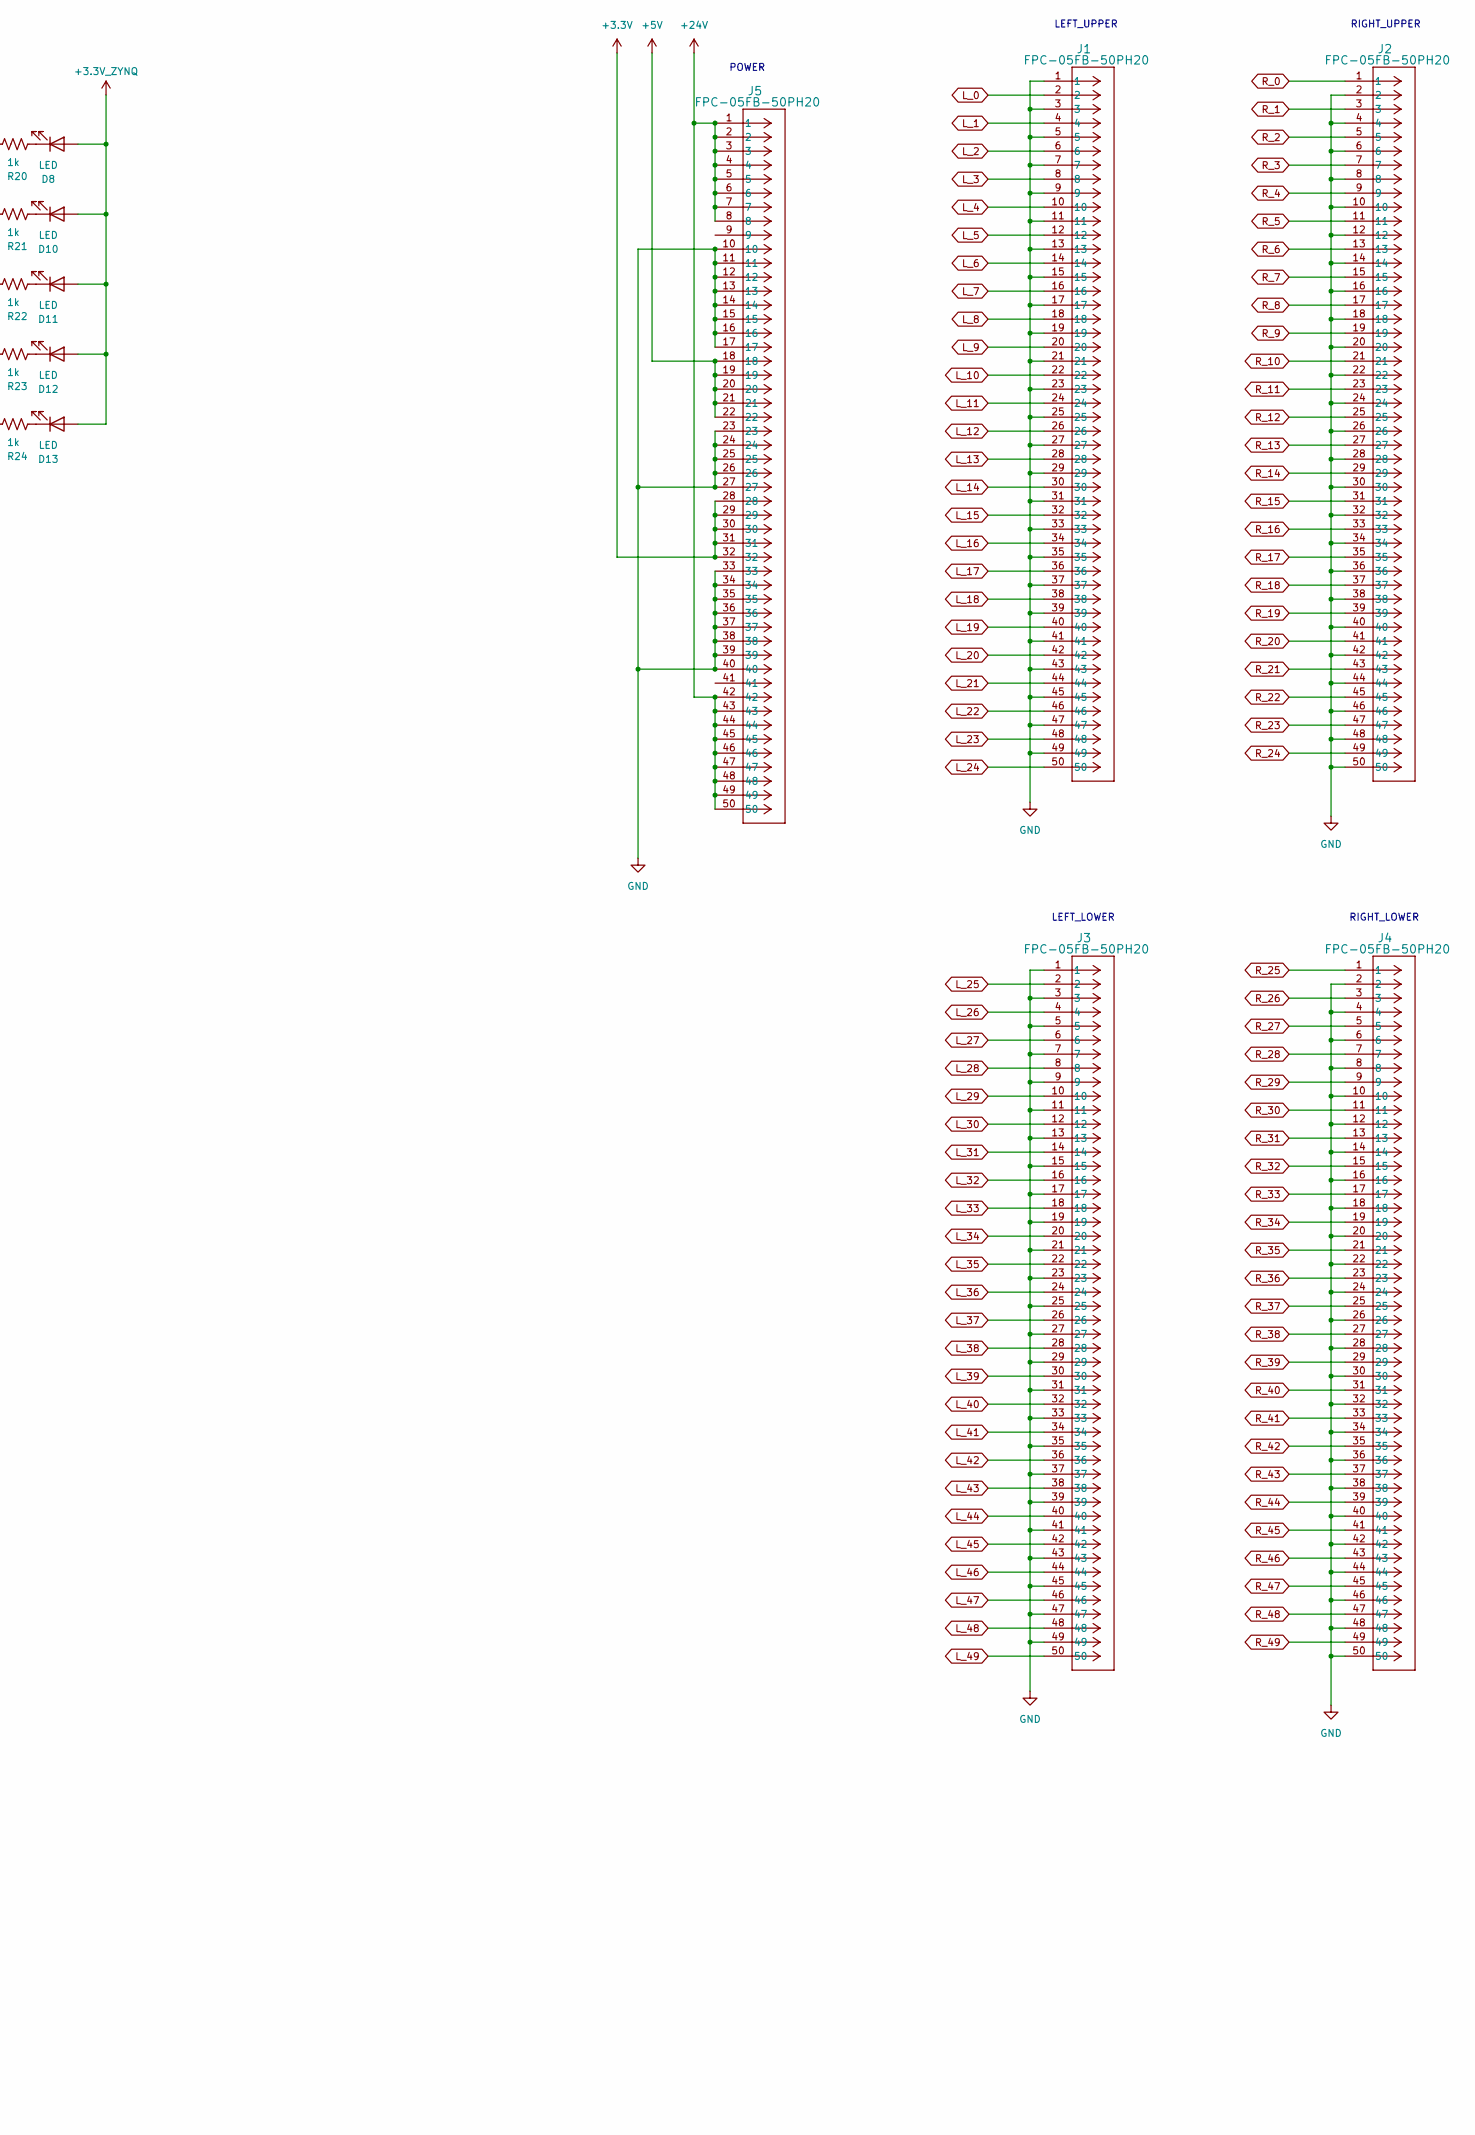
[picture p23: schematic Modular MiYR interface.kicad_sch, part in row 1, column 2]

Parts:
C1, C3, C7, C8, C9, C10, C17, C18, C19, C20, C21: 22uf; C_1206_3216Metric; Part Number CL31A226KAHNNNE; LCSC# C12891
C4, C5, C11, C12, C13, C14: .1uf; C_0402_1005Metric; Part Number CC0402KRX5R9BB104; LCSC# C105882
C6, C15: 75pf; C_0402_1005Metric; Part Number CC0402JRNPO9BN750; LCSC# C107010
C16: 56pf; C_0402_1005Metric; Part Number CC0402JRNPO9BN560; LCSC# C107007
C22, C23, C24, C25, C26, C27, C28: 100uf; CP_Elec_6.3x7.7; Part Number RVT1V101M0607; LCSC# C72478
CN1, CN2: Conn_02x40_Odd_Even; PinHeader_2x40_P1.27mm_Vertical_SMD_FLIPPED; Part Number HDGC127-PS2-40; LCSC# C45359092
D1, D2, D3, D4, D7, D8, D10, D11, D12, D13: LED; LED_0603_1608Metric; Part Number XL-1608UBC-04; LCSC# C965807
D5, D6, D9: SS34; D_SMA; Part Number SS34; LCSC# C8678
F1: 10A; Fuse_1206_3216Metric; Part Number JFC1206-2100FS; LCSC# C136354
J1, J2, J3, J4, J5: FPC-05FB-50PH20; CONN50_FPC-05FB-50PH20_XNP
J6: 24v; 2x02_P3.5_KF2EDGSR
J7: Conn_01x08_Socket; PinHeader_1x08_P2.54mm_Vertical
L1, L2, L3: 15uH; CY54_INDUCTOR; Part Number CY54-15UH; LCSC# C2929432
M1: Fan; PinHeader_1x02_P2.54mm_Vertical; not fitted
R1, R6, R7, R16, R17, R18, R20, R21, R22, R23, R24: 1k; R_0402_1005Metric; Part Number RC0402FR-071KL; LCSC# C106235
R2, R8, R10: 560k; R_0402_1005Metric; Part Number RC0402FR-07560KL; LCSC# C137958
R3, R4, R9, R11, R12, R14: 100k; R_0402_1005Metric; Part Number RC0402FR-07100KL; LCSC# C60491
R5, R13, R19: 13.3k; R_0402_1005Metric; Part Number RC0402FR-0713K3L; LCSC# C274352
R15: 22.1k; R_0402_1005Metric; Part Number RC0402FR-0722K1L; LCSC# C163478
U1, U2, U3: TPS54202DDC; SOT-23-6; Part Number TPS54202DDCR; LCSC# C191884

Connections:
+3.3V: C16.2, C18.2, C20.2, C25.1, C27.1, D4.2 (A), J5.28, J5.29, J5.30, J5.31, J5.32, L3.2, R14.2
+3.3V_ZYNQ: CN1.3, D1.2 (A), D8.2 (A), D10.2 (A), D11.2 (A), D12.2 (A), D13.2 (A)
+5V: C1.1, C15.2, C17.2, C19.2, C24.1, C26.1, D3.2 (A), J5.18, J5.19, J5.20, J5.21, J5.22, L2.2, M1.1 (+), R12.2
+5V_ZYNQ: C6.2, C7.2, C8.2, CN1.1, CN2.1, D2.2 (A), J7.4, L1.2, R4.2
+24V: C9.2, C10.2, C11.2, C12.2, C21.1, C22.1, C23.1, D5.1 (K), D6.1 (K), D7.2 (A), D9.2 (A), F1.2, J5.1, J5.2, J5.3, J5.4, J5.5, J5.6, J5.7, J5.8, J5.42, J5.43, J5.44, J5.45, J5.46, J5.47, J5.48, J5.49, J5.50, J7.1, R8.2, R10.2, U2.3 (VIN), U3.3 (VIN)
/ZYNQ_24V_BUCK_SUPPLY: C3.2, C4.2, C28.1, D9.1 (K), J7.2, R2.2, U1.3 (VIN)
GND: C1.2, C3.1, C4.1, C7.1, C8.1, C9.1, C10.1, C11.1, C12.1, C17.1, C18.1, C19.1, C20.1, C21.2, C22.2, C23.2, C24.2, C25.2, C26.2, C27.2, C28.2, CN1.2, CN1.4, CN1.24, CN1.25, CN1.34, CN1.35, CN1.44, CN1.54, CN1.67, CN1.68, CN2.2, CN2.4, CN2.20, CN2.21, CN2.30, CN2.31, CN2.40, CN2.41, CN2.50, CN2.60, CN2.61, CN2.70, CN2.71, CN2.80, D5.2 (A), D6.2 (A), J1.1, J1.3, J1.5, J1.7, J1.9, J1.11, J1.13, J1.15, J1.17, J1.19, J1.21, J1.23, J1.25, J1.27, J1.29, J1.31, J1.33, J1.35, J1.37, J1.39, J1.41, J1.43, J1.45, J1.47, J1.49, J2.2, J2.4, J2.6, J2.8, J2.10, J2.12, J2.14, J2.16, J2.18, J2.20, J2.22, J2.24, J2.26, J2.28, J2.30, J2.32, J2.34, J2.36, J2.38, J2.40, J2.42, J2.44, J2.46, J2.48, J2.50, J3.1, J3.3, J3.5, J3.7, J3.9, J3.11, J3.13, J3.15, J3.17, J3.19, J3.21, J3.23, J3.25, J3.27, J3.29, J3.31, J3.33, J3.35, J3.37, J3.39, J3.41, J3.43, J3.45, J3.47, J3.49, J4.2, J4.4, J4.6, J4.8, J4.10, J4.12, J4.14, J4.16, J4.18, J4.20, J4.22, J4.24, J4.26, J4.28, J4.30, J4.32, J4.34, J4.36, J4.38, J4.40, J4.42, J4.44, J4.46, J4.48, J4.50, J5.10, J5.11, J5.12, J5.13, J5.14, J5.15, J5.16, J5.17, J5.23, J5.24, J5.25, J5.26, J5.27, J5.33, J5.34, J5.35, J5.36, J5.37, J5.38, J5.39, J5.40, J6.3, J6.4, J7.3, M1.2 (-), R1.1, R3.1, R5.1, R7.1, R9.1, R11.1, R13.1, R15.1, R17.1, R18.1, R19.1, U1.1 (GND), U2.1 (GND), U3.1 (GND)
LED_B: CN1.42, R24.1
LED_G: CN1.40, R23.1
LED_R: CN1.39, R22.1
L_0: CN1.7, J1.2
L_1: CN1.9, J1.4
L_2: CN1.11, J1.6
L_3: CN1.13, J1.8
L_4: CN1.16, J1.10
L_5: CN1.17, J1.12
L_6: CN1.18, J1.14
L_7: CN1.19, J1.16
L_8: CN1.20, J1.18
L_9: CN1.21, J1.20
L_10: CN1.22, J1.22
L_11: CN1.23, J1.24
L_12: CN1.26, J1.26
L_13: CN1.27, J1.28
L_14: CN1.28, J1.30
L_15: CN1.29, J1.32
L_16: CN1.30, J1.34
L_17: CN1.31, J1.36
L_18: CN1.32, J1.38
L_19: CN1.33, J1.40
L_20: CN1.36, J1.42
L_21: CN1.37, J1.44
L_22: CN1.38, J1.46
L_23: CN1.41, J1.48
L_24: CN1.43, J1.50
L_25: CN1.46, J3.2
L_26: CN1.45, J3.4
L_27: CN1.48, J3.6
L_28: CN1.47, J3.8
L_29: CN1.50, J3.10
L_30: CN1.51, J3.12
L_31: CN1.52, J3.14
L_32: CN1.53, J3.16
L_33: CN1.56, J3.18
L_34: CN1.55, J3.20
L_35: CN1.58, J3.22
L_36: CN1.57, J3.24
L_37: CN1.60, J3.26
L_38: CN1.59, J3.28
L_39: CN1.62, J3.30
L_40: CN1.61, J3.32
L_41: CN1.64, J3.34
L_42: CN1.63, J3.36
L_43: CN1.66, J3.38
L_44: CN1.65, J3.40
L_45: CN1.70, J3.42
L_46: CN1.69, J3.44
L_47: CN1.72, J3.46
L_48: CN1.71, J3.48
L_49: CN1.74, J3.50
NA: CN1.78
unnamed: D1.1 (K), R1.2
unnamed: D2.1 (K), R6.2
unnamed: D3.1 (K), R16.2
unnamed: D4.1 (K), R18.2
unnamed: D7.1 (K), R19.2
unnamed: D8.1 (K), R20.2
unnamed: D10.1 (K), R21.2
unnamed: D11.1 (K), R22.2
unnamed: D12.1 (K), R23.2
unnamed: D13.1 (K), R24.2
unnamed: F1.1, J6.1, J6.2
unnamed: R6.1, R7.2
unnamed: R16.1, R17.2
unnamed: C5.1, U1.6 (BOOT)
unnamed: R2.1, R3.2, U1.5 (EN)
unnamed: C6.1, R4.1, R5.2, U1.4 (FB)
unnamed: C5.2, L1.1, U1.2 (SW)
unnamed: C13.1, U2.6 (BOOT)
unnamed: R8.1, R9.2, U2.5 (EN)
unnamed: C15.1, R12.1, R13.2, U2.4 (FB)
unnamed: C13.2, L2.1, U2.2 (SW)
unnamed: C14.1, U3.6 (BOOT)
unnamed: R10.1, R11.2, U3.5 (EN)
unnamed: C16.1, R14.1, R15.2, U3.4 (FB)
unnamed: C14.2, L3.1, U3.2 (SW)
POWER_AUX_0: CN2.17, J7.7
POWER_AUX_1: CN2.19, J7.8
POWER_FAIL: CN2.12, J7.5
POWER_OFF: CN2.14, J7.6
PS_0: CN2.11, R20.1
PS_8: CN2.13
PS_9: CN2.15, R21.1
R_0: CN2.22, J2.1
R_1: CN2.23, J2.3
R_2: CN2.24, J2.5
R_3: CN2.25, J2.7
R_4: CN2.26, J2.9
R_5: CN2.27, J2.11
R_6: CN2.28, J2.13
R_7: CN2.29, J2.15
R_8: CN2.32, J2.17
R_9: CN2.33, J2.19
R_10: CN2.34, J2.21
R_11: CN2.35, J2.23
R_12: CN2.36, J2.25
R_13: CN2.37, J2.27
R_14: CN2.38, J2.29
R_15: CN2.39, J2.31
R_16: CN2.42, J2.33
R_17: CN2.43, J2.35
R_18: CN2.44, J2.37
R_19: CN2.45, J2.39
R_20: CN2.46, J2.41
R_21: CN2.47, J2.43
R_22: CN2.48, J2.45
R_23: CN2.49, J2.47
R_24: CN2.52, J2.49
R_25: CN2.53, J4.1
R_26: CN2.54, J4.3
R_27: CN2.55, J4.5
R_28: CN2.56, J4.7
R_29: CN2.57, J4.9
R_30: CN2.58, J4.11
R_31: CN2.59, J4.13
R_32: CN2.62, J4.15
R_33: CN2.63, J4.17
R_34: CN2.64, J4.19
R_35: CN2.65, J4.21
R_36: CN2.66, J4.23
R_37: CN2.67, J4.25
R_38: CN2.68, J4.27
R_39: CN2.69, J4.29
R_40: CN2.72, J4.31
R_41: CN2.73, J4.33
R_42: CN2.74, J4.35
R_43: CN2.75, J4.37
R_44: CN2.76, J4.39
R_45: CN2.77, J4.41
R_46: CN2.78, J4.43
R_47: CN2.79, J4.45
R_48: CN1.73, J4.47
R_49: CN1.75, J4.49

Notes on the sheet:
RIGHT_LOWER
MYiR ZYNQ BOARD HEADERS
BEEPER
24V IN PROTECTION
RGB led, B, ACTIVE LOW
POWER
ZYNQ 5V BUCK CONVERTER
RIGHT_UPPER
I2C_SCL, 10k pullup
RGB led, G, ACTIVE LOW
LED1, ACTIVE LOW
I2C_SDA, 10k pullup
LEFT_LOWER
(J11)
LED2, ACTIVE LOW
LEFT_UPPER
BACKUP POWER
I2C_SCL, 4.7k pullup
(J12)
RGB led, R, ACTIVE LOW

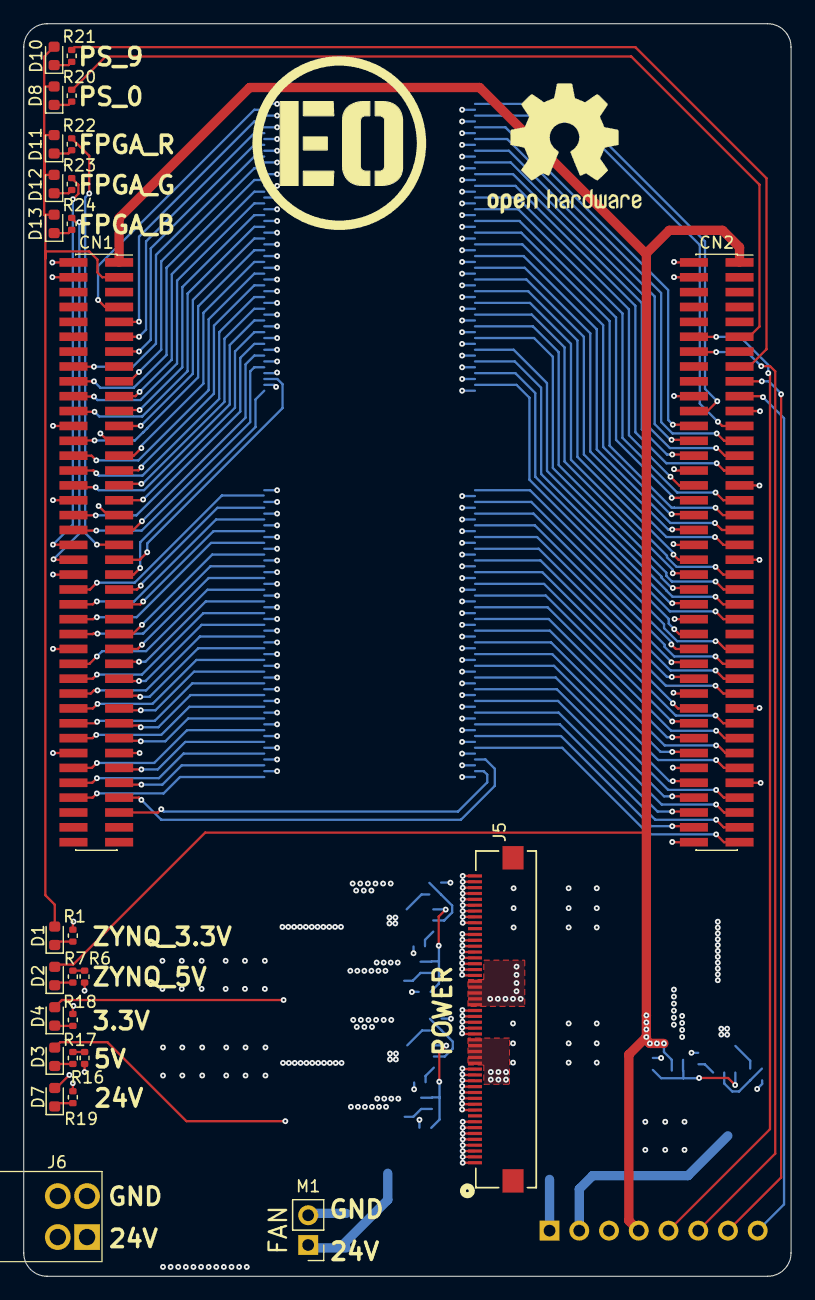
[picture p24: board Modular MiYR interface.kicad_pcb from above]

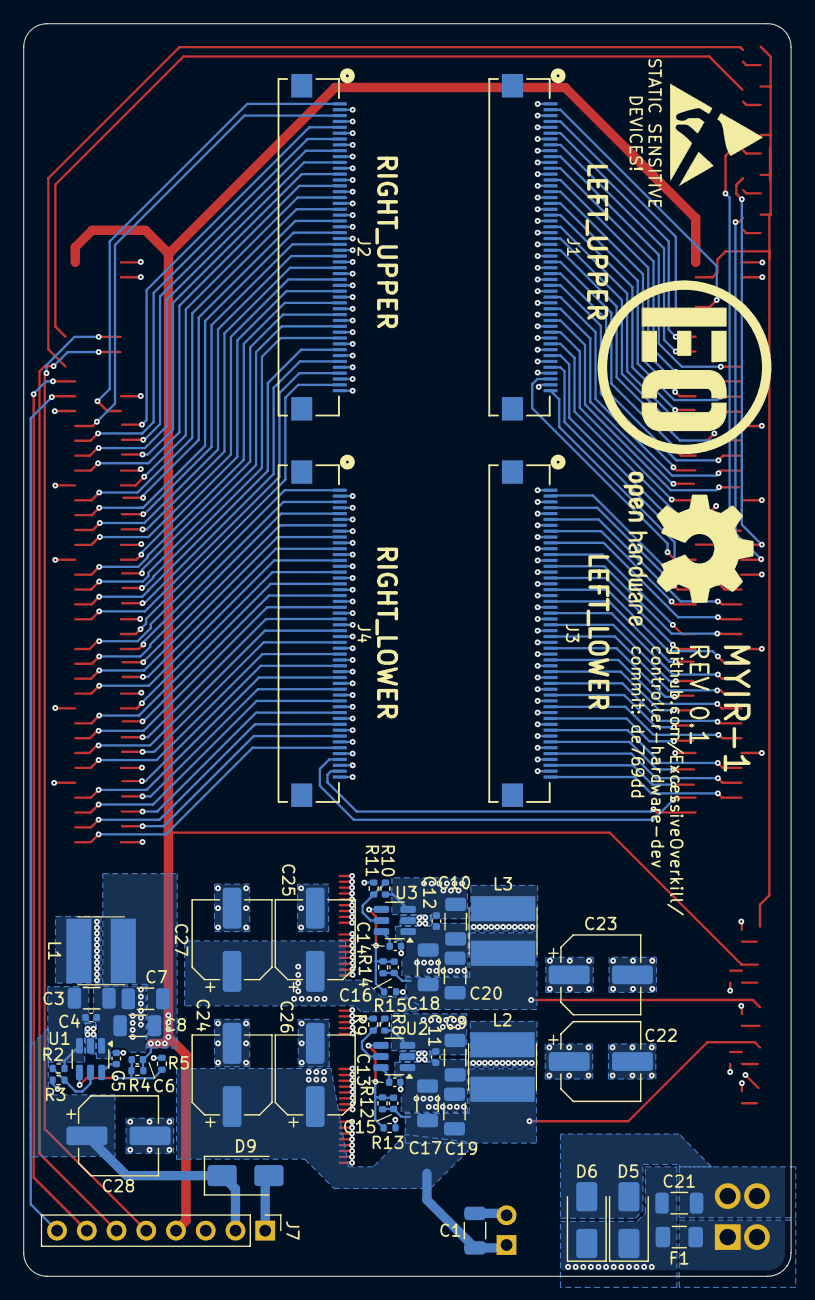
[picture p25: board Modular MiYR interface.kicad_pcb from below]

Board: 4 copper layers, 65.5 x 107.0 mm, 81 parts (54 on the bottom side), 141 nets.
