ExcessiveOverkill/controller-hardware-dev/KiCad/Mezzanine Backplane/Mezzanine Backplane.kicad_pcb

## KiCad design KiCad/Mezzanine Backplane/Mezzanine Backplane.kicad_pcb (2026-02-10)

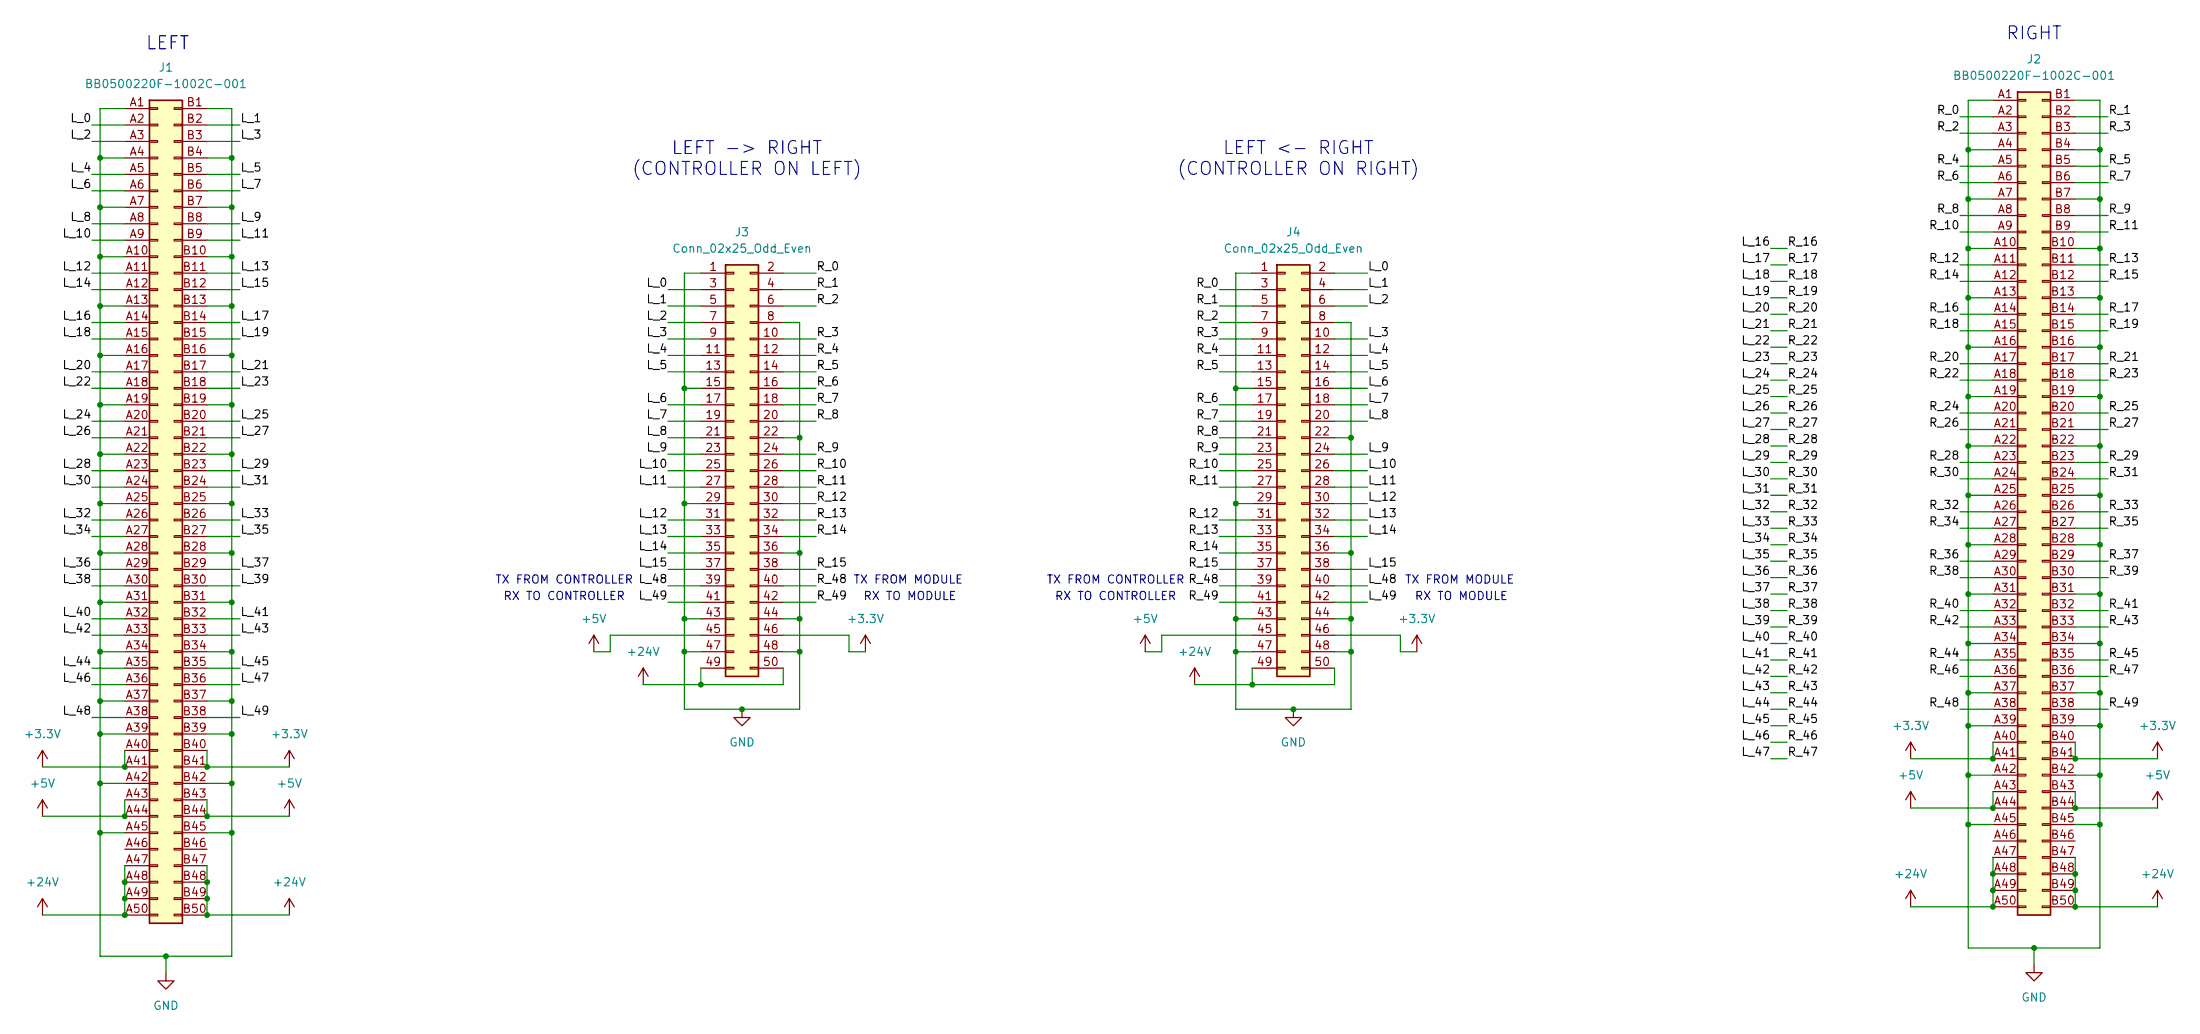
[picture p26: schematic Mezzanine Backplane.kicad_sch]

Parts:
J1, J2: BB0500220F-1002C-001; Part Number BB0500220F-1002C-001; LCSC# C42421167
J3, J4: Conn_02x25_Odd_Even; PinSocket_2x25_P2.00mm_Vertical_SMD; Part Number HC-PM200-4.3H-2x25PS; LCSC# C42163108

Connections:
+3.3V: J1.A40, J1.A41, J1.B40, J1.B41, J2.A40, J2.A41, J2.B40, J2.B41, J3.46, J4.46
+5V: J1.A43, J1.A44, J1.B43, J1.B44, J2.A43, J2.A44, J2.B43, J2.B44, J3.45, J4.45
+24V: J1.A47, J1.A48, J1.A49, J1.A50, J1.B47, J1.B48, J1.B49, J1.B50, J2.A47, J2.A48, J2.A49, J2.A50, J2.B47, J2.B48, J2.B49, J2.B50, J3.49, J3.50, J4.49, J4.50
/L_0: J1.A2, J3.3, J4.2
/L_1: J1.B2, J3.5, J4.4
/L_2: J1.A3, J3.7, J4.6
/L_3: J1.B3, J3.9, J4.10
/L_4: J1.A5, J3.11, J4.12
/L_5: J1.B5, J3.13, J4.14
/L_6: J1.A6, J3.17, J4.16
/L_7: J1.B6, J3.19, J4.18
/L_8: J1.A8, J3.21, J4.20
/L_9: J1.B8, J3.23, J4.24
/L_10: J1.A9, J3.25, J4.26
/L_11: J1.B9, J3.27, J4.28
/L_12: J1.A11, J3.31, J4.30
/L_13: J1.B11, J3.33, J4.32
/L_14: J1.A12, J3.35, J4.34
/L_15: J1.B12, J3.37, J4.38
/L_16: J1.A14, J2.A14
/L_17: J1.B14, J2.B14
/L_18: J1.A15, J2.A15
/L_19: J1.B15, J2.B15
/L_20: J1.A17, J2.A17
/L_21: J1.B17, J2.B17
/L_22: J1.A18, J2.A18
/L_23: J1.B18, J2.B18
/L_24: J1.A20, J2.A20
/L_25: J1.B20, J2.B20
/L_26: J1.A21, J2.A21
/L_27: J1.B21, J2.B21
/L_28: J1.A23, J2.A23
/L_29: J1.B23, J2.B23
/L_30: J1.A24, J2.A24
/L_31: J1.B24, J2.B24
/L_32: J1.A26, J2.A26
/L_33: J1.B26, J2.B26
/L_34: J1.A27, J2.A27
/L_35: J1.B27, J2.B27
/L_36: J1.A29, J2.A29
/L_37: J1.B29, J2.B29
/L_38: J1.A30, J2.A30
/L_39: J1.B30, J2.B30
/L_40: J1.A32, J2.A32
/L_41: J1.B32, J2.B32
/L_42: J1.A33, J2.A33
/L_43: J1.B33, J2.B33
/L_44: J1.A35, J2.A35
/L_45: J1.B35, J2.B35
/L_46: J1.A36, J2.A36
/L_47: J1.B36, J2.B36
/L_48: J1.A38, J3.39, J4.40
/L_49: J1.B38, J3.41, J4.42
/R_0: J2.A2, J3.2, J4.3
/R_1: J2.B2, J3.4, J4.5
/R_2: J2.A3, J3.6, J4.7
/R_3: J2.B3, J3.10, J4.9
/R_4: J2.A5, J3.12, J4.11
/R_5: J2.B5, J3.14, J4.13
/R_6: J2.A6, J3.16, J4.17
/R_7: J2.B6, J3.18, J4.19
/R_8: J2.A8, J3.20, J4.21
/R_9: J2.B8, J3.24, J4.23
/R_10: J2.A9, J3.26, J4.25
/R_11: J2.B9, J3.28, J4.27
/R_12: J2.A11, J3.30, J4.31
/R_13: J2.B11, J3.32, J4.33
/R_14: J2.A12, J3.34, J4.35
/R_15: J2.B12, J3.38, J4.37
/R_48: J2.A38, J3.40, J4.39
/R_49: J2.B38, J3.42, J4.41
GND: J1.A1, J1.A4, J1.A7, J1.A10, J1.A13, J1.A16, J1.A19, J1.A22, J1.A25, J1.A28, J1.A31, J1.A34, J1.A37, J1.A39, J1.A42, J1.A45, J1.B1, J1.B4, J1.B7, J1.B10, J1.B13, J1.B16, J1.B19, J1.B22, J1.B25, J1.B28, J1.B31, J1.B34, J1.B37, J1.B39, J1.B42, J1.B45, J2.A1, J2.A4, J2.A7, J2.A10, J2.A13, J2.A16, J2.A19, J2.A22, J2.A25, J2.A28, J2.A31, J2.A34, J2.A37, J2.A39, J2.A42, J2.A45, J2.B1, J2.B4, J2.B7, J2.B10, J2.B13, J2.B16, J2.B19, J2.B22, J2.B25, J2.B28, J2.B31, J2.B34, J2.B37, J2.B39, J2.B42, J2.B45, J3.1, J3.8, J3.15, J3.22, J3.29, J3.36, J3.43, J3.44, J3.47, J3.48, J4.1, J4.8, J4.15, J4.22, J4.29, J4.36, J4.43, J4.44, J4.47, J4.48

Notes on the sheet:
RX TO MODULE
TX FROM MODULE
RIGHT
LEFT
LEFT <- RIGHT (CONTROLLER ON RIGHT)
RX TO CONTROLLER
TX FROM CONTROLLER
LEFT -> RIGHT (CONTROLLER ON LEFT)

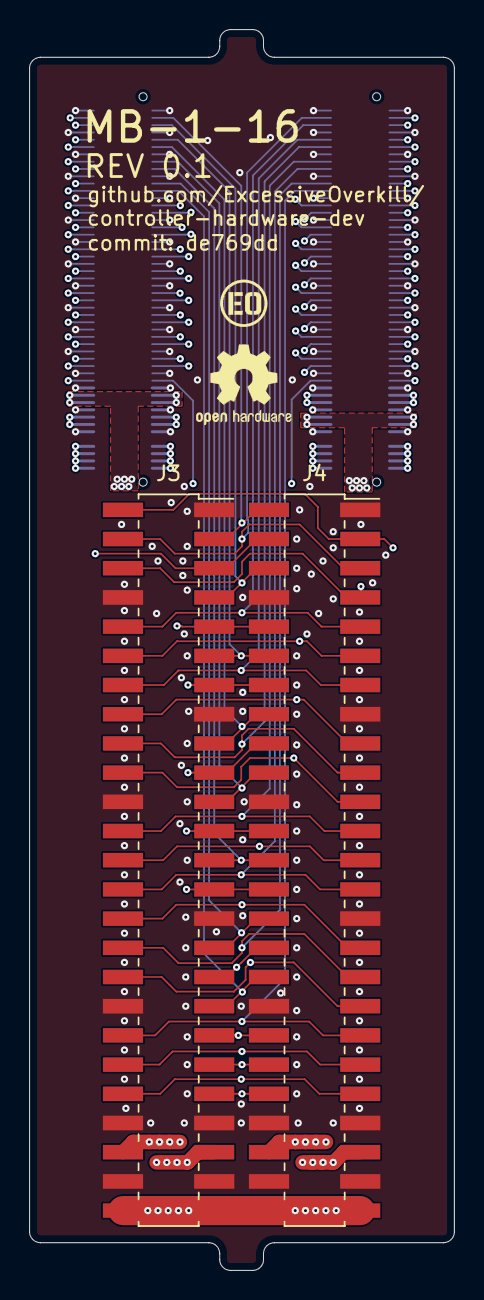
[picture p27: board Mezzanine Backplane.kicad_pcb from above]

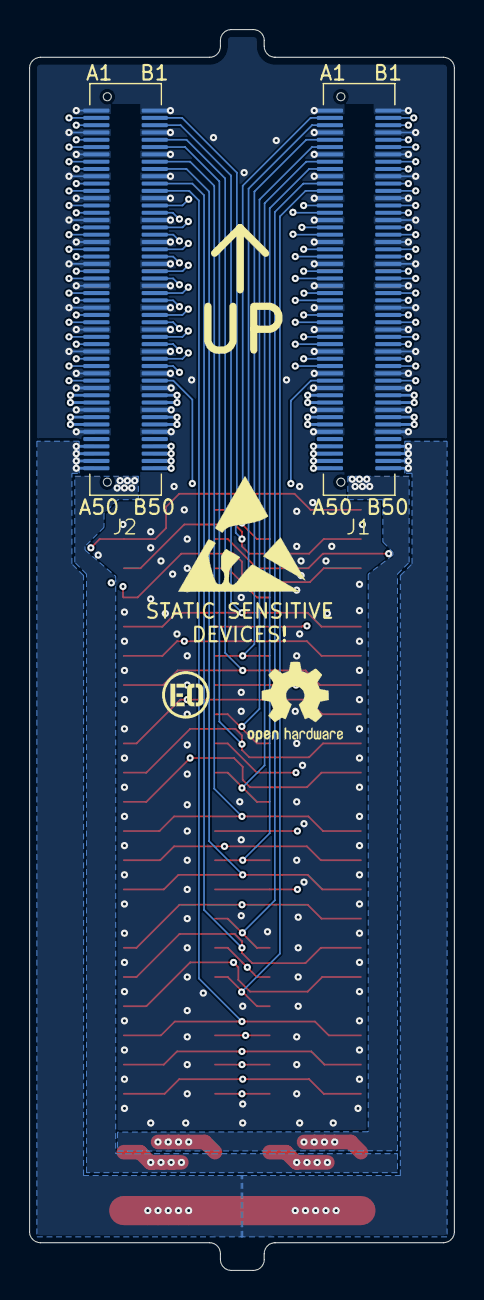
[picture p28: board Mezzanine Backplane.kicad_pcb from below]

Board: 4 copper layers, 29.1 x 85.0 mm, 4 parts (2 on the bottom side), 72 nets.
