ExcessiveOverkill/controller-hardware-dev/KiCad/Motion controller MiYR interface/Motion controller MiYR interface.kicad_pcb

## KiCad design KiCad/Motion controller MiYR interface/Motion controller MiYR interface.kicad_pcb (2026-01-11)

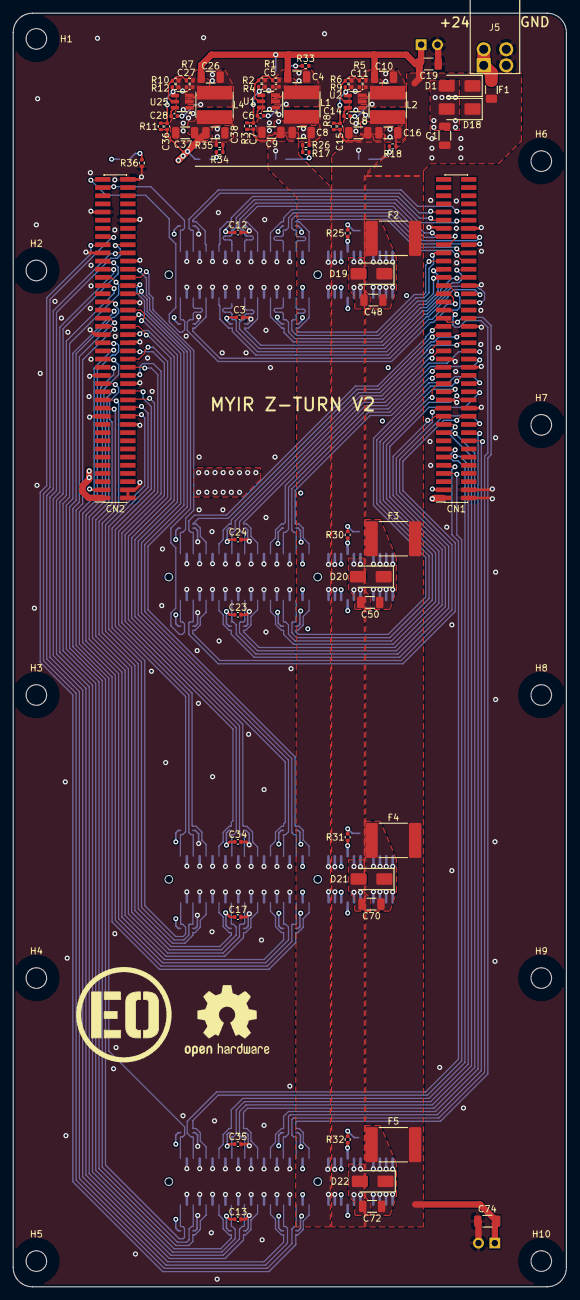
[picture p29: board Motion controller MiYR interface.kicad_pcb from above]

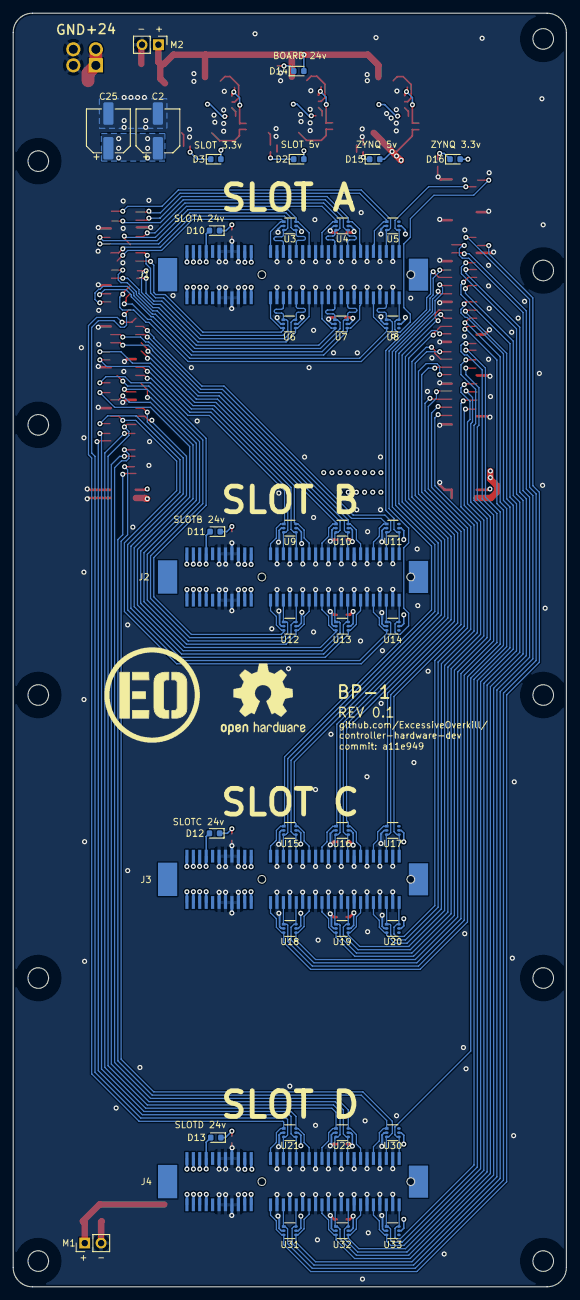
[picture p30: board Motion controller MiYR interface.kicad_pcb from below]

Board: 4 copper layers, 86.0 x 198.0 mm, 127 parts (41 on the bottom side), 122 nets.

Parts:
C1, C19, C48, C50, C70, C72, C74: 10uf; C_1206_3216Metric
C2, C25: 100uf; CP_Elec_6.3x7.7
C3, C5, C6, C11, C12, C13, C14, C17, C23, C24, C27, C28, C34, C35: .1uf; C_0402_1005Metric
C4, C8, C9, C10, C16, C18, C26, C37, C38: 22uf; C_1206_3216Metric
C7, C36: 75pf; C_0402_1005Metric
C15: 56pf; C_0402_1005Metric
CN1, CN2: Conn_02x40_Odd_Even; PinHeader_2x40_P1.27mm_Vertical_SMD_FLIPPED
D1, D18, D19, D20, D21, D22: SS34; D_SMA
D2, D3, D10, D11, D12, D13, D14, D15, D16: LED; LED_0603_1608Metric
F1: 10A; Fuse_1206_3216Metric
F2, F3, F4, F5: 3A; Fuse_2920_7451Metric
H1, H2, H3, H4, H5, H6, H7, H8, H9, H10: MountingHole; MountingHole_3.2mm_M3
J1, J2, J3, J4: 10061913-111PLF; PCI_64_SMD_CONNECTOR
J5: 24v; 2x02_P3.5_KF2EDGSR
L1, L2, L4: 15uH; CY54_INDUCTOR
M1, M2: Fan; PinHeader_1x02_P2.54mm_Vertical
R1, R5, R7: 500k; R_0402_1005Metric
R2, R3, R6, R8, R10, R11: 100k; R_0402_1005Metric
R4, R12, R25, R30, R31, R32, R33: 13.3k; R_0402_1005Metric
R9: 22.1k; R_0402_1005Metric
R17, R18, R26, R34, R35, R36: 1k; R_0402_1005Metric
U1, U2, U25: TPS54202DDC; SOT-23-6
U3, U4, U5, U6, U7, U8, U9, U10, U11, U12, U13, U14, U15, U16, U17, U18, U19, U20, U21, U22, U30, U31, U32, U33: D1213A-04S-7; SOT-363_DIO

Connections:
+3.3V: C3.1, C12.1, C13.1, C17.1, C23.1, C24.1, C34.1, C35.1, CN1.3, CN2.3, D16.2 (A), U3.5 (VCC), U4.5 (VCC), U5.5 (VCC), U6.5 (VCC), U7.5 (VCC), U8.5 (VCC), U9.5 (VCC), U10.5 (VCC), U11.5 (VCC), U12.5 (VCC), U13.5 (VCC), U14.5 (VCC), U15.5 (VCC), U16.5 (VCC), U17.5 (VCC), U18.5 (VCC), U19.5 (VCC), U20.5 (VCC), U21.5 (VCC), U22.5 (VCC), U30.5 (VCC), U31.5 (VCC), U32.5 (VCC), U33.5 (VCC)
+3.3VA: C15.2, C16.2, C18.2, D3.2 (A), J1.P$A10 (A10), J1.P$B10 (B10), J2.P$A10 (A10), J2.P$B10 (B10), J3.P$A10 (A10), J3.P$B10 (B10), J4.P$A10 (A10), J4.P$B10 (B10), L2.2, R8.2
+5V: C36.2, C37.2, C38.2, CN1.1, CN2.1, D15.2 (A), L4.2, R11.2
+5VA: C7.2, C8.2, C9.2, D2.2 (A), J1.P$A11 (A11), J1.P$B11 (B11), J2.P$A11 (A11), J2.P$B11 (B11), J3.P$A11 (A11), J3.P$B11 (B11), J4.P$A11 (A11), J4.P$B11 (B11), L1.2, R3.2
+24V: C1.1, C2.1, C4.2, C5.2, C10.2, C11.2, C19.1, C25.1, C26.2, C27.2, C74.1, D1.1 (K), D14.2 (A), D18.1 (K), F1.2, F2.1, F3.1, F4.1, F5.1, M1.1 (+), M2.1 (+), R1.2, R5.2, R7.2, U1.3 (VIN), U2.3 (VIN), U25.3 (VIN)
GND: C1.2, C2.2, C3.2, C4.1, C5.1, C8.1, C9.1, C10.1, C11.1, C12.2, C13.2, C16.1, C17.2, C18.1, C19.2, C23.2, C24.2, C25.2, C26.1, C27.1, C34.2, C35.2, C37.1, C38.1, C48.2, C50.2, C70.2, C72.2, C74.2, CN1.2, CN1.4, CN1.24, CN1.25, CN1.34, CN1.35, CN1.44, CN1.54, CN1.67, CN1.68, CN2.2, CN2.4, CN2.20, CN2.21, CN2.30, CN2.31, CN2.40, CN2.41, CN2.50, CN2.60, CN2.61, CN2.70, CN2.71, CN2.80, D1.2 (A), D18.2 (A), D19.2 (A), D20.2 (A), D21.2 (A), D22.2 (A), J1.P$A6 (A6), J1.P$A7 (A7), J1.P$A8 (A8), J1.P$A9 (A9), J1.P$A13 (A13), J1.P$A15 (A15), J1.P$A17 (A17), J1.P$A19 (A19), J1.P$A21 (A21), J1.P$A23 (A23), J1.P$A25 (A25), J1.P$A27 (A27), J1.P$A29 (A29), J1.P$A31 (A31), J1.P$B6 (B6), J1.P$B7 (B7), J1.P$B8 (B8), J1.P$B9 (B9), J1.P$B13 (B13), J1.P$B15 (B15), J1.P$B17 (B17), J1.P$B19 (B19), J1.P$B21 (B21), J1.P$B23 (B23), J1.P$B25 (B25), J1.P$B27 (B27), J1.P$B29 (B29), J1.P$B31 (B31), J2.P$A6 (A6), J2.P$A7 (A7), J2.P$A8 (A8), J2.P$A9 (A9), J2.P$A13 (A13), J2.P$A15 (A15), J2.P$A17 (A17), J2.P$A19 (A19), J2.P$A21 (A21), J2.P$A23 (A23), J2.P$A25 (A25), J2.P$A27 (A27), J2.P$A29 (A29), J2.P$A31 (A31), J2.P$B6 (B6), J2.P$B7 (B7), J2.P$B8 (B8), J2.P$B9 (B9), J2.P$B13 (B13), J2.P$B15 (B15), J2.P$B17 (B17), J2.P$B19 (B19), J2.P$B21 (B21), J2.P$B23 (B23), J2.P$B25 (B25), J2.P$B27 (B27), J2.P$B29 (B29), J2.P$B31 (B31), J3.P$A6 (A6), J3.P$A7 (A7), J3.P$A8 (A8), J3.P$A9 (A9), J3.P$A13 (A13), J3.P$A15 (A15), J3.P$A17 (A17), J3.P$A19 (A19), J3.P$A21 (A21), J3.P$A23 (A23), J3.P$A25 (A25), J3.P$A27 (A27), J3.P$A29 (A29), J3.P$A31 (A31), J3.P$B6 (B6), J3.P$B7 (B7), J3.P$B8 (B8), J3.P$B9 (B9), J3.P$B13 (B13), J3.P$B15 (B15), J3.P$B17 (B17), J3.P$B19 (B19), J3.P$B21 (B21), J3.P$B23 (B23), J3.P$B25 (B25), J3.P$B27 (B27), J3.P$B29 (B29), J3.P$B31 (B31), J4.P$A6 (A6), J4.P$A7 (A7), J4.P$A8 (A8), J4.P$A9 (A9), J4.P$A13 (A13), J4.P$A15 (A15), J4.P$A17 (A17), J4.P$A19 (A19), J4.P$A21 (A21), J4.P$A23 (A23), J4.P$A25 (A25), J4.P$A27 (A27), J4.P$A29 (A29), J4.P$A31 (A31), J4.P$B6 (B6), J4.P$B7 (B7), J4.P$B8 (B8), J4.P$B9 (B9), J4.P$B13 (B13), J4.P$B15 (B15), J4.P$B17 (B17), J4.P$B19 (B19), J4.P$B21 (B21), J4.P$B23 (B23), J4.P$B25 (B25), J4.P$B27 (B27), J4.P$B29 (B29), J4.P$B31 (B31), J5.3, J5.4, M1.2 (-), M2.2 (-), R2.1, R4.1, R6.1, R9.1, R10.1, R12.1, R18.1, R25.1, R26.1, R30.1, R31.1, R32.1, R33.1, R35.1, R36.1, U1.1 (GND), U2.1 (GND), U3.2 (GND), U4.2 (GND), U5.2 (GND), U6.2 (GND), U7.2 (GND), U8.2 (GND), U9.2 (GND), U10.2 (GND), U11.2 (GND), U12.2 (GND), U13.2 (GND), U14.2 (GND), U15.2 (GND), U16.2 (GND), U17.2 (GND), U18.2 (GND), U19.2 (GND), U20.2 (GND), U21.2 (GND), U22.2 (GND), U25.1 (GND), U30.2 (GND), U31.2 (GND), U32.2 (GND), U33.2 (GND)
unnamed: D2.1 (K), R17.2
unnamed: D3.1 (K), R18.2
unnamed: D10.1 (K), R25.2
unnamed: D11.1 (K), R30.2
unnamed: D12.1 (K), R31.2
unnamed: D13.1 (K), R32.2
unnamed: D14.1 (K), R33.2
unnamed: D15.1 (K), R34.2
unnamed: D16.1 (K), R36.2
unnamed: F1.1, J5.1, J5.2
unnamed: R17.1, R26.2
unnamed: R34.1, R35.2
unnamed: C6.1, U1.6 (BOOT)
unnamed: R1.1, R2.2, U1.5 (EN)
unnamed: C7.1, R3.1, R4.2, U1.4 (FB)
unnamed: C6.2, L1.1, U1.2 (SW)
unnamed: C14.1, U2.6 (BOOT)
unnamed: R5.1, R6.2, U2.5 (EN)
unnamed: C15.1, R8.1, R9.2, U2.4 (FB)
unnamed: C14.2, L2.1, U2.2 (SW)
unnamed: C28.1, U25.6 (BOOT)
unnamed: R7.1, R10.2, U25.5 (EN)
unnamed: C36.1, R11.1, R12.2, U25.4 (FB)
unnamed: C28.2, L4.1, U25.2 (SW)
SLOT A 24V: C48.1, D10.2 (A), D19.1 (K), F2.2, J1.P$A1 (A1), J1.P$A2 (A2), J1.P$A3 (A3), J1.P$A4 (A4), J1.P$B1 (B1), J1.P$B2 (B2), J1.P$B3 (B3), J1.P$B4 (B4)
SLOT B 24V: C50.1, D11.2 (A), D20.1 (K), F3.2, J2.P$A1 (A1), J2.P$A2 (A2), J2.P$A3 (A3), J2.P$A4 (A4), J2.P$B1 (B1), J2.P$B2 (B2), J2.P$B3 (B3), J2.P$B4 (B4)
SLOT C 24V: C70.1, D12.2 (A), D21.1 (K), F4.2, J3.P$A1 (A1), J3.P$A2 (A2), J3.P$A3 (A3), J3.P$A4 (A4), J3.P$B1 (B1), J3.P$B2 (B2), J3.P$B3 (B3), J3.P$B4 (B4)
SLOT D 24V: C72.1, D13.2 (A), D22.1 (K), F5.2, J4.P$A1 (A1), J4.P$A2 (A2), J4.P$A3 (A3), J4.P$A4 (A4), J4.P$B1 (B1), J4.P$B2 (B2), J4.P$B3 (B3), J4.P$B4 (B4)
SLOTA1N: CN1.62, J1.P$A14 (A14), U3.3 (CH2)
SLOTA1P: CN1.60, J1.P$A12 (A12), U3.1 (CH1)
SLOTA2N: CN1.66, J1.P$A18 (A18), U3.6 (CH4)
SLOTA2P: CN1.64, J1.P$A16 (A16), U3.4 (CH3)
SLOTA3N: CN1.65, J1.P$A22 (A22), U4.3 (CH2)
SLOTA3P: CN1.63, J1.P$A20 (A20), U4.1 (CH1)
SLOTA4N: CN1.69, J1.P$A26 (A26), U4.6 (CH4)
SLOTA4P: CN1.70, J1.P$A24 (A24), U4.4 (CH3)
SLOTA5N: CN1.72, J1.P$A30 (A30), U5.3 (CH2)
SLOTA5P: CN1.71, J1.P$A28 (A28), U5.1 (CH1)
SLOTA6N: CN1.61, J1.P$B14 (B14), U6.1 (CH1)
SLOTA6P: CN1.59, J1.P$B12 (B12), U6.3 (CH2)
SLOTA7N: CN1.57, J1.P$B18 (B18), U6.4 (CH3)
SLOTA7P: CN1.55, J1.P$B16 (B16), U6.6 (CH4)
SLOTA8N: CN1.58, J1.P$B22 (B22), U7.1 (CH1)
SLOTA8P: CN1.56, J1.P$B20 (B20), U7.3 (CH2)
SLOTA9N: CN1.52, J1.P$B26 (B26), U7.4 (CH3)
SLOTA9P: CN1.50, J1.P$B24 (B24), U7.6 (CH4)
SLOTA10N: CN1.53, J1.P$B30 (B30), U8.1 (CH1)
SLOTA10P: CN1.51, J1.P$B28 (B28), U8.3 (CH2)
SLOTA11N: CN2.79, J1.P$B32 (B32), U8.6 (CH4)
SLOTA11P: CN2.77, J1.P$A32 (A32), U5.4 (CH3)
SLOTB1N: CN1.33, J2.P$A14 (A14), U9.3 (CH2)
SLOTB1P: CN1.31, J2.P$A12 (A12), U9.1 (CH1)
SLOTB2N: CN1.38, J2.P$A18 (A18), U9.6 (CH4)
SLOTB2P: CN1.36, J2.P$A16 (A16), U9.4 (CH3)
SLOTB3N: CN1.39, J2.P$A22 (A22), U10.3 (CH2)
SLOTB3P: CN1.37, J2.P$A20 (A20), U10.1 (CH1)
SLOTB4N: CN1.42, J2.P$A26 (A26), U10.6 (CH4)
SLOTB4P: CN1.40, J2.P$A24 (A24), U10.4 (CH3)
SLOTB5N: CN1.43, J2.P$A30 (A30), U11.3 (CH2)
SLOTB5P: CN1.41, J2.P$A28 (A28), U11.1 (CH1)
SLOTB6N: CN1.32, J2.P$B14 (B14), U12.1 (CH1)
SLOTB6P: CN1.30, J2.P$B12 (B12), U12.3 (CH2)
SLOTB7N: CN1.29, J2.P$B18 (B18), U12.4 (CH3)
SLOTB7P: CN1.27, J2.P$B16 (B16), U12.6 (CH4)
SLOTB8N: CN1.28, J2.P$B22 (B22), U13.1 (CH1)
SLOTB8P: CN1.26, J2.P$B20 (B20), U13.3 (CH2)
SLOTB9N: CN1.23, J2.P$B26 (B26), U13.4 (CH3)
SLOTB9P: CN1.21, J2.P$B24 (B24), U13.6 (CH4)
SLOTB10N: CN1.22, J2.P$B30 (B30), U14.1 (CH1)
SLOTB10P: CN1.20, J2.P$B28 (B28), U14.3 (CH2)
SLOTB11N: CN2.58, J2.P$B32 (B32), U14.6 (CH4)
SLOTB11P: CN2.56, J2.P$A32 (A32), U11.4 (CH3)
SLOTC1N: CN2.54, J3.P$A14 (A14), U15.3 (CH2)
SLOTC1P: CN2.52, J3.P$A12 (A12), U15.1 (CH1)
SLOTC2N: CN2.48, J3.P$A18 (A18), U15.6 (CH4)
SLOTC2P: CN2.46, J3.P$A16 (A16), U15.4 (CH3)
SLOTC3N: CN2.44, J3.P$A22 (A22), U16.3 (CH2)
SLOTC3P: CN2.42, J3.P$A20 (A20), U16.1 (CH1)
SLOTC4N: CN2.38, J3.P$A26 (A26), U16.6 (CH4)
SLOTC4P: CN2.36, J3.P$A24 (A24), U16.4 (CH3)
SLOTC5N: CN2.34, J3.P$A30 (A30), U17.3 (CH2)
SLOTC5P: CN2.32, J3.P$A28 (A28), U17.1 (CH1)
SLOTC6N: CN2.39, J3.P$B14 (B14), U18.1 (CH1)
SLOTC6P: CN2.37, J3.P$B12 (B12), U18.3 (CH2)
SLOTC7N: CN2.35, J3.P$B18 (B18), U18.4 (CH3)
SLOTC7P: CN2.33, J3.P$B16 (B16), U18.6 (CH4)
SLOTC8N: CN2.29, J3.P$B22 (B22), U19.1 (CH1)
SLOTC8P: CN2.27, J3.P$B20 (B20), U19.3 (CH2)
SLOTC9N: CN2.25, J3.P$B26 (B26), U19.4 (CH3)
SLOTC9P: CN2.23, J3.P$B24 (B24), U19.6 (CH4)
SLOTC10N: CN2.24, J3.P$B30 (B30), U20.1 (CH1)
SLOTC10P: CN2.22, J3.P$B28 (B28), U20.3 (CH2)
SLOTC11N: CN2.28, J3.P$B32 (B32), U20.6 (CH4)
SLOTC11P: CN2.26, J3.P$A32 (A32), U17.4 (CH3)
SLOTD1N: CN1.47, J4.P$A14 (A14), U21.3 (CH2)
SLOTD1P: CN1.45, J4.P$A12 (A12), U21.1 (CH1)
SLOTD2N: CN1.18, J4.P$A18 (A18), U21.6 (CH4)
SLOTD2P: CN1.16, J4.P$A16 (A16), U21.4 (CH3)
SLOTD3N: CN1.19, J4.P$A22 (A22), U22.3 (CH2)
SLOTD3P: CN1.17, J4.P$A20 (A20), U22.1 (CH1)
SLOTD4N: CN1.13, J4.P$A26 (A26), U22.6 (CH4)
SLOTD4P: CN1.11, J4.P$A24 (A24), U22.4 (CH3)
SLOTD5N: CN1.9, J4.P$A30 (A30), U30.3 (CH2)
SLOTD5P: CN1.7, J4.P$A28 (A28), U30.1 (CH1)
SLOTD6N: CN2.65, J4.P$B14 (B14), U31.1 (CH1)
SLOTD6P: CN2.63, J4.P$B12 (B12), U31.3 (CH2)
SLOTD7N: CN2.64, J4.P$B18 (B18), U31.4 (CH3)
SLOTD7P: CN2.62, J4.P$B16 (B16), U31.6 (CH4)
SLOTD8N: CN2.59, J4.P$B22 (B22), U32.1 (CH1)
SLOTD8P: CN2.57, J4.P$B20 (B20), U32.3 (CH2)
SLOTD9N: CN2.55, J4.P$B26 (B26), U32.4 (CH3)
SLOTD9P: CN2.53, J4.P$B24 (B24), U32.6 (CH4)
SLOTD10N: CN2.49, J4.P$B30 (B30), U33.1 (CH1)
SLOTD10P: CN2.47, J4.P$B28 (B28), U33.3 (CH2)
SLOTD11N: CN2.45, J4.P$B32 (B32), U33.6 (CH4)
SLOTD11P: CN2.43, J4.P$A32 (A32), U30.4 (CH3)
