ExcessiveOverkill/controller-hardware-dev/(commit log)

2026-01-11 add modular boards
    [Mezzanine Backplane.kicad_pcb, Mezzanine Backplane.kicad_sch, Mezzanine jumper.kicad_pcb, Mezzanine jumper.kicad_sch, Modular MiYR interface.kicad_pcb, Modular MiYR interface.kicad_sch, Motion controller MiYR interface.kicad_pcb, Motion controller MiYR interface.kicad_sch]
2026-01-15 update boards
    [16x Card Module.kicad_pcb, 16x Card Module.kicad_sch, 16x Card Module.step, ESD_diodes.kicad_sch, FPGA_Connector.kicad_sch, MCU.kicad_sch, Main Mezzanine Backplane.kicad_pcb, Main Mezzanine Backplane.kicad_sch]
2026-01-15 fix jumper
    [Main Mezzanine Backplane-B_Cu.gbr, Main Mezzanine Backplane-B_Mask.gbr, Main Mezzanine Backplane-B_Paste.gbr, Main Mezzanine Backplane-B_Silkscreen.gbr, Main Mezzanine Backplane-Edge_Cuts.gbr, Main Mezzanine Backplane-F_Cu.gbr, Main Mezzanine Backplane-F_Mask.gbr, Main Mezzanine Backplane-F_Paste.gbr]
2026-05-09 work on serial module
    [FPGA_Connector.kicad_sch, MCU.kicad_sch, Serial Module.kicad_pcb, Serial Module.kicad_sch, port_power.kicad_sch, transceiver_pair.kicad_sch, transceivers.kicad_sch]
2026-10-23 add current limit and sense parts, add possible endat solution
2026-10-23 Serial Module: review fixes, full BOM part numbers, stock footprints
    Schematic fixes:
    - +24V_PORT tied to +24V; STM32 VBAT tied to VDD
    - Pull-ups on CONFIG15-18 and on bias-buffer OE inputs; pull-downs on PC13/PC14
    - CONFIG_UPDATE moved from PC15 to PC7; VCXO Vcon biased to 1.65 V
    - RJ45 LED anodes moved from 5V_LOGIC to 3.3V
    - 74LVC125 units kept within one transceiver-pair instance; fixed pair-1
    annotation (U27/U28 units) that shorted MUX_B to DI_B in the netlist
    - 5 V bias buffers changed to TI SN74ACT125PWR (TTL inputs, 4.5-5.5 V)
    - Current-limit NMOS changed to AO3400A (Transistor_FET symbol, SOT-23 G/S/D)
    - 24 V input TVS changed to TI TVS2700DRVR flat-clamp (27 V standoff,
    35 V ma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
2026-10-23 Serial Module: move 3.3 V 74LVC125 buffers back to 2.5x3 mm DHVQFN-14
    The 32 3.3 V buffers return to Nexperia 74LVC125ABQ,115 (LCSC C282343,
    DHVQFN-14 2.5x3 mm) from TI SN74LVC125APWR (TSSOP-14) to recover board
    area. TI's same-size SN74LVC125ABQAR has only ~96 units at LCSC.
